giacomobuzi/manipmasta/cad/drawings/png/T00_Copertina_e_indice.png

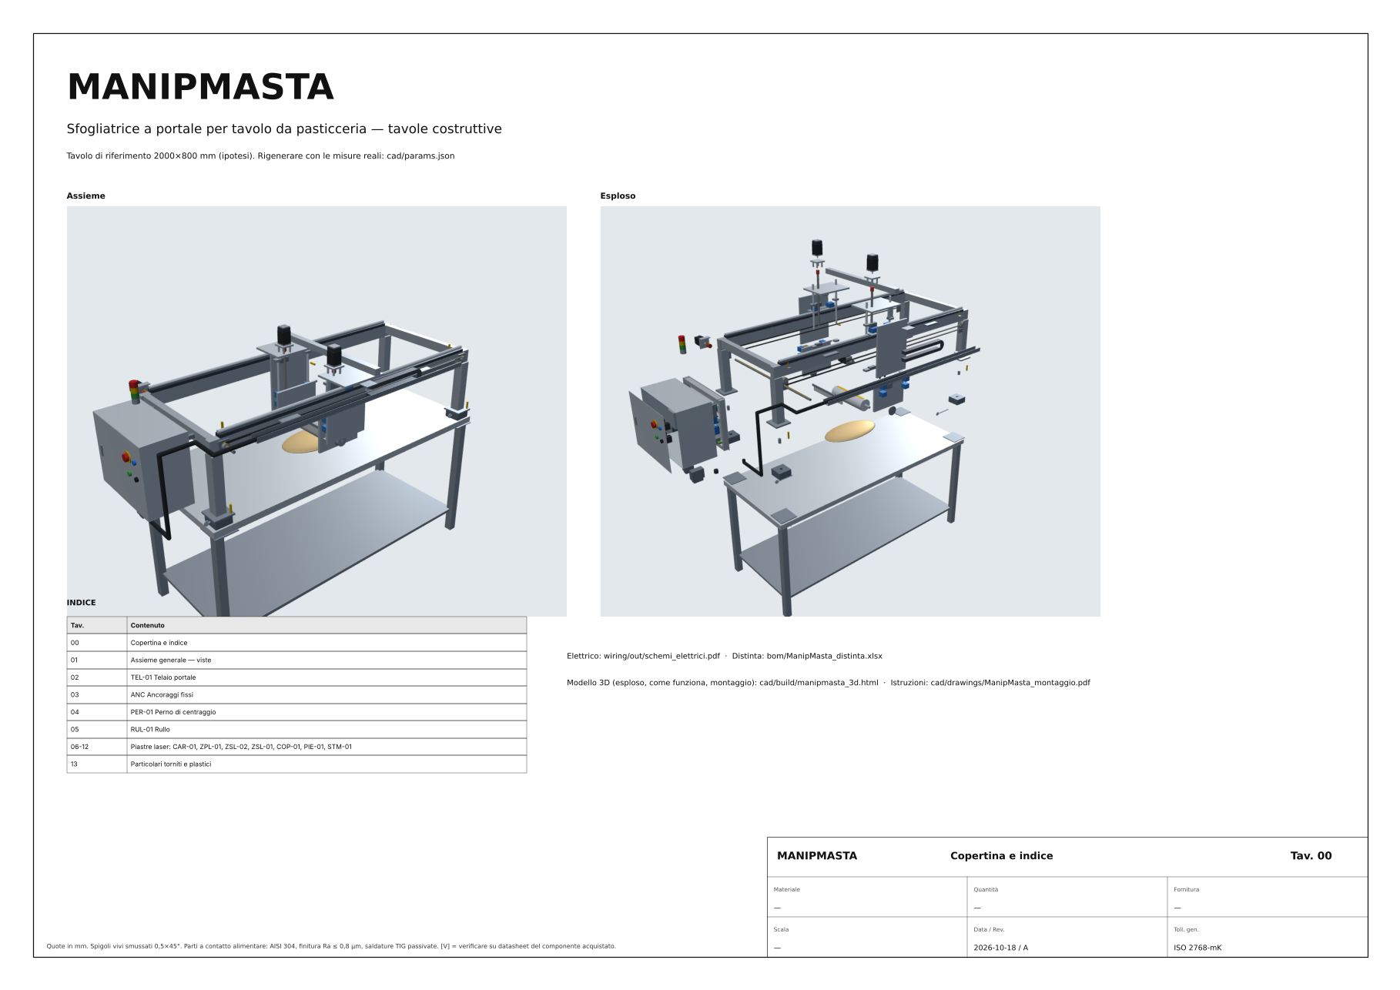
cad/drawings/png/T00_Copertina_e_indice.png
