giacomobuzi/manipmasta/cad/drawings/png/T01_Assieme_generale___viste.png

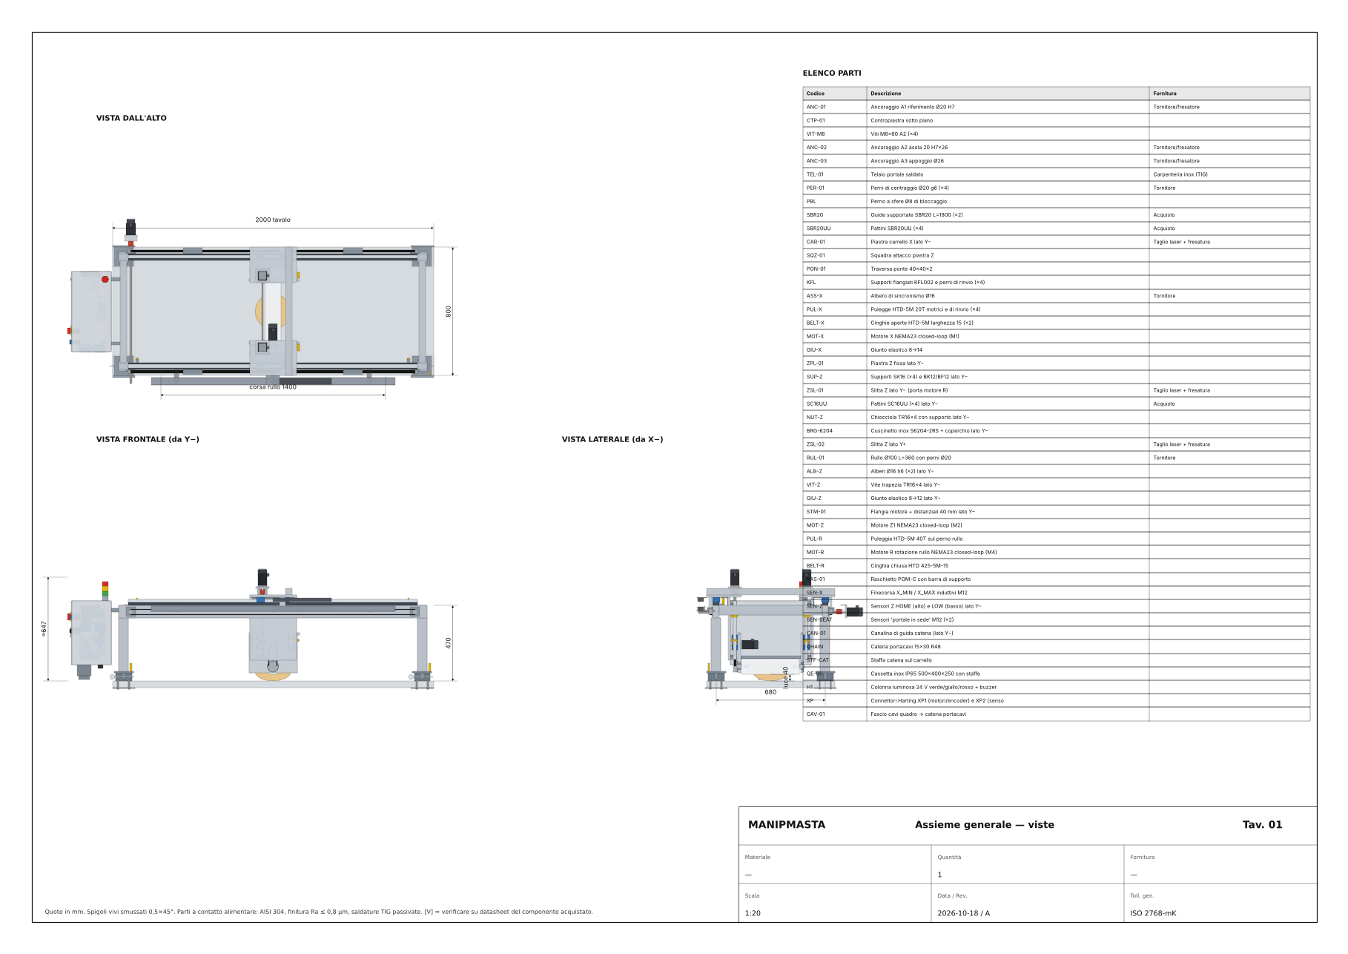
cad/drawings/png/T01_Assieme_generale___viste.png
