giacomobuzi/manipmasta/cad/drawings/png/T02_TEL_01_Telaio_portale_saldato.png

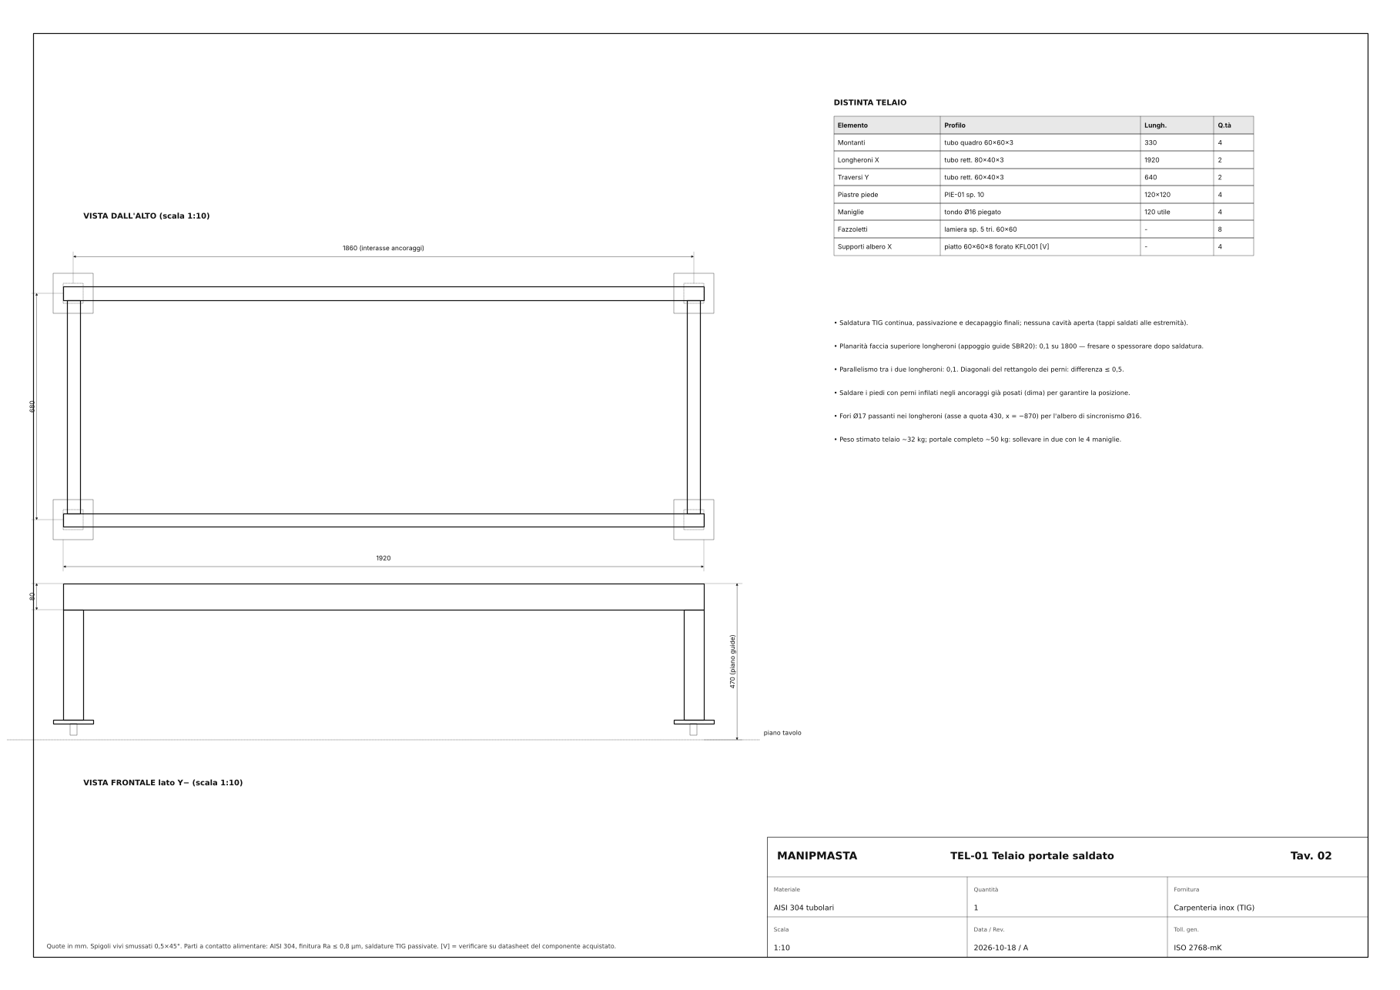
cad/drawings/png/T02_TEL_01_Telaio_portale_saldato.png
