giacomobuzi/manipmasta/cad/drawings/png/T03_ANC_01_02_03_Ancoraggi_fissi_al_tavolo.png

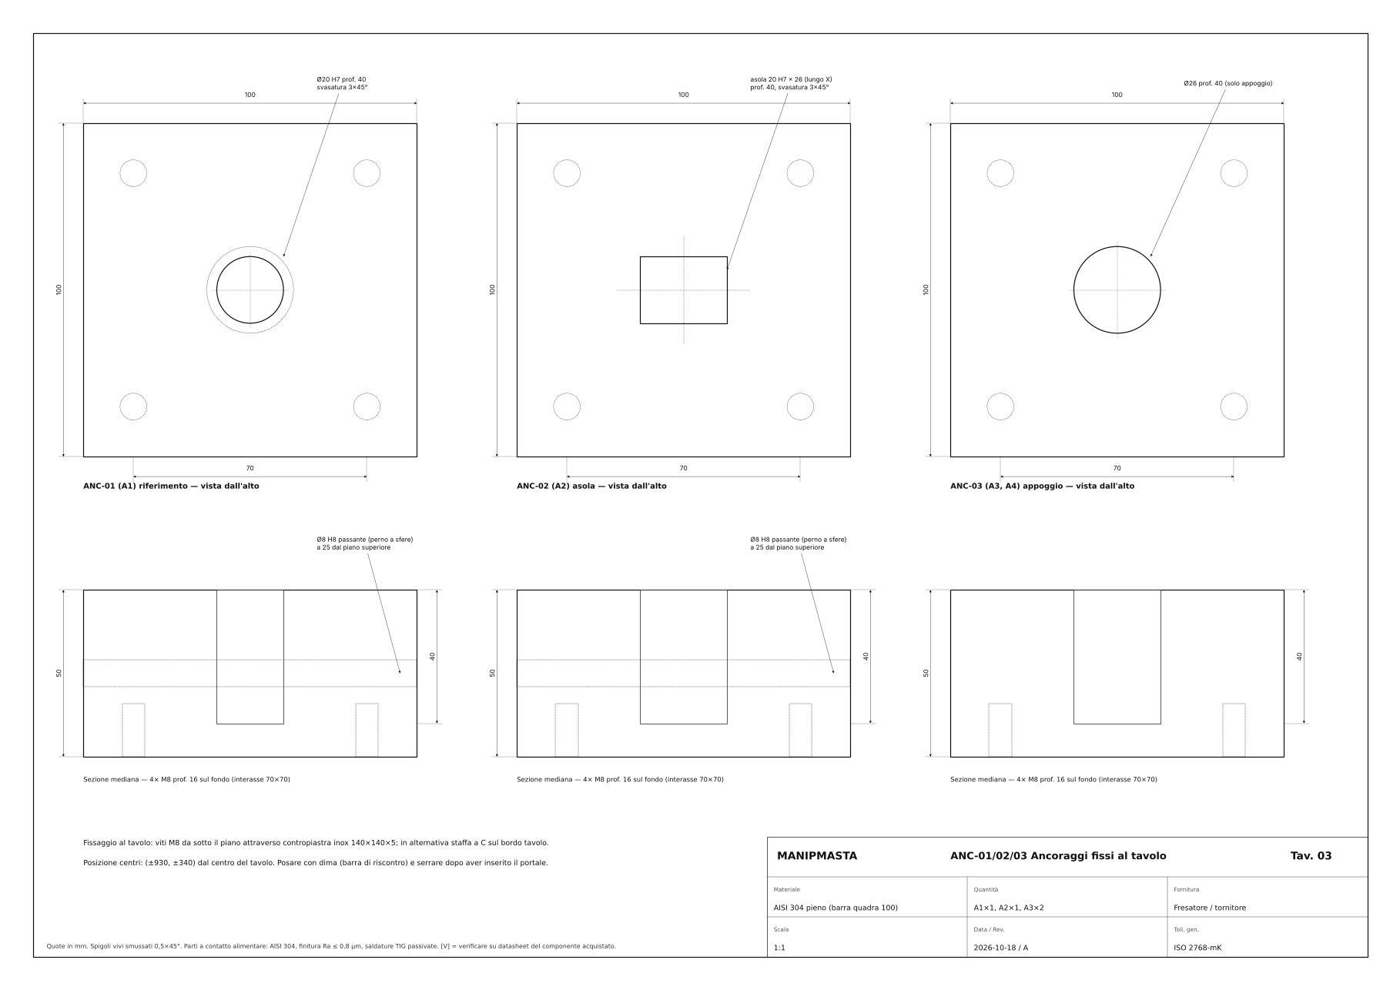
cad/drawings/png/T03_ANC_01_02_03_Ancoraggi_fissi_al_tavolo.png
