giacomobuzi/manipmasta/cad/drawings/png/T04_PER_01_Perno_di_centraggio.png

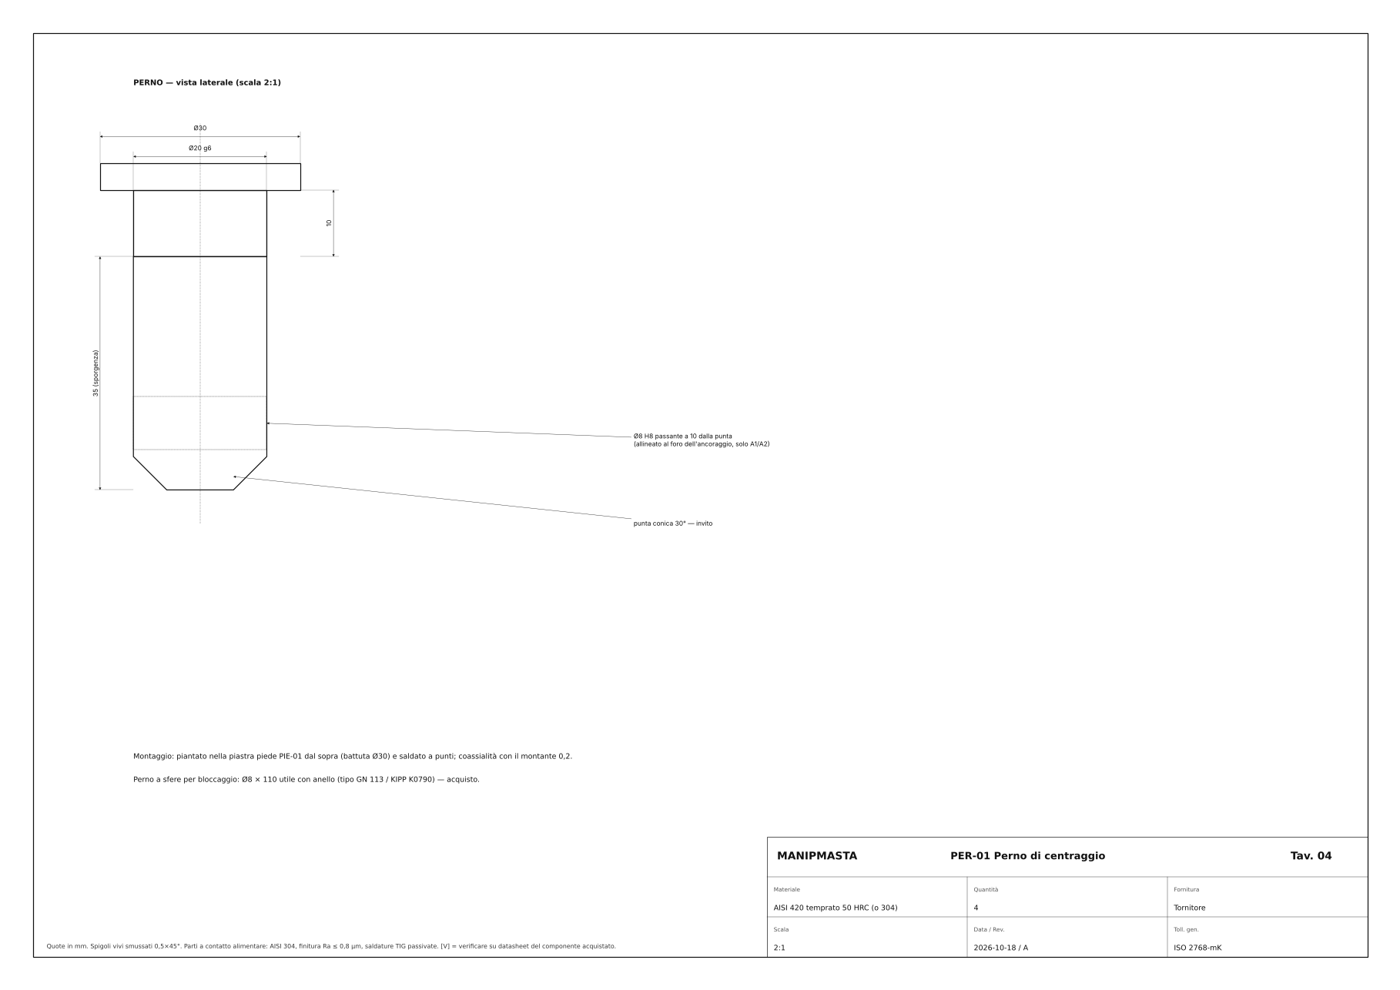
cad/drawings/png/T04_PER_01_Perno_di_centraggio.png
