giacomobuzi/manipmasta/cad/drawings/png/T05_RUL_01_Rullo_di_laminazione.png

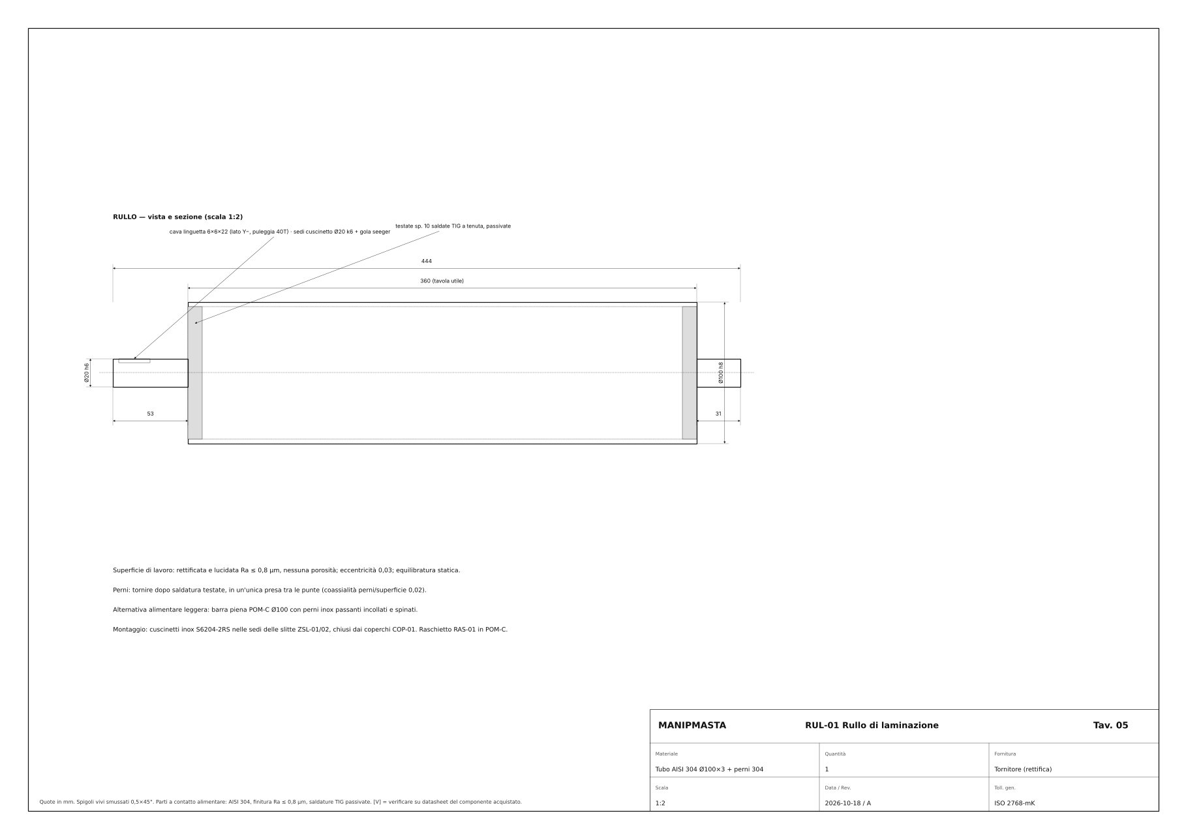
cad/drawings/png/T05_RUL_01_Rullo_di_laminazione.png
