giacomobuzi/manipmasta/cad/drawings/png/T06_CAR_01_Piastra_carrello_X.png

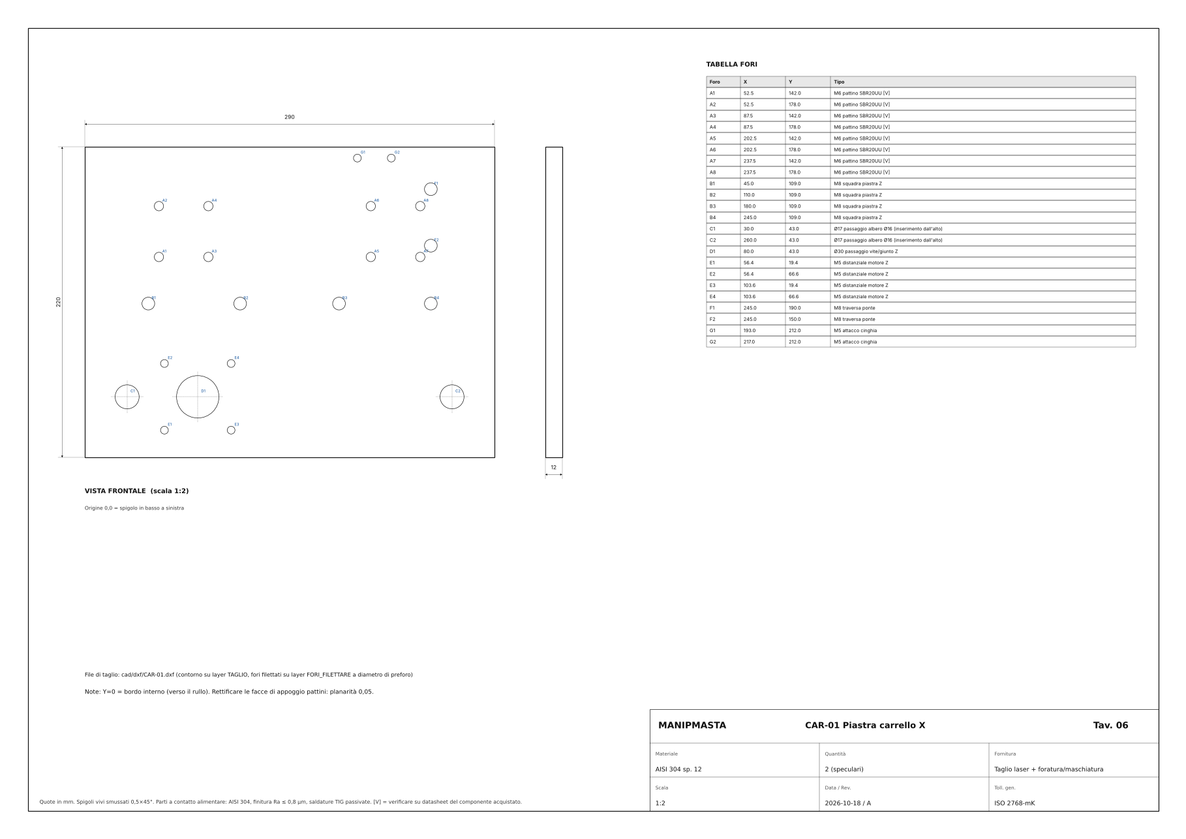
cad/drawings/png/T06_CAR_01_Piastra_carrello_X.png
