giacomobuzi/manipmasta/cad/drawings/png/T07_ZPL_01_Piastra_Z_fissa.png

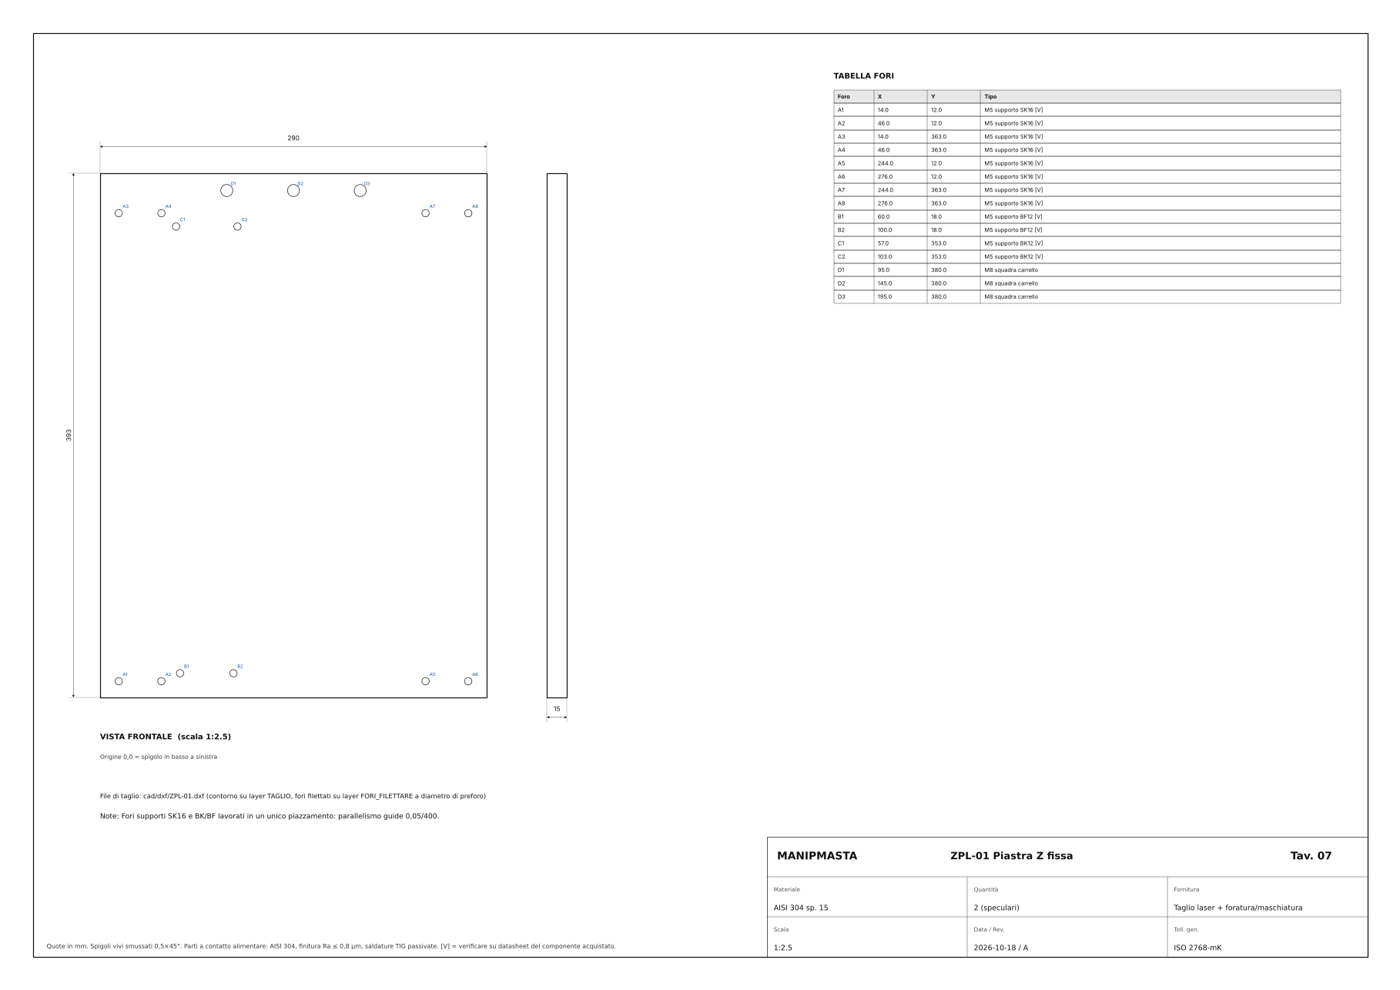
cad/drawings/png/T07_ZPL_01_Piastra_Z_fissa.png
