giacomobuzi/manipmasta/cad/drawings/png/T08_ZSL_02_Slitta_Z_lato_Y___Z2_.png

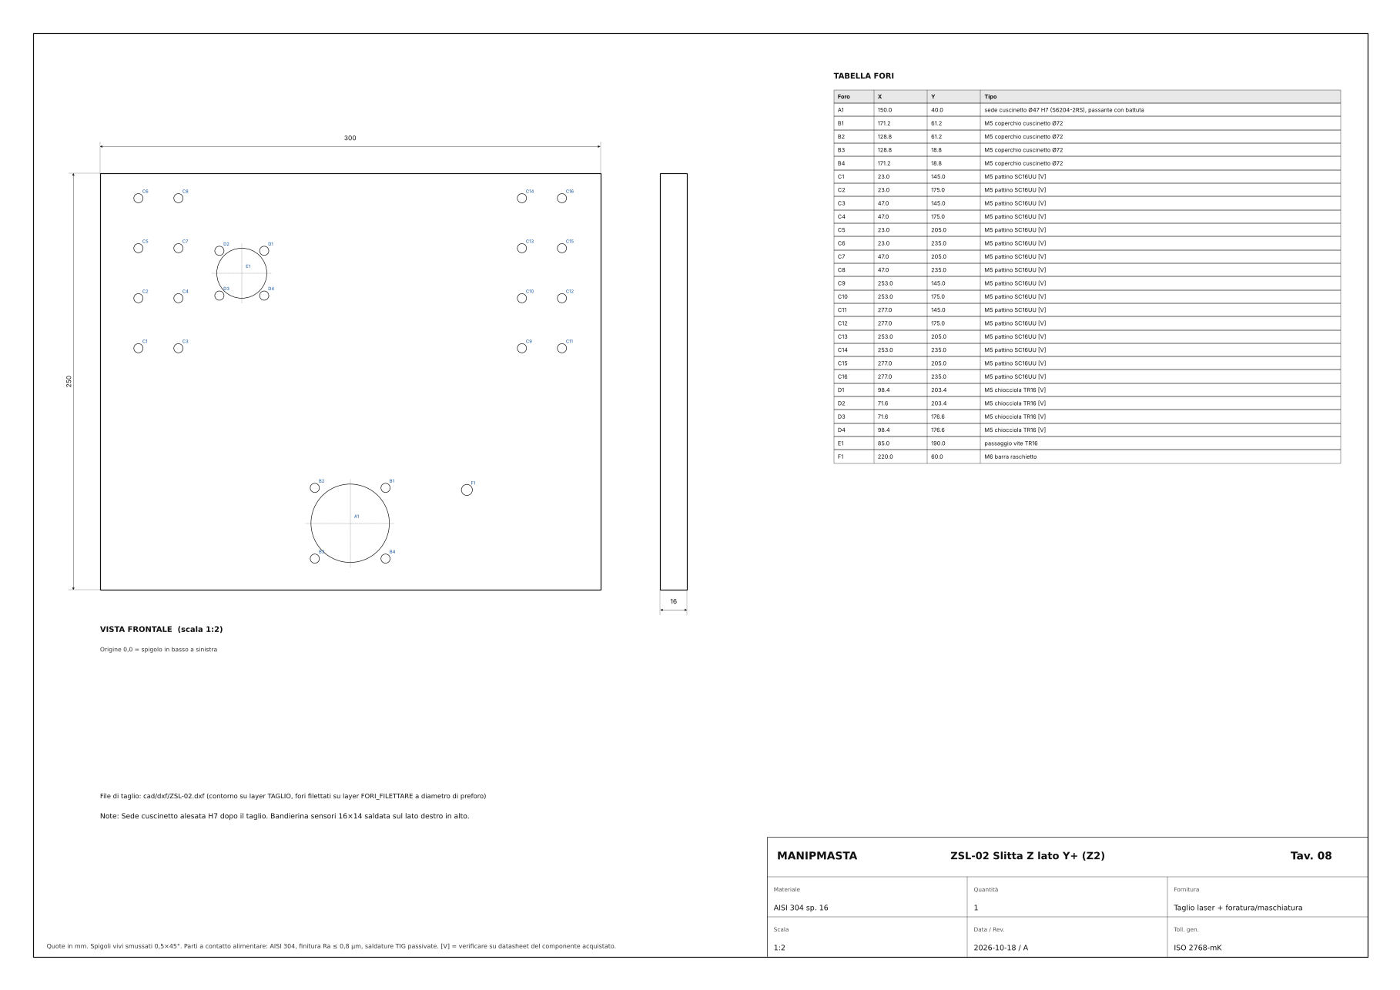
cad/drawings/png/T08_ZSL_02_Slitta_Z_lato_Y___Z2_.png
