giacomobuzi/manipmasta/cad/drawings/png/T09_ZSL_01_Slitta_Z_lato_Y___Z1__con_motore_.png

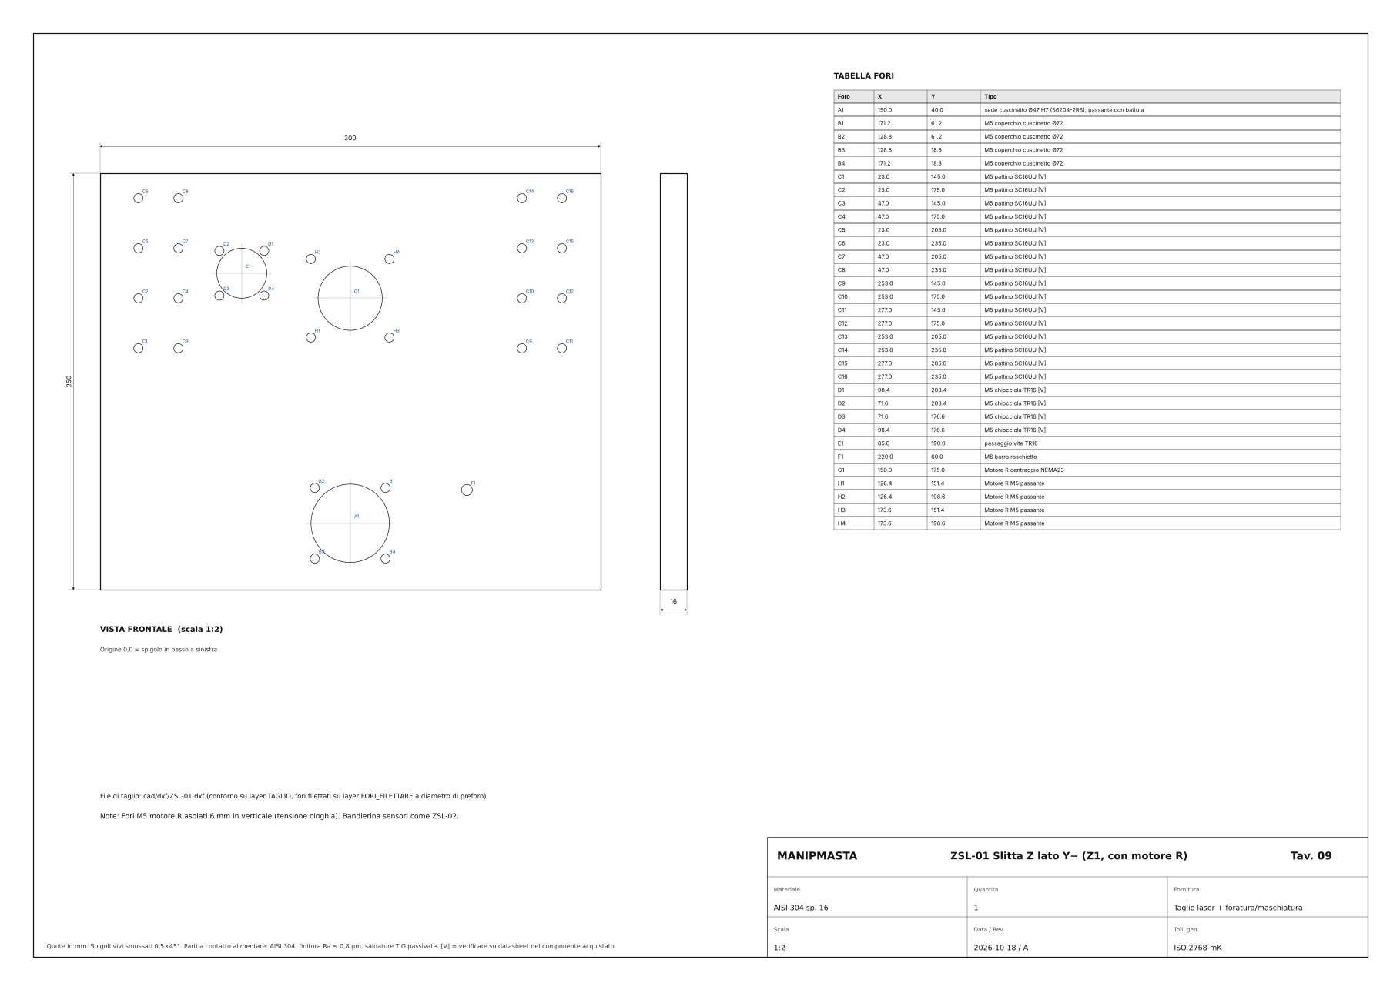
cad/drawings/png/T09_ZSL_01_Slitta_Z_lato_Y___Z1__con_motore_.png
