giacomobuzi/manipmasta/cad/drawings/png/T10_COP_01_Coperchio_cuscinetto_Ø72__disegna.png

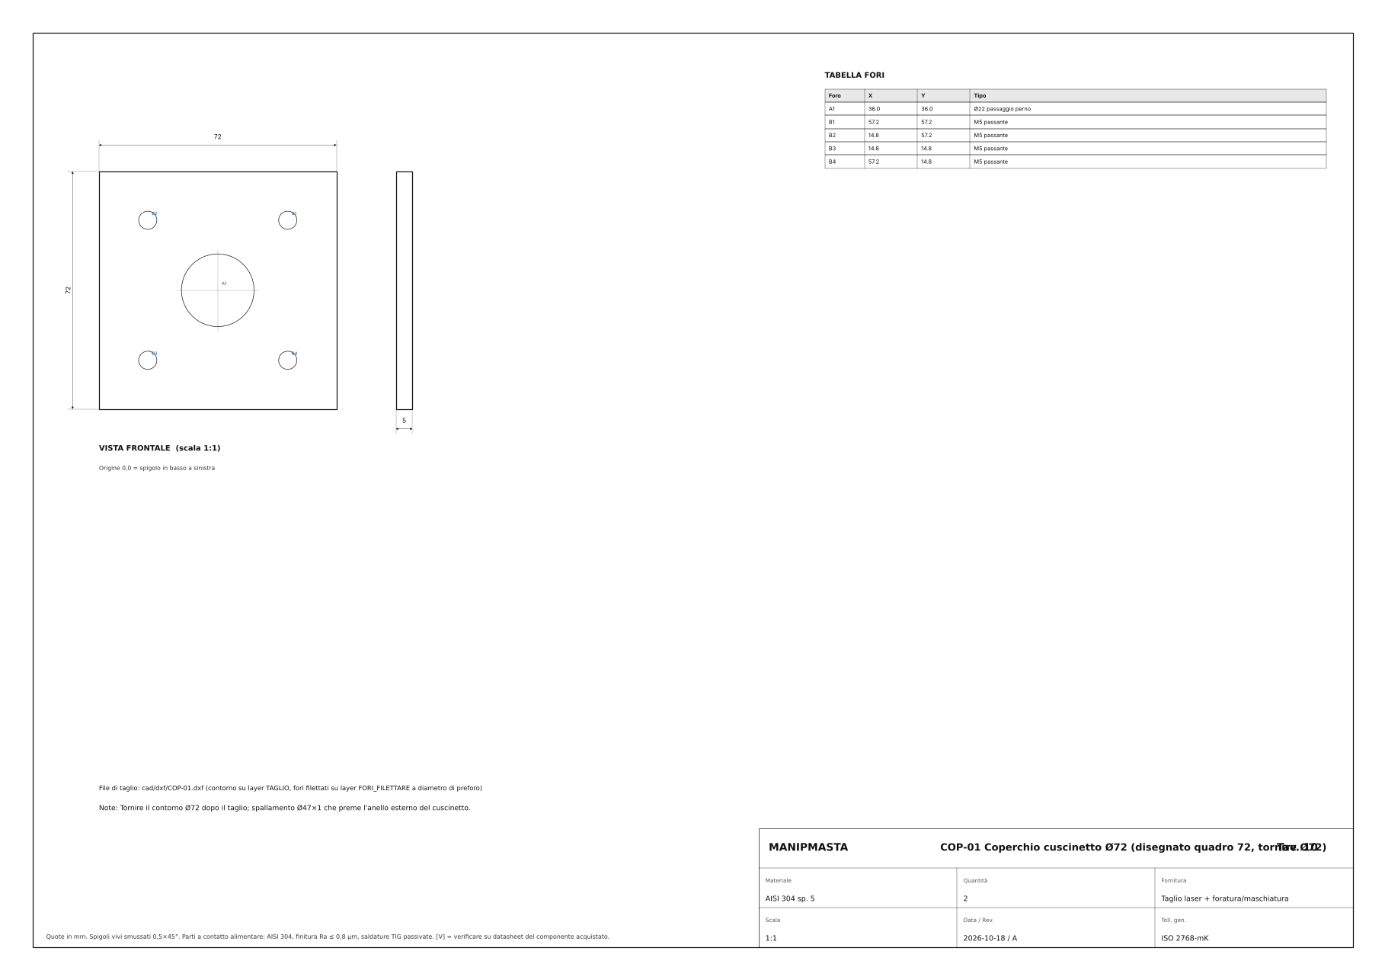
cad/drawings/png/T10_COP_01_Coperchio_cuscinetto_Ø72__disegna.png
