giacomobuzi/manipmasta/cad/drawings/png/T11_PIE_01_Piastra_piede_montante.png

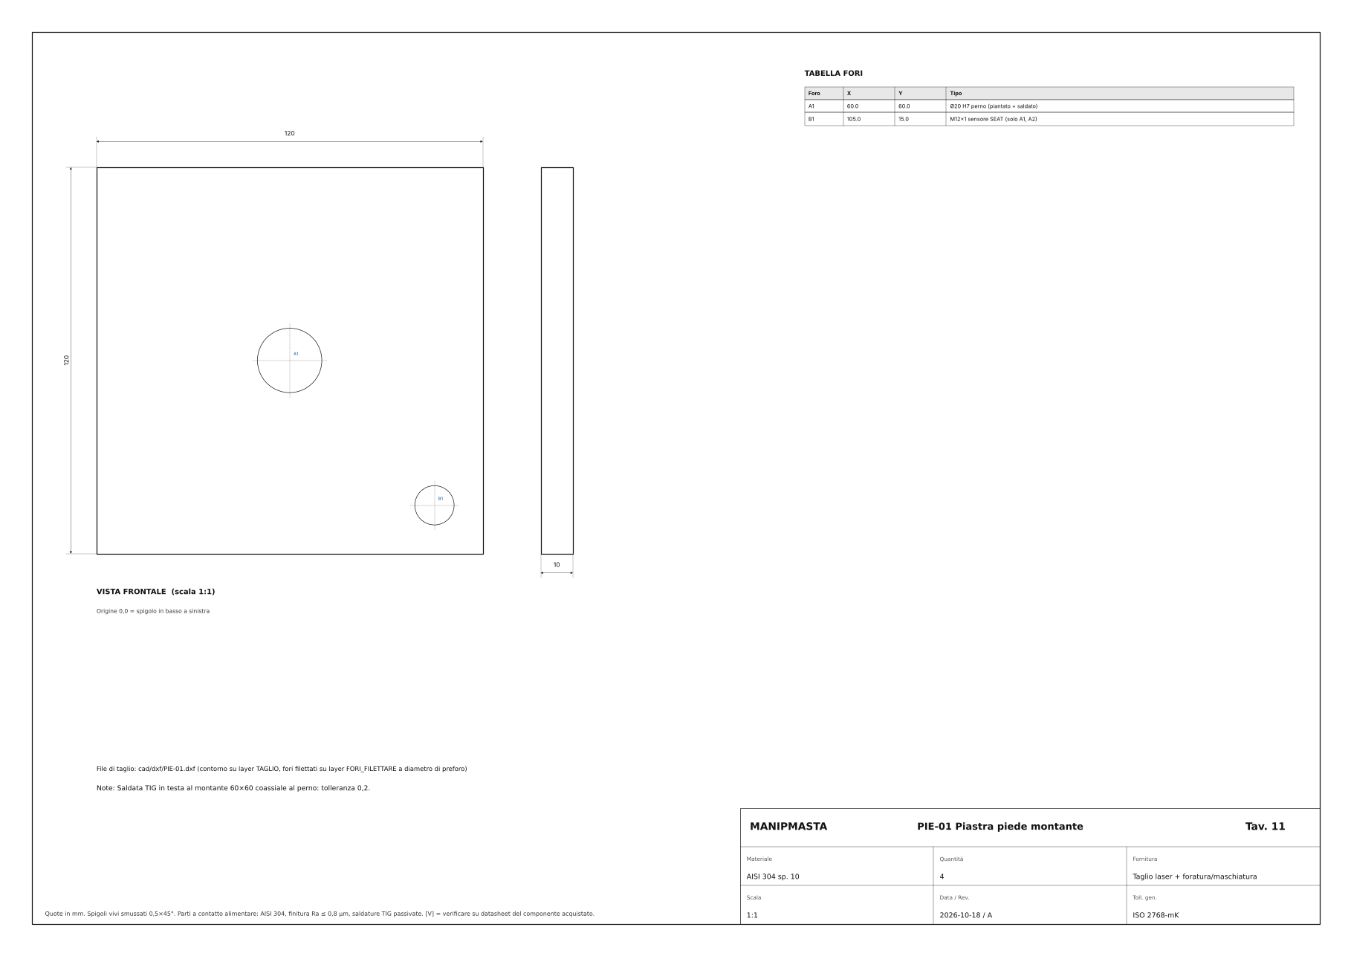
cad/drawings/png/T11_PIE_01_Piastra_piede_montante.png
