giacomobuzi/manipmasta/cad/drawings/png/T12_STM_01_Flangia_motore_NEMA23.png

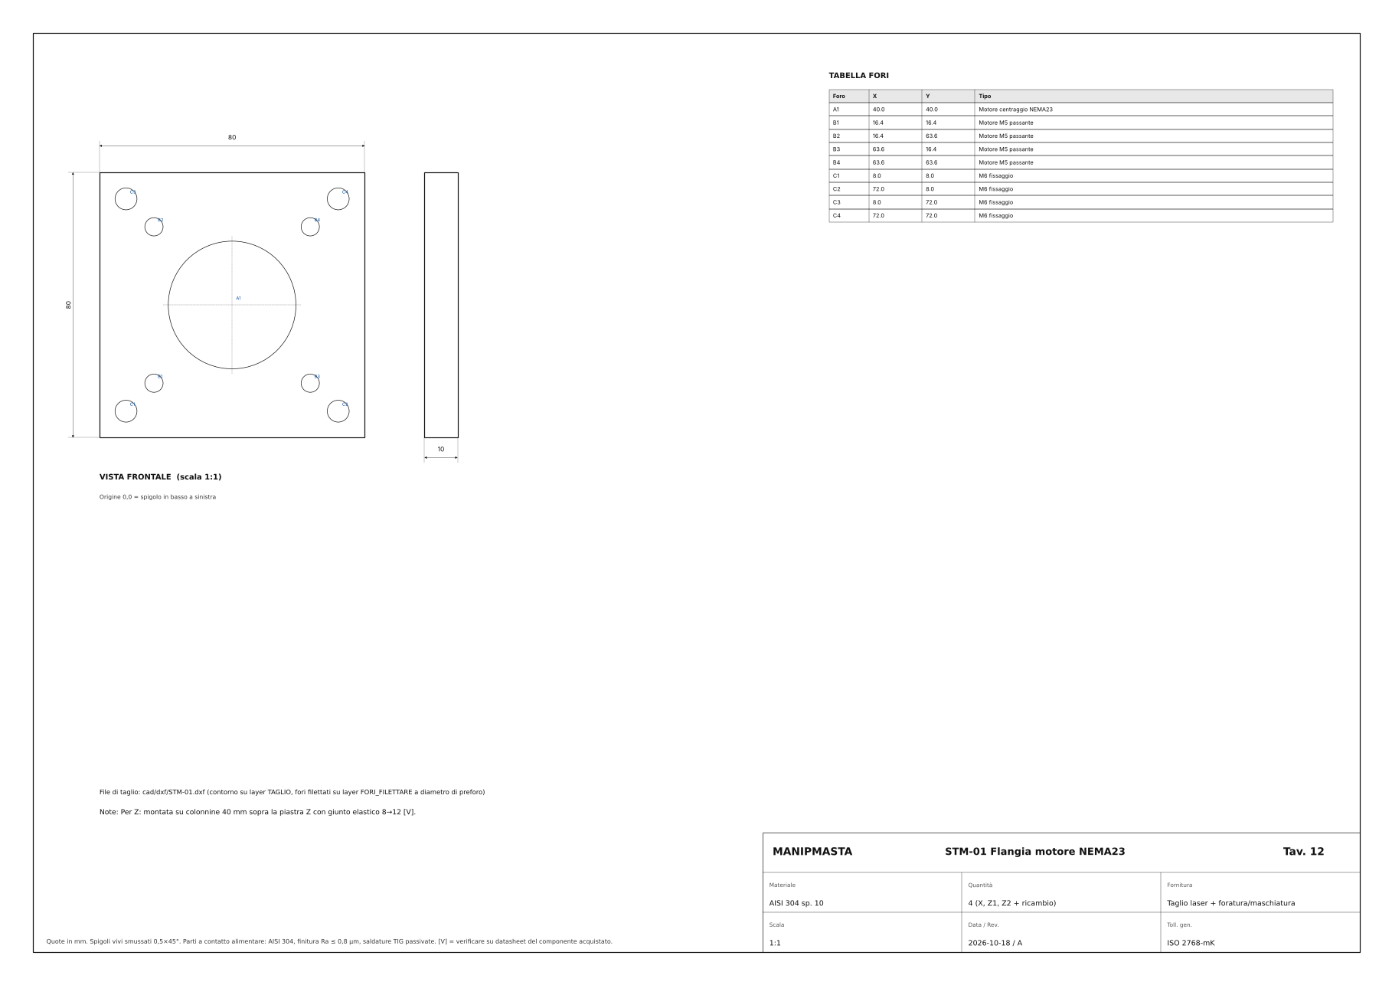
cad/drawings/png/T12_STM_01_Flangia_motore_NEMA23.png
