giacomobuzi/manipmasta/cad/drawings/png/T13_Particolari_torniti_e_plastici.png

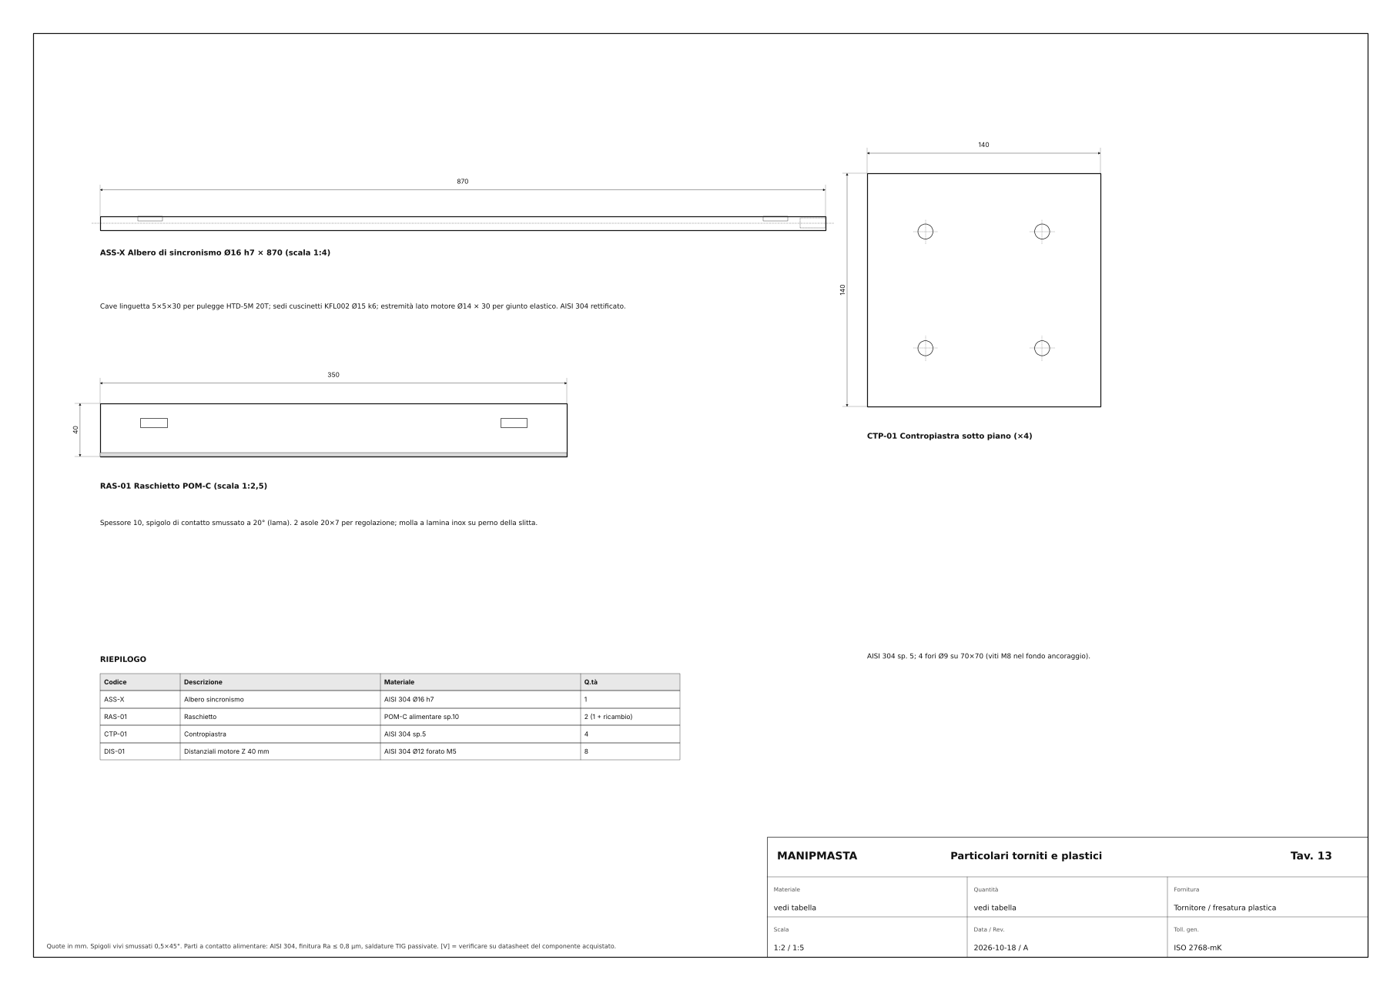
cad/drawings/png/T13_Particolari_torniti_e_plastici.png
