giacomobuzi/manipmasta/docs/img/funziona_ciclo.png

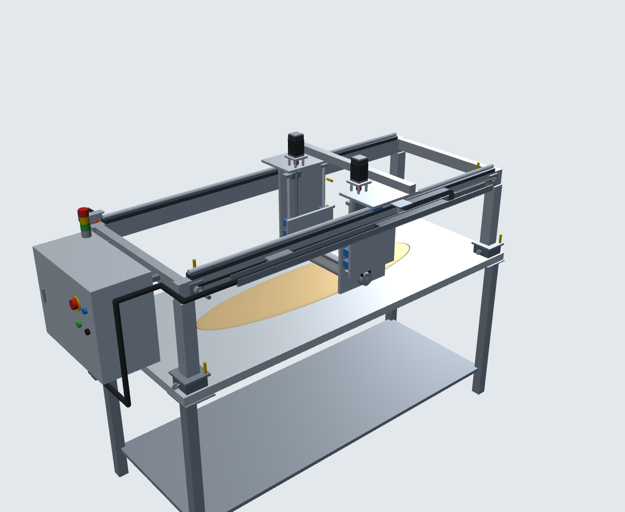
docs/img/funziona_ciclo.png
