giacomobuzi/manipmasta/docs/img/funziona_r.png

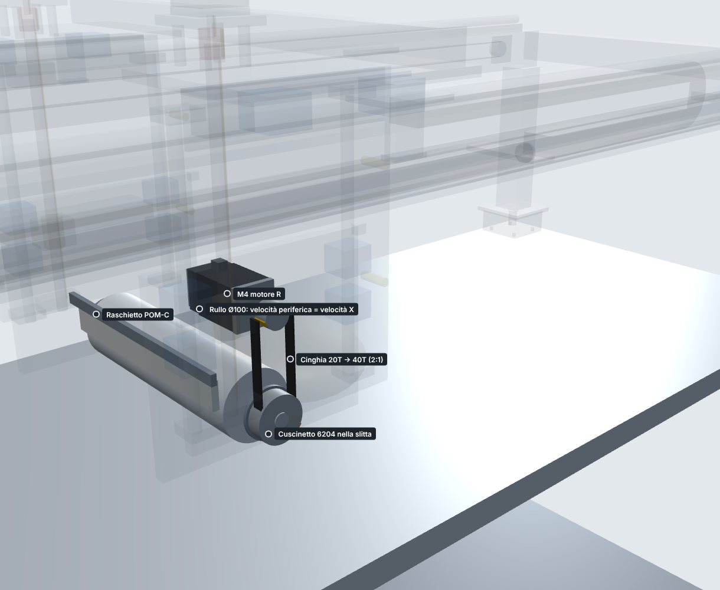
docs/img/funziona_r.png
