giacomobuzi/manipmasta/docs/img/funziona_servo.png

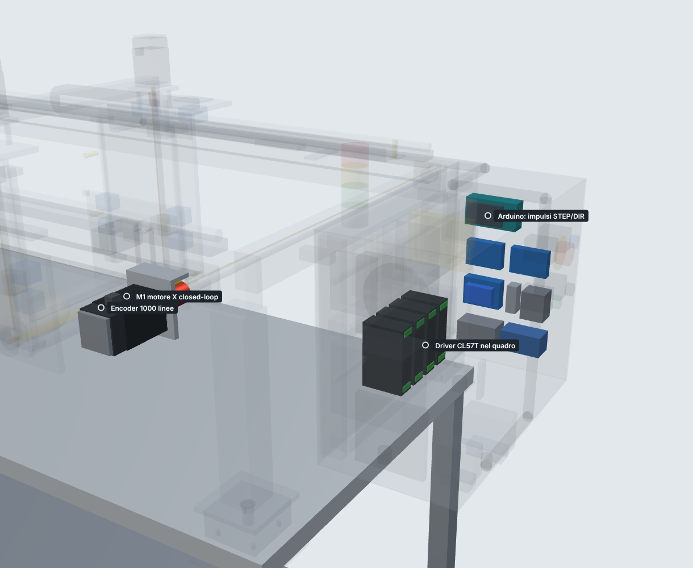
docs/img/funziona_servo.png
