giacomobuzi/manipmasta/docs/img/funziona_x.png

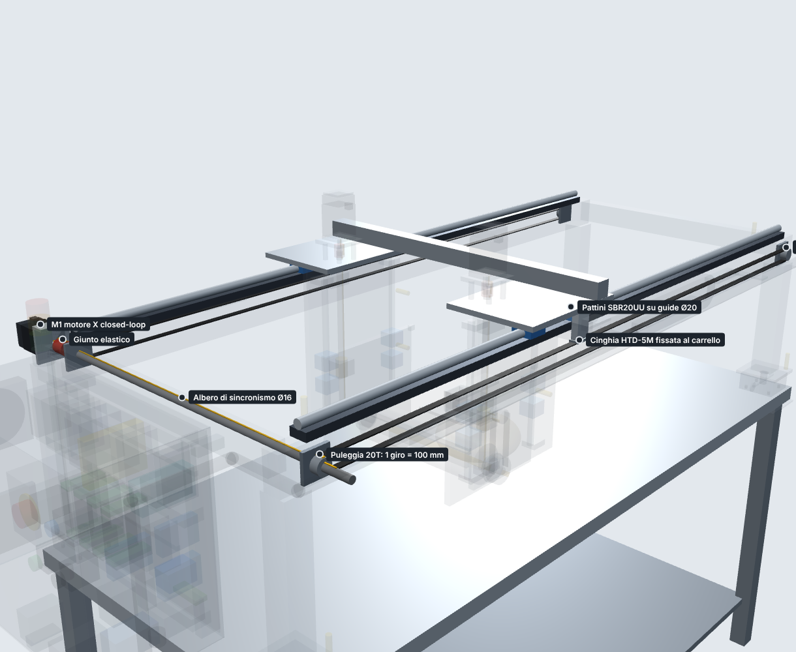
docs/img/funziona_x.png
