giacomobuzi/manipmasta/docs/img/funziona_z.png

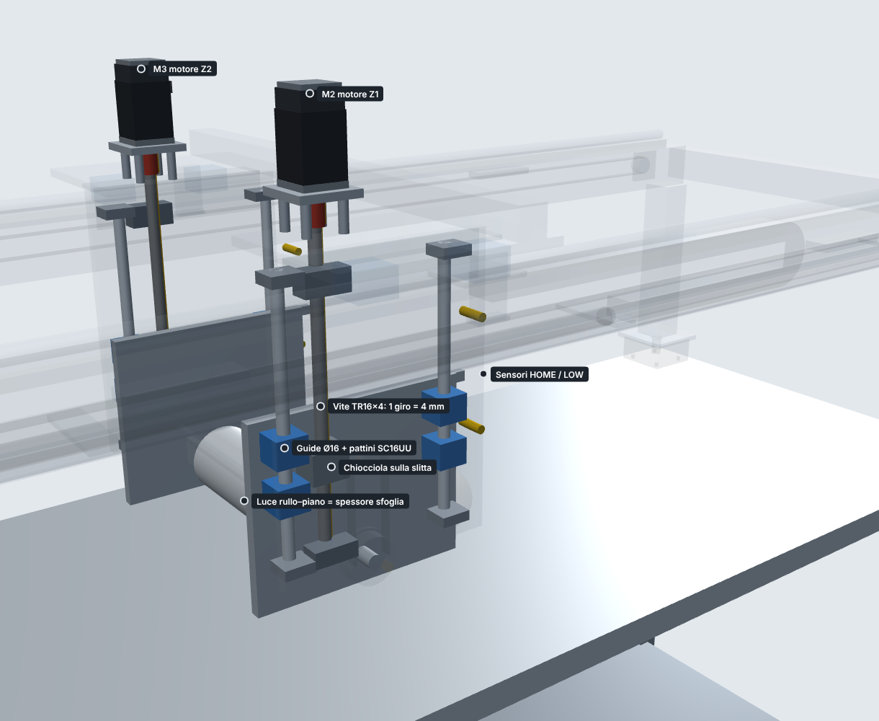
docs/img/funziona_z.png
