giacomobuzi/manipmasta/docs/img/ui_desktop.png

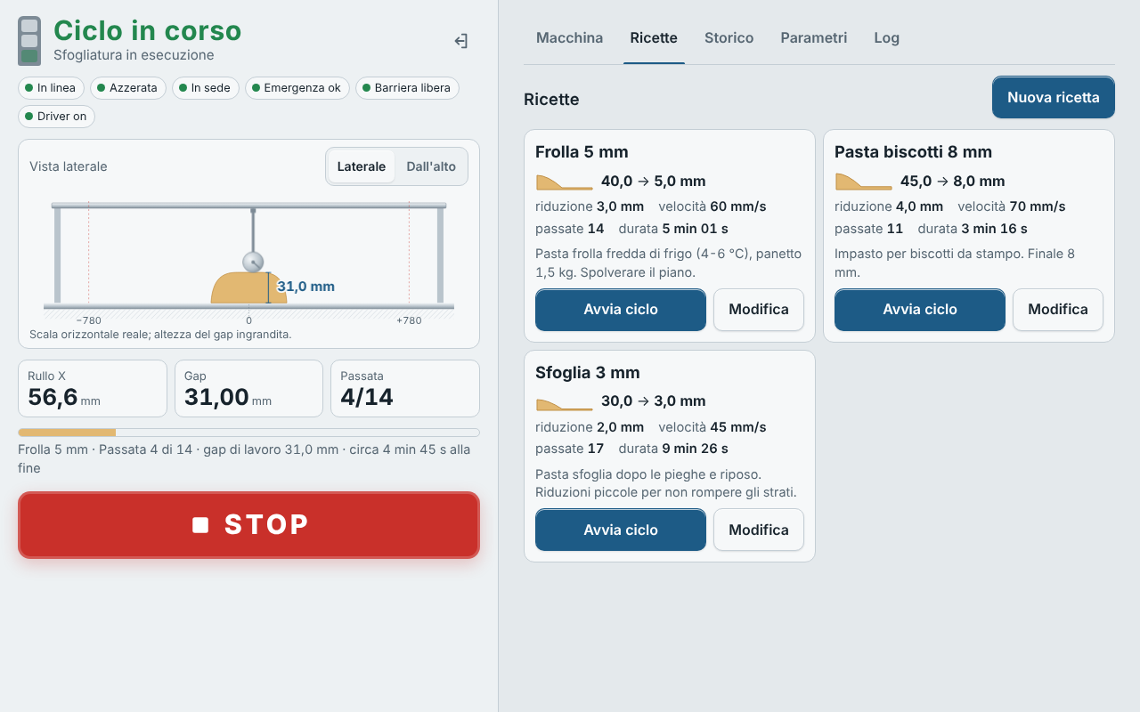
docs/img/ui_desktop.png
