giacomobuzi/manipmasta/docs/img/ui_mobile.png

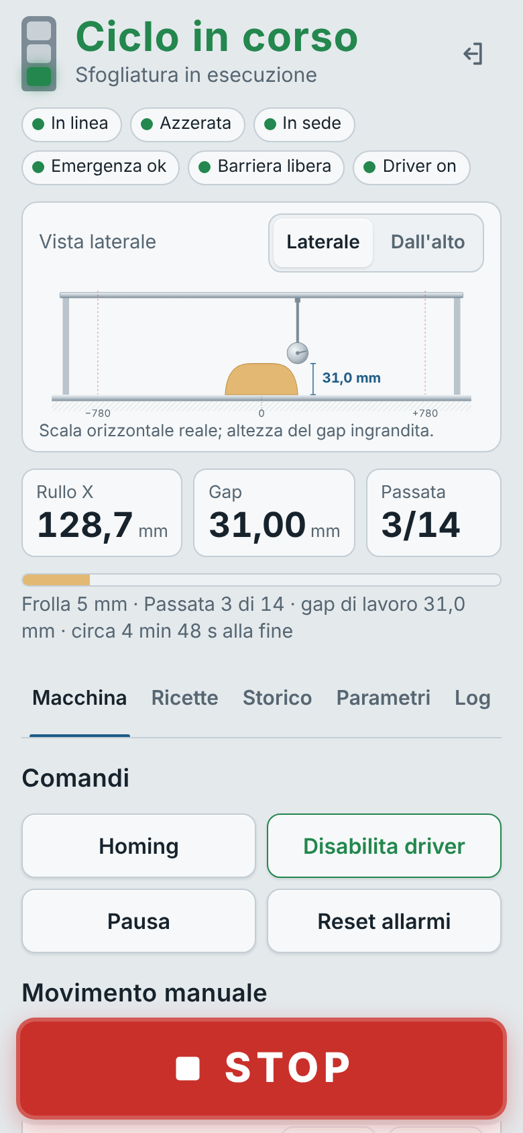
docs/img/ui_mobile.png
