giacomobuzi/manipmasta/docs/img/vista_alto.png

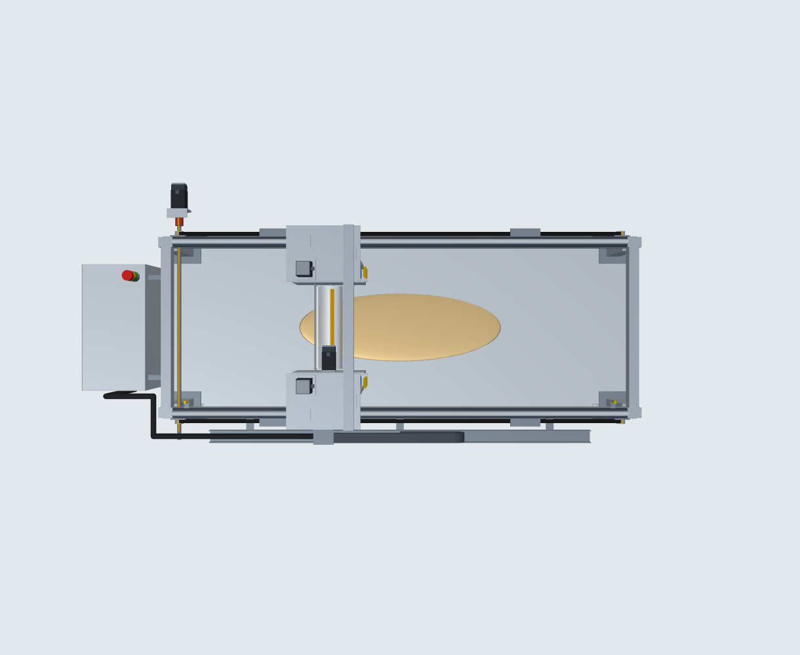
docs/img/vista_alto.png
