giacomobuzi/manipmasta/docs/img/vista_fronte.png

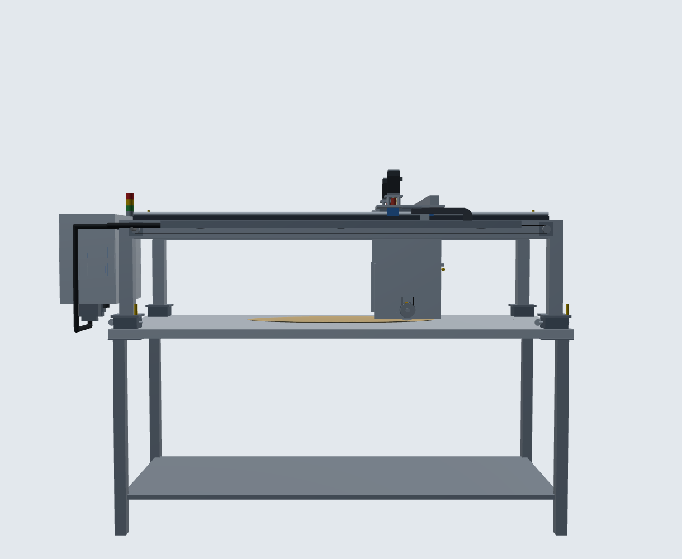
docs/img/vista_fronte.png
