giacomobuzi/manipmasta/cad/dxf/STM-01.dxf

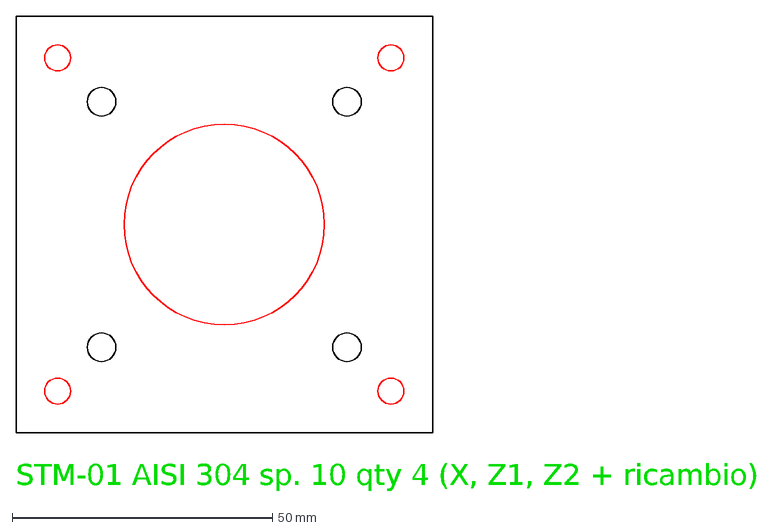
[picture p28: CAD file, 2026-10-18]
cad/dxf/STM-01.dxf
STM-01 AISI 304 sp. 10 qty 4 (X, Z1, Z2 + ricambio)
