giacomobuzi/manipmasta/cad/dxf/PIE-01.dxf

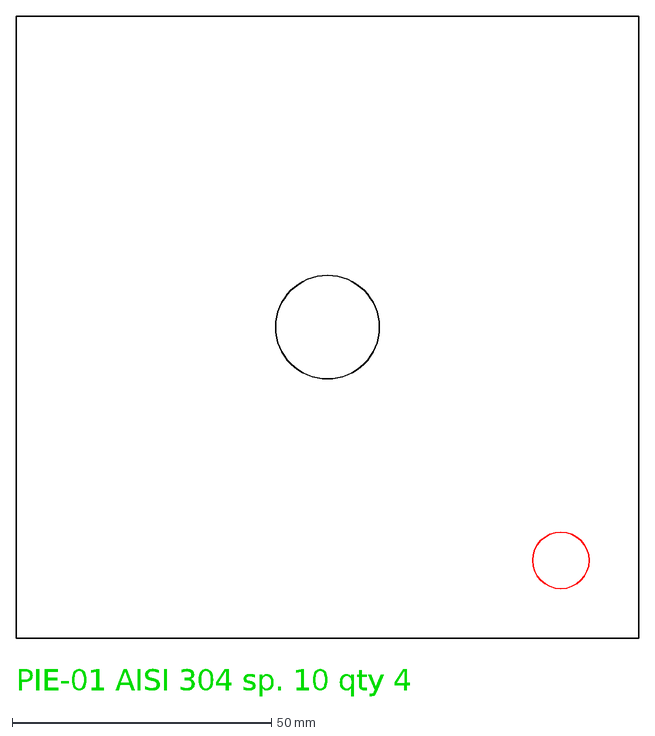
[picture p29: CAD file, 2026-10-18]
cad/dxf/PIE-01.dxf
PIE-01 AISI 304 sp. 10 qty 4
