giacomobuzi/manipmasta/cad/dxf/ZPL-01.dxf

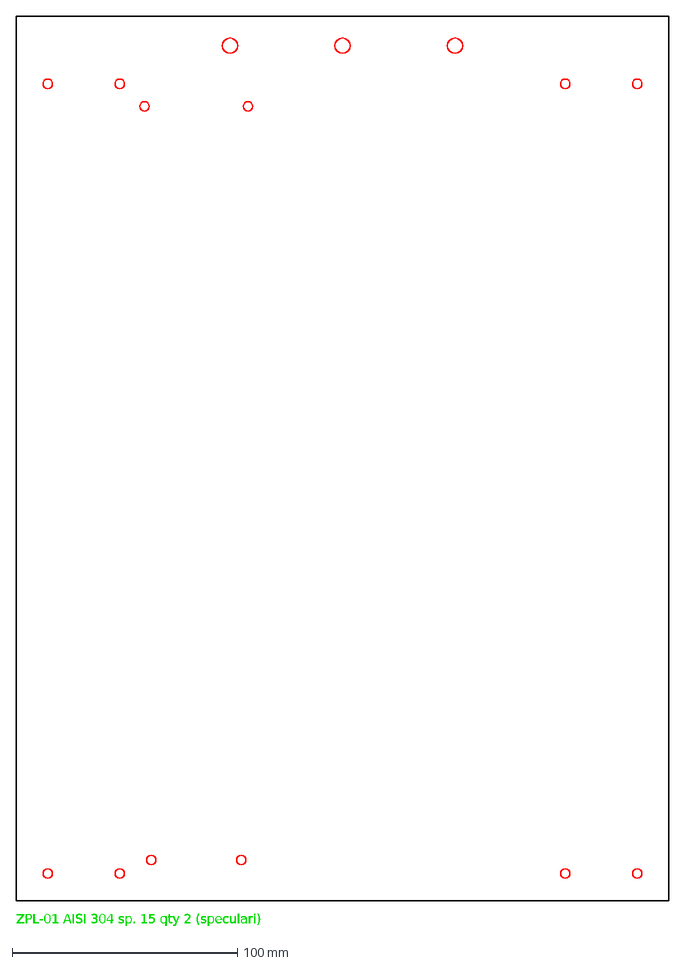
[picture p30: CAD file, 2026-10-18]
cad/dxf/ZPL-01.dxf
ZPL-01 AISI 304 sp. 15 qty 2 (speculari)
