giacomobuzi/manipmasta/cad/dxf/COP-01.dxf

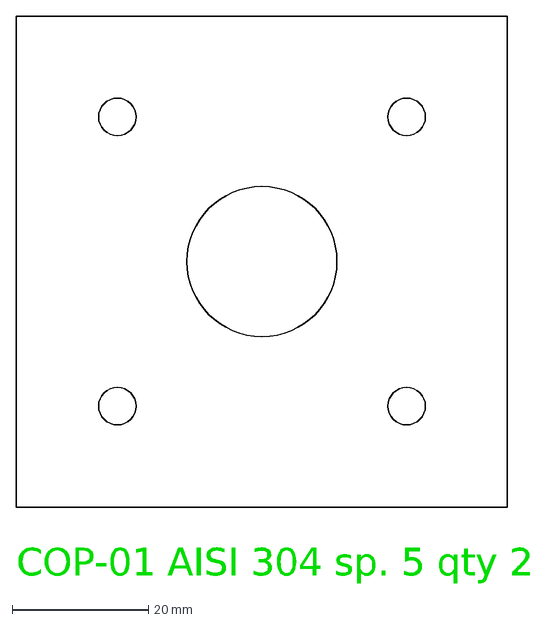
[picture p31: CAD file, 2026-10-18]
cad/dxf/COP-01.dxf
COP-01 AISI 304 sp. 5 qty 2
