giacomobuzi/manipmasta/cad/dxf/ZSL-01.dxf

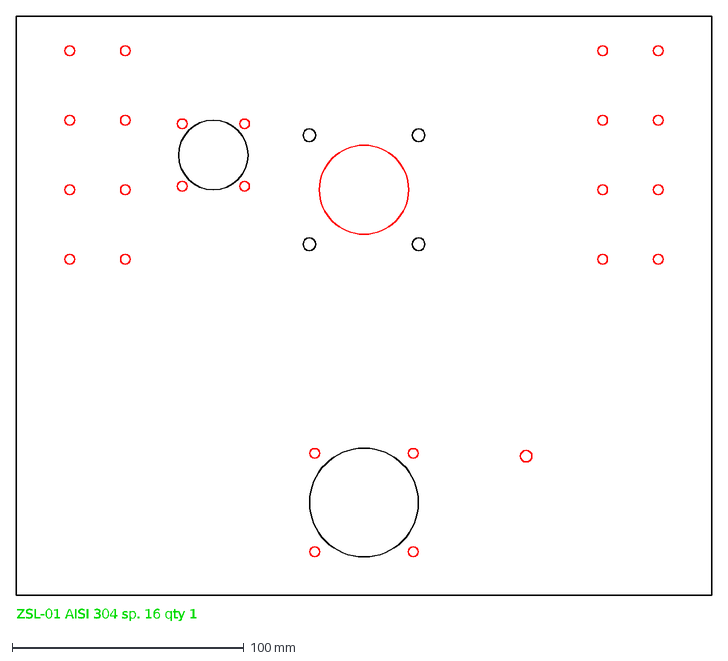
[picture p32: CAD file, 2026-10-18]
cad/dxf/ZSL-01.dxf
ZSL-01 AISI 304 sp. 16 qty 1
