giacomobuzi/manipmasta/cad/dxf/CAR-01.dxf

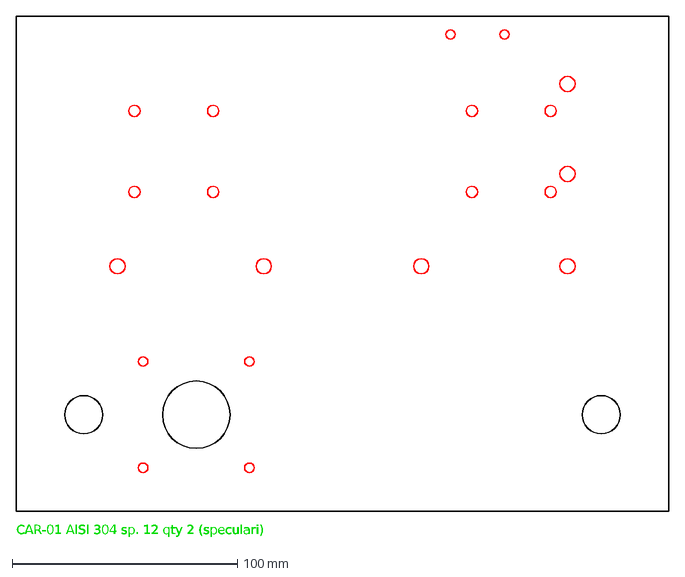
[picture p33: CAD file, 2026-10-18]
cad/dxf/CAR-01.dxf
CAR-01 AISI 304 sp. 12 qty 2 (speculari)
