giacomobuzi/manipmasta/cad/dxf/ZSL-02.dxf

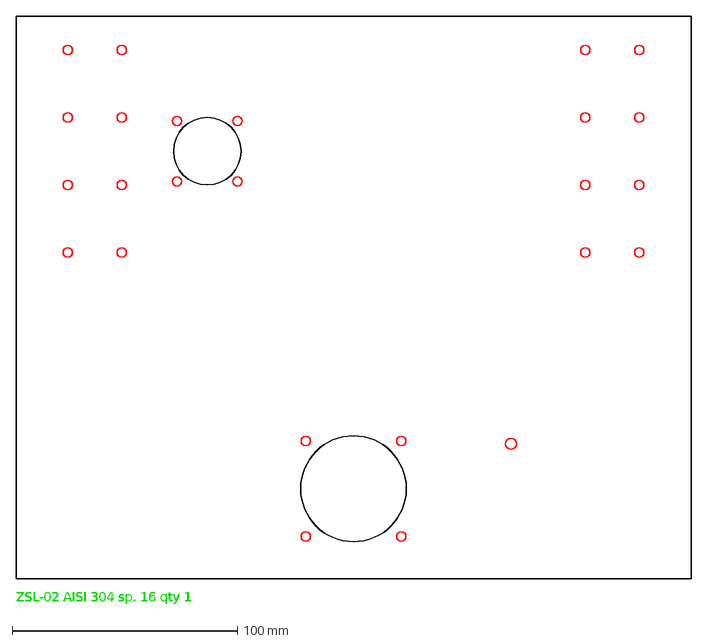
[picture p34: CAD file, 2026-10-18]
cad/dxf/ZSL-02.dxf
ZSL-02 AISI 304 sp. 16 qty 1
