giacomobuzi/manipmasta/cad/build/manipmasta_3d.html

# ManipMasta

Sfogliatrice a portale

IsoFronte LatoAlto

Esploso 0 % Posizione rullo X 0 mm Luce rullo–piano 40.0 mm Simula ciclo

Pausa Chiudi sportello

‹ Prec.

Pausa Succ. ›

Esplora Come funziona Montaggio

—Seleziona un pezzoTocca un componente nella vista o nell'elenco per vederne materiale, fissaggio e fornitura.

## Componenti

Modello concettuale generato da cad/model.py su tavolo ipotetico 2000×800: si rigenera con le misure reali.
