giacomobuzi/manipmasta/wiring/out/schemi_elettrici.pdf

# E01 - Potenza

Rete 230 V 1~ -> Q1 -> Q2 -> X1 -> F1/F2/F3 -> PSU1 (via KM1 + KM2 in serie) / PSU2 / PSU3

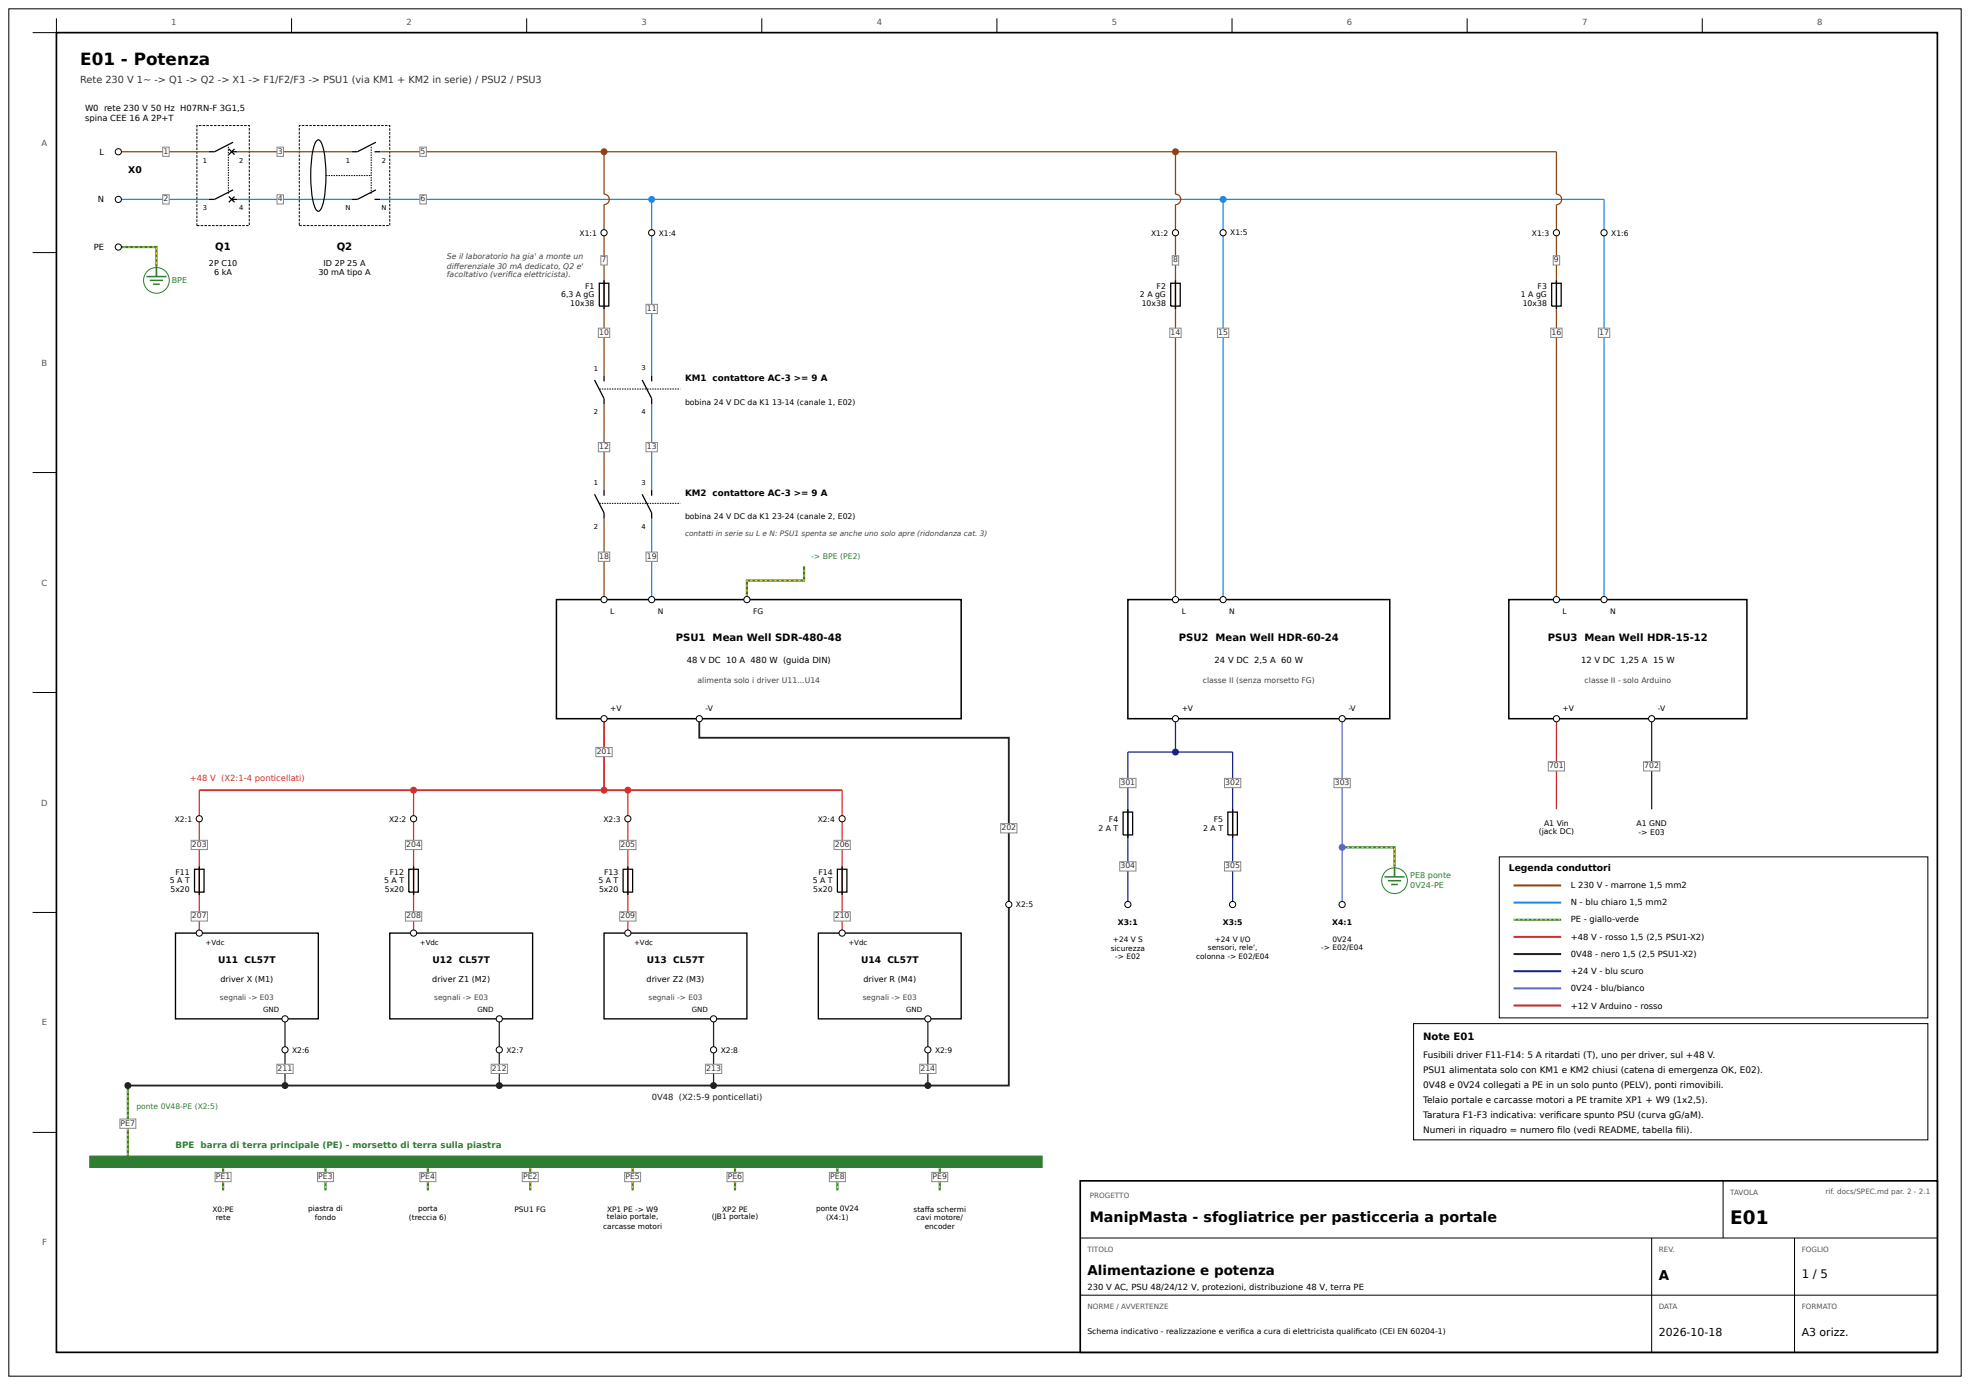
[picture p50: page 1]
W0 rete 230 V 50 Hz H07RN-F 3G1,5 spina CEE 16 A 2P+T; BPE; ID 2P 25 A 30 mA tipo A; KM1 contattore AC-3 >= 9 A; KM2 contattore AC-3 >= 9 A; -> BPE (PE2); +48 V (X2:1-4 ponticellati); 0V48 (X2:5-9 ponticellati); driver X (M1); segnali -> E03; +Vdc; GND; driver Z1 (M2); driver Z2 (M3); driver R (M4); ponte 0V48-PE (X2:5); +24 V S sicurezza -> E02; +24 V I/O sensori, rele', colonna -> E02/E04; PE8 ponte 0V24-PE; A1 Vin (jack DC); A1 GND -> E03; X0:PE rete; piastra di fondo; porta (treccia 6)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

Se il laboratorio ha gia' a monte un
differenziale 30 mA dedicato, Q2 e'
facoltativo (verifica elettricista).

bobina 24 V DC da K1 13-14 (canale 1, E02)

bobina 24 V DC da K1 23-24 (canale 2, E02)

contatti in serie su L e N: PSU1 spenta se anche uno solo apre (ridondanza cat. 3)

PSU1 Mean Well SDR-480-48

PSU2 Mean Well HDR-60-24

PSU3 Mean Well HDR-15-12

48 V DC 10 A 480 W (guida DIN)

alimenta solo i driver U11...U14

classe II (senza morsetto FG)

classe II - solo Arduino

L 230 V - marrone 1,5 mm2
N - blu chiaro 1,5 mm2
PE - giallo-verde
+48 V - rosso 1,5 (2,5 PSU1-X2)
0V48 - nero 1,5 (2,5 PSU1-X2)
+24 V - blu scuro
0V24 - blu/bianco
+12 V Arduino - rosso

Note E01
Fusibili driver F11-F14: 5 A ritardati (T), uno per driver, sul +48 V.
PSU1 alimentata solo con KM1 e KM2 chiusi (catena di emergenza OK, E02).
0V48 e 0V24 collegati a PE in un solo punto (PELV), ponti rimovibili.
Telaio portale e carcasse motori a PE tramite XP1 + W9 (1x2,5).
Taratura F1-F3 indicativa: verificare spunto PSU (curva gG/aM).
Numeri in riquadro = numero filo (vedi README, tabella fili).

BPE barra di terra principale (PE) - morsetto di terra sulla piastra

rif. docs/SPEC.md par. 2 - 2.1

PROGETTO
ManipMasta - sfogliatrice per pasticceria a portale

230 V AC, PSU 48/24/12 V, protezioni, distribuzione 48 V, terra PE

Schema indicativo - realizzazione e verifica a cura di elettricista qualificato (CEI EN 60204-1)

# E02 - Sicurezza

Emergenza e barriera: arresto cat. 0 per apertura di KM1 + KM2 in serie (48 V ai driver) + segnalazione all'Arduino (D2, D3)

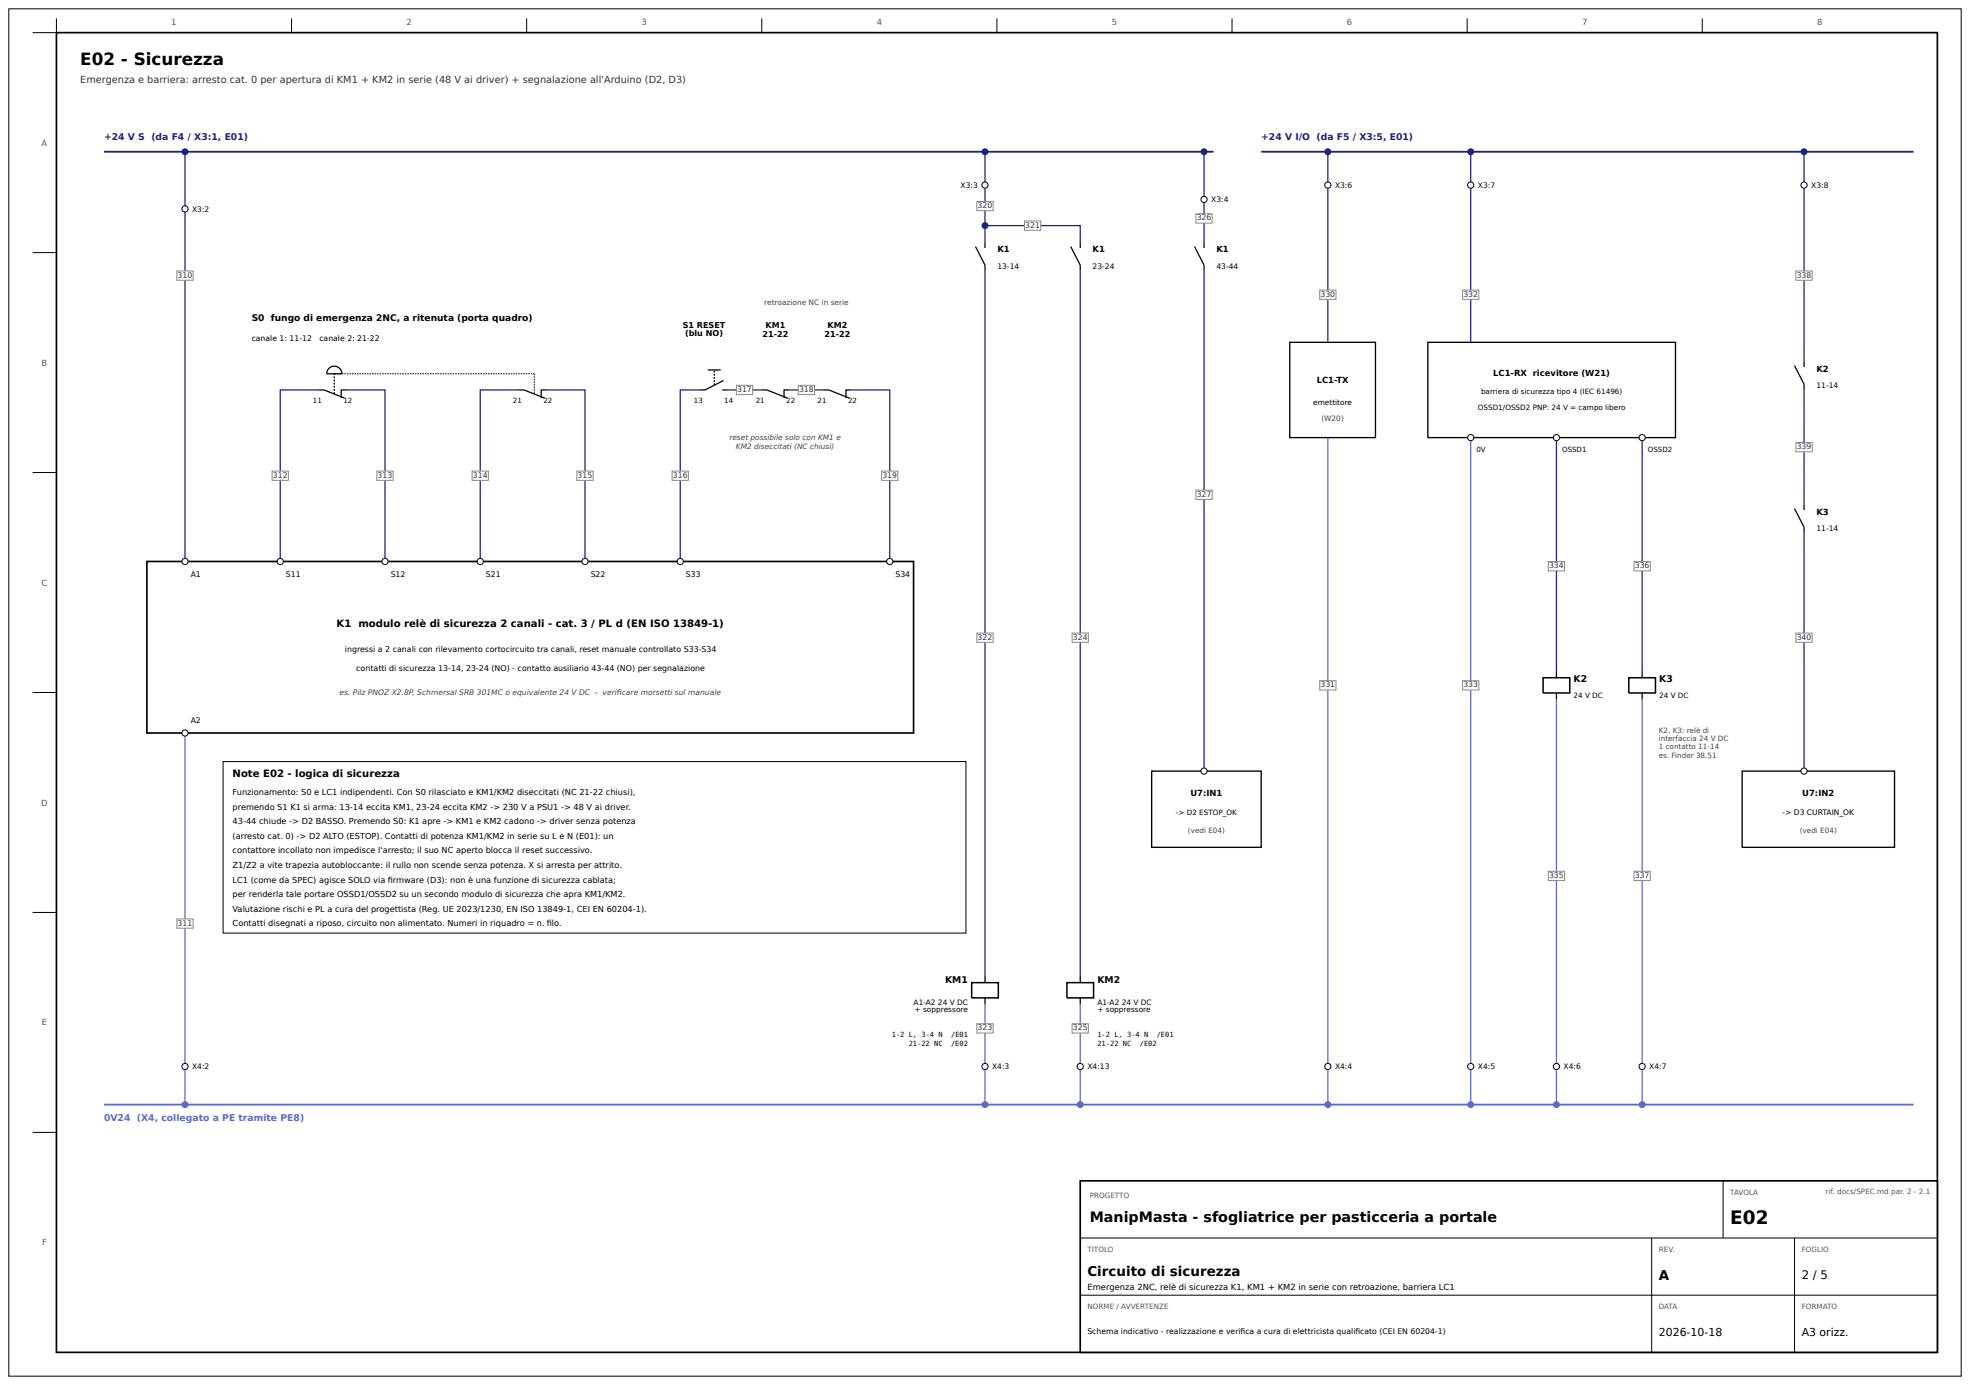
[picture p51: page 2]
canale 1: 11-12 canale 2: 21-22; S1 RESET (blu NO); A1-A2 24 V DC + soppressore; -> D2 ESTOP_OK; (vedi E04); emettitore; LC1-RX ricevitore (W21); OSSD1; OSSD2; K2, K3: relè di interfaccia 24 V DC 1 contatto 11-14 es. Finder 38.51; -> D3 CURTAIN_OK; TAVOLA E02; REV. A; FOGLIO

retroazione NC in serie

S0 fungo di emergenza 2NC, a ritenuta (porta quadro)

barriera di sicurezza tipo 4 (IEC 61496)

OSSD1/OSSD2 PNP: 24 V = campo libero

reset possibile solo con KM1 e
KM2 diseccitati (NC chiusi)

K1 modulo relè di sicurezza 2 canali - cat. 3 / PL d (EN ISO 13849-1)

ingressi a 2 canali con rilevamento cortocircuito tra canali, reset manuale controllato S33-S34

contatti di sicurezza 13-14, 23-24 (NO) - contatto ausiliario 43-44 (NO) per segnalazione

es. Pilz PNOZ X2.8P, Schmersal SRB 301MC o equivalente 24 V DC - verificare morsetti sul manuale

Note E02 - logica di sicurezza

Funzionamento: S0 e LC1 indipendenti. Con S0 rilasciato e KM1/KM2 diseccitati (NC 21-22 chiusi),
premendo S1 K1 si arma: 13-14 eccita KM1, 23-24 eccita KM2 -> 230 V a PSU1 -> 48 V ai driver.
43-44 chiude -> D2 BASSO. Premendo S0: K1 apre -> KM1 e KM2 cadono -> driver senza potenza
(arresto cat. 0) -> D2 ALTO (ESTOP). Contatti di potenza KM1/KM2 in serie su L e N (E01): un
contattore incollato non impedisce l'arresto; il suo NC aperto blocca il reset successivo.
Z1/Z2 a vite trapezia autobloccante: il rullo non scende senza potenza. X si arresta per attrito.
LC1 (come da SPEC) agisce SOLO via firmware (D3): non è una funzione di sicurezza cablata;
per renderla tale portare OSSD1/OSSD2 su un secondo modulo di sicurezza che apra KM1/KM2.
Valutazione rischi e PL a cura del progettista (Reg. UE 2023/1230, EN ISO 13849-1, CEI EN 60204-1).
Contatti disegnati a riposo, circuito non alimentato. Numeri in riquadro = n. filo.

0V24 (X4, collegato a PE tramite PE8)

rif. docs/SPEC.md par. 2 - 2.1

PROGETTO
ManipMasta - sfogliatrice per pasticceria a portale

TITOLO
Circuito di sicurezza
Emergenza 2NC, relè di sicurezza K1, KM1 + KM2 in serie con retroazione, barriera LC1

# E03 - Arduino e driver

Ingressi CL57T optoisolati 5 V a catodo comune: X+ <- pin Arduino, X- -> GND logica (X6). ENA: pin ALTO = driver DISABILITATO (pull-up R1-R4 680 Ohm). ALM: opto -> pin INPUT_PULLUP, BASSO = allarme.

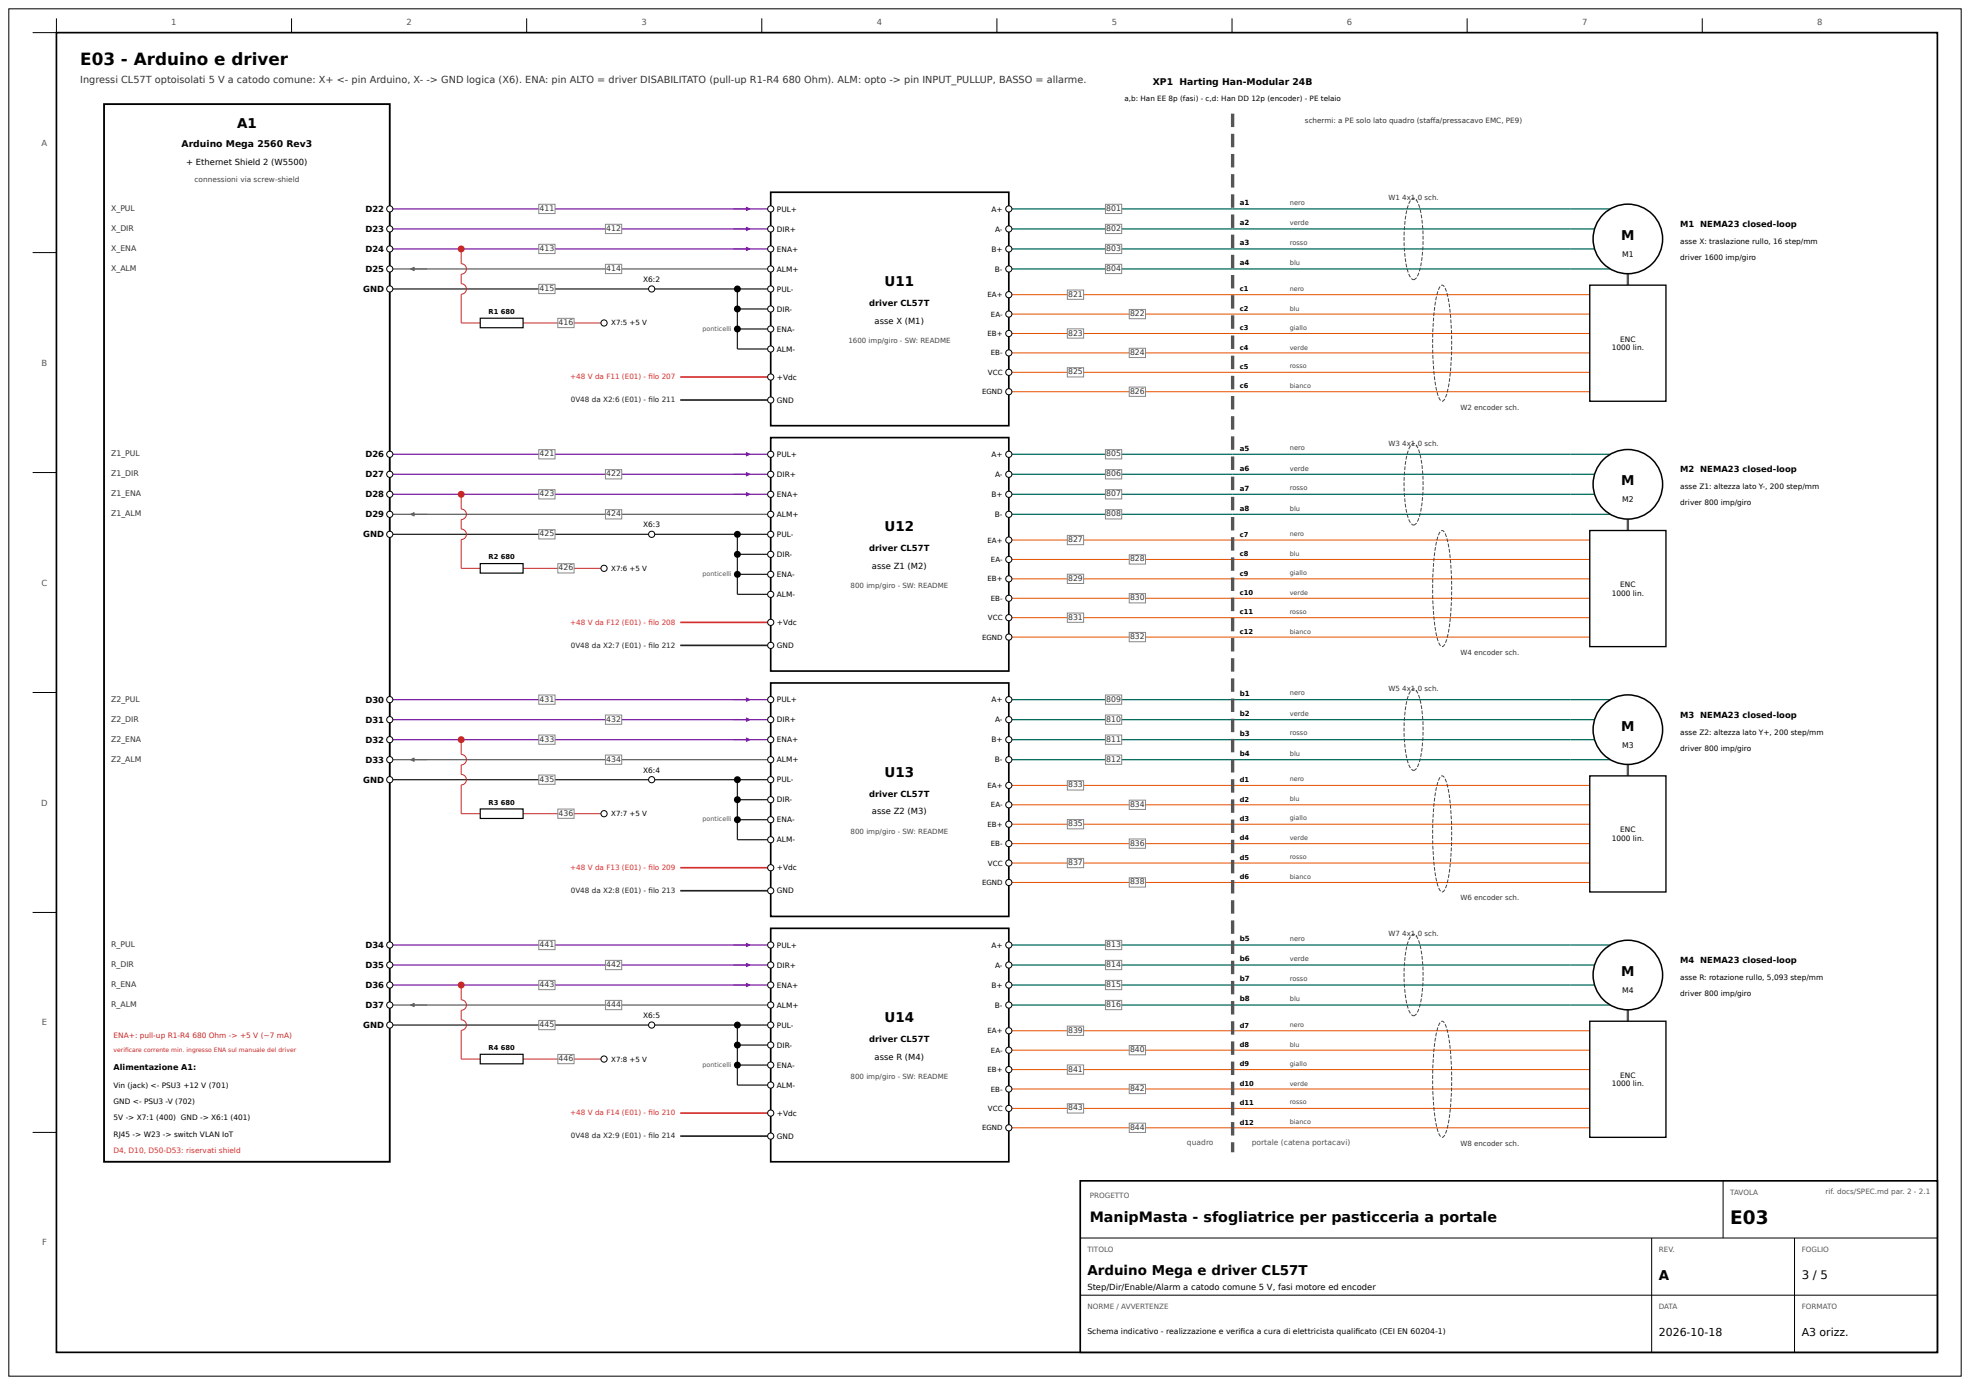
[picture p52: page 3]

a,b: Han EE 8p (fasi) - c,d: Han DD 12p (encoder) - PE telaio

schermi: a PE solo lato quadro (staffa/pressacavo EMC, PE9)

connessioni via screw-shield

asse X: traslazione rullo, 16 step/mm

1600 imp/giro - SW: README

asse Z1: altezza lato Y-, 200 step/mm

800 imp/giro - SW: README

asse Z2: altezza lato Y+, 200 step/mm

asse R: rotazione rullo, 5,093 step/mm

ENA+: pull-up R1-R4 680 Ohm -> +5 V (~7 mA)

verificare corrente min. ingresso ENA sul manuale del driver
Alimentazione A1:

rif. docs/SPEC.md par. 2 - 2.1

PROGETTO
ManipMasta - sfogliatrice per pasticceria a portale

Step/Dir/Enable/Alarm a catodo comune 5 V, fasi motore ed encoder

# E04 - Ingressi / uscite

Ingressi 24 V -> PC817 -> pin INPUT_PULLUP: ingresso a 24 V = pin BASSO (attivo). Uscite D5-D8 -> modulo relè U8 (attivo ALTO) -> colonna luminosa 24 V.

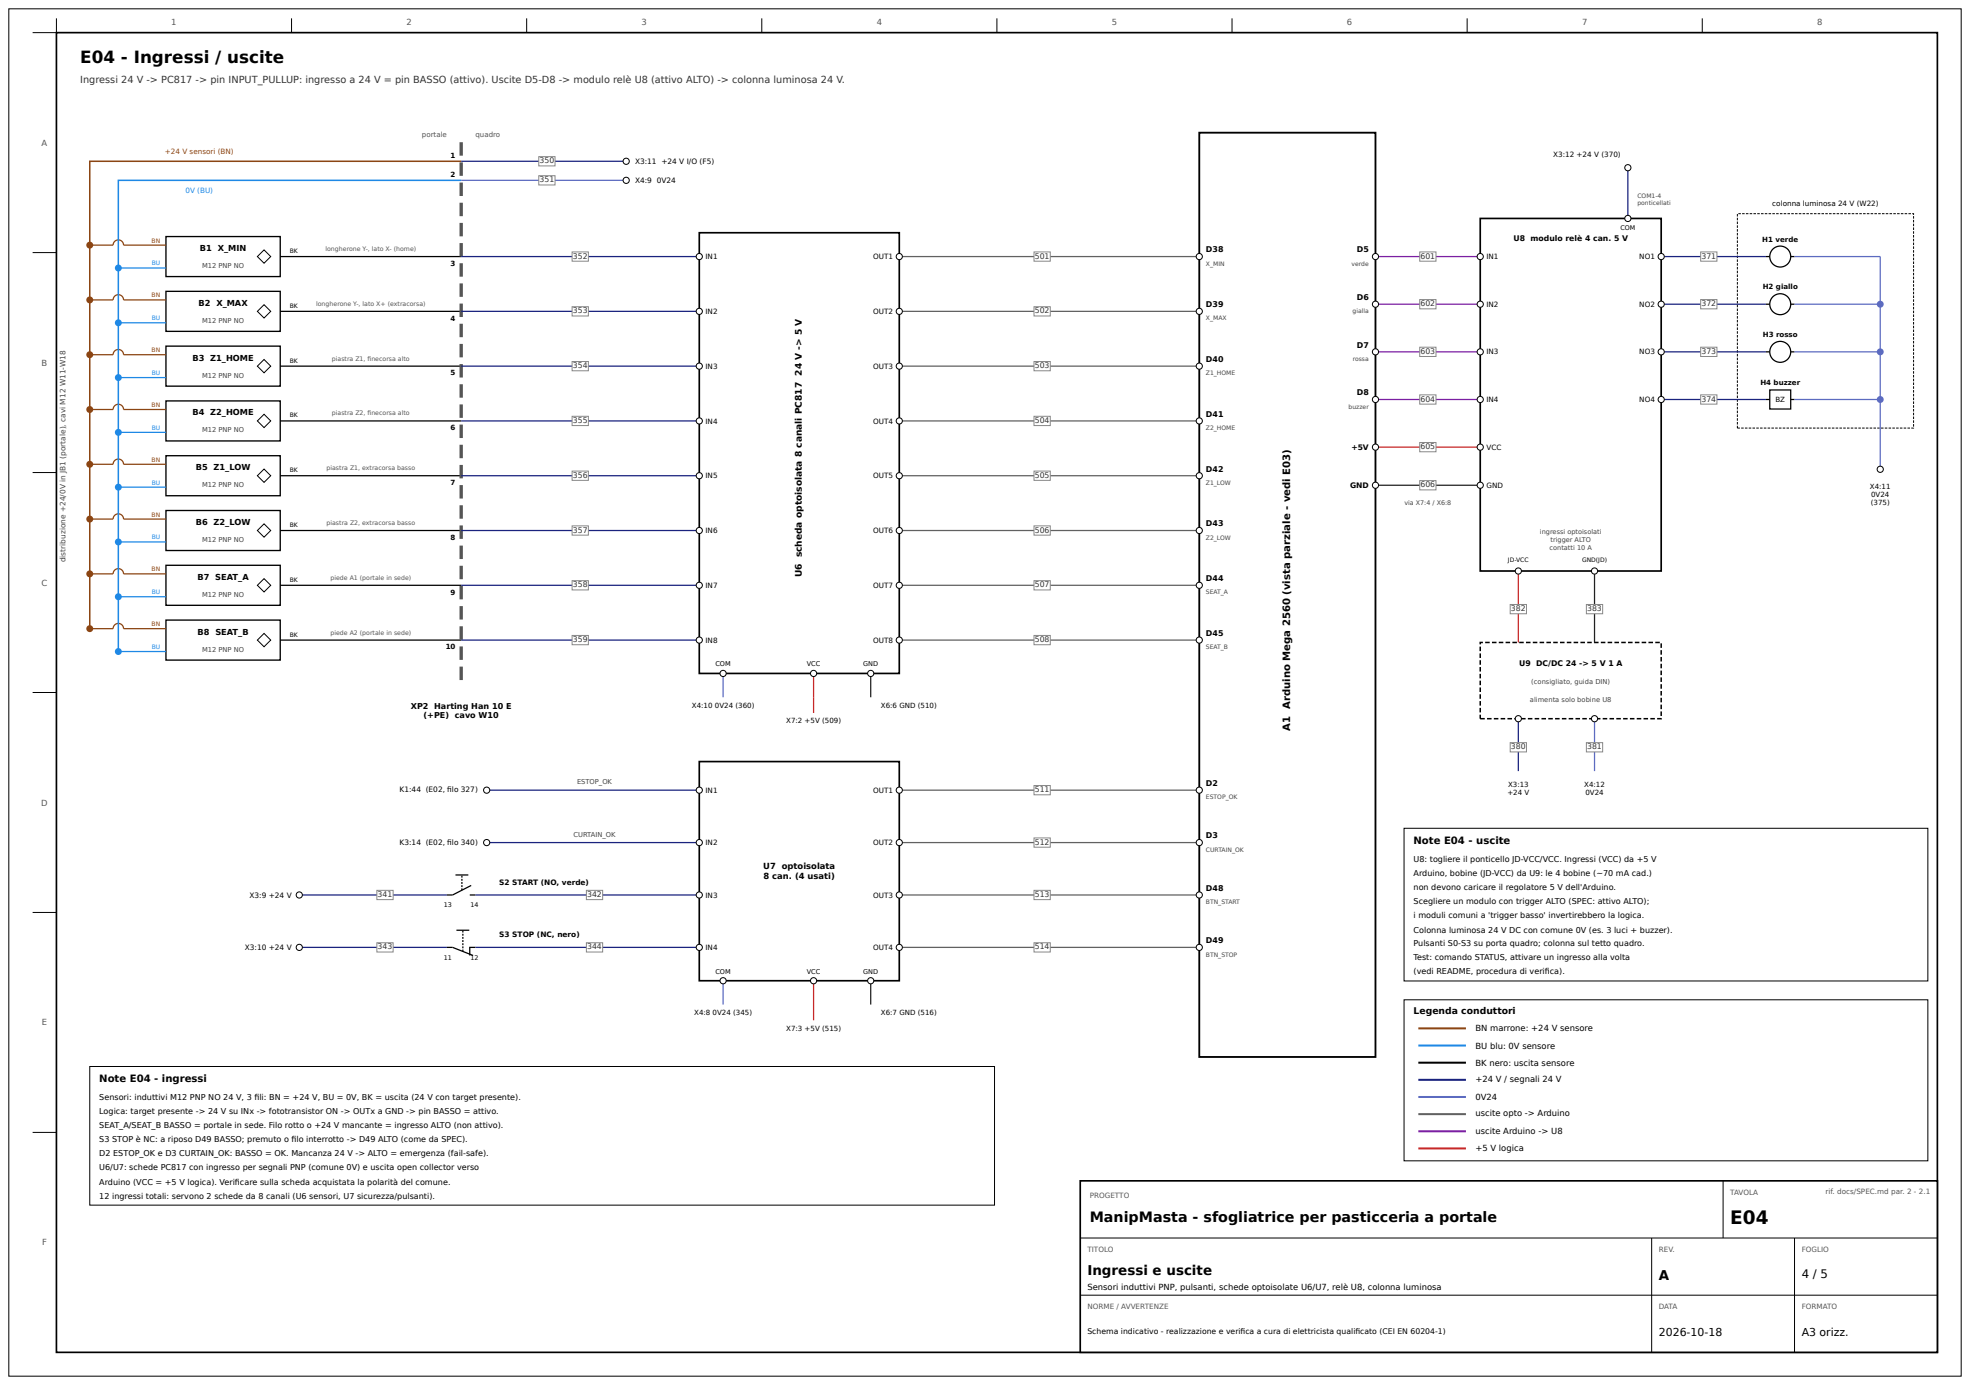
[picture p53: page 4]

distribuzione +24/0V in JB1 (portale), cavi M12 W11-W18

A1 Arduino Mega 2560 (vista parziale - vedi E03)

U8: togliere il ponticello JD-VCC/VCC. Ingressi (VCC) da +5 V
Arduino, bobine (JD-VCC) da U9: le 4 bobine (~70 mA cad.)
non devono caricare il regolatore 5 V dell'Arduino.
Scegliere un modulo con trigger ALTO (SPEC: attivo ALTO);
i moduli comuni a 'trigger basso' invertirebbero la logica.
Colonna luminosa 24 V DC con comune 0V (es. 3 luci + buzzer).
Pulsanti S0-S3 su porta quadro; colonna sul tetto quadro.
Test: comando STATUS, attivare un ingresso alla volta
(vedi README, procedura di verifica).

BN marrone: +24 V sensore
BU blu: 0V sensore
BK nero: uscita sensore
+24 V / segnali 24 V
uscite opto -> Arduino
uscite Arduino -> U8
+5 V logica

Sensori: induttivi M12 PNP NO 24 V, 3 fili: BN = +24 V, BU = 0V, BK = uscita (24 V con target presente).
Logica: target presente -> 24 V su INx -> fototransistor ON -> OUTx a GND -> pin BASSO = attivo.
SEAT_A/SEAT_B BASSO = portale in sede. Filo rotto o +24 V mancante = ingresso ALTO (non attivo).
S3 STOP è NC: a riposo D49 BASSO; premuto o filo interrotto -> D49 ALTO (come da SPEC).
D2 ESTOP_OK e D3 CURTAIN_OK: BASSO = OK. Mancanza 24 V -> ALTO = emergenza (fail-safe).
U6/U7: schede PC817 con ingresso per segnali PNP (comune 0V) e uscita open collector verso
Arduino (VCC = +5 V logica). Verificare sulla scheda acquistata la polarità del comune.
12 ingressi totali: servono 2 schede da 8 canali (U6 sensori, U7 sicurezza/pulsanti).

rif. docs/SPEC.md par. 2 - 2.1

PROGETTO
ManipMasta - sfogliatrice per pasticceria a portale

Sensori induttivi PNP, pulsanti, schede optoisolate U6/U7, relè U8, colonna luminosa

canalina 25x40 (v 362-387)

canalina 25x40 (v 222-247) - separa potenza (sopra) / driver e PSU (sotto)

canalina 25x40 (v 20-45) -> XP1/XP2 sul fondo canalina 18 (u -248...-230) canalina 18 (u +230...+248) fila alta: guida DIN v=307, moduli h 90 (v 262-352), passo 2 mm, da u=-215

A

B

C

D

E

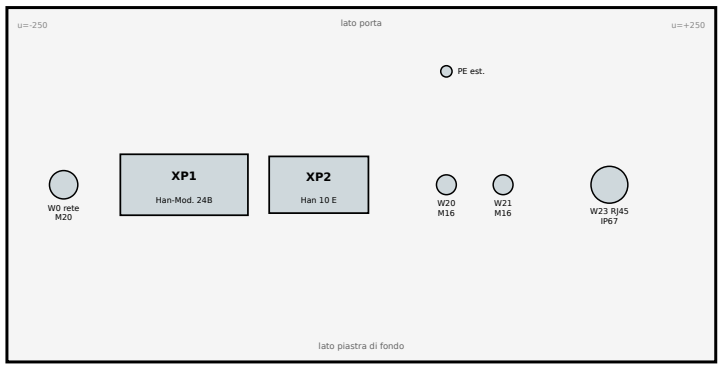
[picture p54: figure]
Han-Mod. 24B; Han 10 E; W0 rete M20; PE est.; lato porta; lato piastra di fondo

F

E05 - Disposizione quadro (indicativa) | Cassetta 500 (L) x 400 (H) x 250 (P). Quote in mm reali, coerenti con il layout 3D; ingombri da verificare sui componenti acquistati.

### VISTA A - piastra di fondo (porta aperta) - scala 1:2 X0

Q1 | Q2
F1

F2

F3
KM1 | KM2

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
PSU1
SDR-480-48
85,5x125

U11
CL57T
X

U12
CL57T
Z1

U13
CL57T
Z2

U14
CL57T
R

PSU2
HDR-60-24

PSU3 HDR-15-12

K2

K3

K2/K3
relè di
interfaccia
barriera
(proposta,
non nel
layout 3D)

BPE
fila bassa (v 80-205): driver con dissipatore verticale, aria dal basso verso l'alto

500

400

u=-250 | u=+250

### VISTA B - parete laterale dx (dall'interno) - 1:3

A1 Arduino Mega
+ Ethernet Shield 2

U6
opto 8 can.

U7
opto 8 can.

U8 relè
4 can.

U9 DC/DC
X6 X7
0V/5V

X3 +24 V
(13 mors.)

X4 0V24
(13 mors.)
lato piastra | lato porta

d = profondità 0-250

VISTA F - parete sx
(dall'esterno) - 1:8

ventola 120
+ filtro IN

griglia
OUT
piastra | porta

VISTA E - portale
(pianta, 1:60)

Q quadro

tavolo 2000x800, catena
portacavi su longherone Y-, JB1 sensori; XP1 arancio,
XP2 via JB1

XP1 Harting Han-Modular 24B (motori/encoder) - PE sul telaio -> W9 portale

a - Han EE 8p fasi

a1 M1 A+ | nero
a2 M1 A- | verde
a3 M1 B+ | rosso
a4 M1 B- | blu
a5 M2 A+ | nero
a6 M2 A- | verde
a7 M2 B+ | rosso
a8 M2 B- | blu

b - Han EE 8p fasi

b1 M3 A+ | nero
b2 M3 A- | verde
b3 M3 B+ | rosso
b4 M3 B- | blu
b5 M4 A+ | nero
b6 M4 A- | verde
b7 M4 B+ | rosso
b8 M4 B- | blu

c - Han DD 12p encoder

c1 M1 EA+ nero

c2 M1 EA- blu

c3 M1 EB+ giallo

c4 M1 EB- verde

c5 M1 VCC rosso

c6 M1 EGND bianco

c7 M2 EA+ nero

c8 M2 EA- blu

c9 M2 EB+ giallo

c10 M2 EB- verde

c11 M2 VCC rosso

c12 M2 EGND bianco

d - Han DD 12p encoder

d1 M3 EA+ nero

d2 M3 EA- blu

d3 M3 EB+ giallo

d4 M3 EB- verde

d5 M3 VCC rosso

d6 M3 EGND bianco

d7 M4 EA+ nero

d8 M4 EA- blu

d9 M4 EB+ giallo

d10 M4 EB- verde

d11 M4 VCC rosso

d12 M4 EGND bianco

### Note E05

Ventilazione: ventola 120 mm con filtro IP54 in ingresso in alto a sx, griglia filtrata di uscita in basso; dissipazione 40-70 W. Potenza 230 V / 48 V nella fila alta e nei driver, logica 5 V
e I/O 24 V sulla parete dx: incroci a 90 gradi.
Canaline 25 (vista) x 40 (profondità), verticali larghe 18.
VISTA C - fondo (dal basso) - 1:5 | K2/K3 assenti nel layout 3D: proposti su DIN fila bassa.

### VISTA D - porta (esterno) - 1:8

S0 | S1
S2 | S3

H1-H4 sul tetto,
angolo posteriore sx

S0 fungo emergenza Ø40 (2NC) S1 RESET blu - S2 START verde S3 STOP (NC)

XP2 Han 10 E

1 +24 V (BN)

2 0V (BU)

3 X_MIN

4 X_MAX

5 Z1_HOME

6 Z2_HOME

7 Z1_LOW

8 Z2_LOW

9 SEAT_A

10 SEAT_B

PE telaio JB1

PROGETTO

# ManipMasta - sfogliatrice per pasticceria a portale

TAVOLA
E05

TITOLO

# Disposizione quadro e connettori

Cassetta inox IP65 500x400x250, ventilazione filtrata IP54, Harting XP1/XP2, collegamento portale

REV.
A

FOGLIO
5 / 5

rif. docs/SPEC.md par. 2 - 2.1
