giacomobuzi/manipmasta/cad/build/steps/step_01_a.png

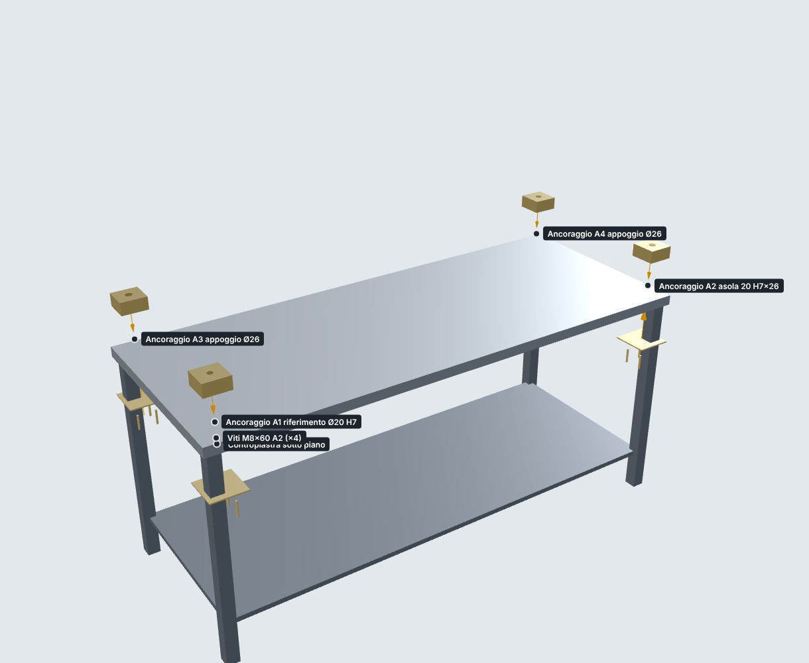
cad/build/steps/step_01_a.png
