giacomobuzi/manipmasta/cad/build/steps/step_01_b.png

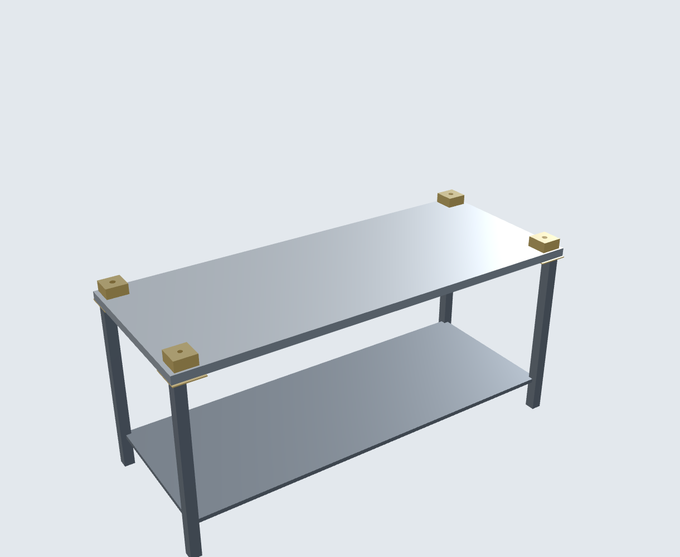
cad/build/steps/step_01_b.png
