giacomobuzi/manipmasta/cad/build/steps/step_02_a.png

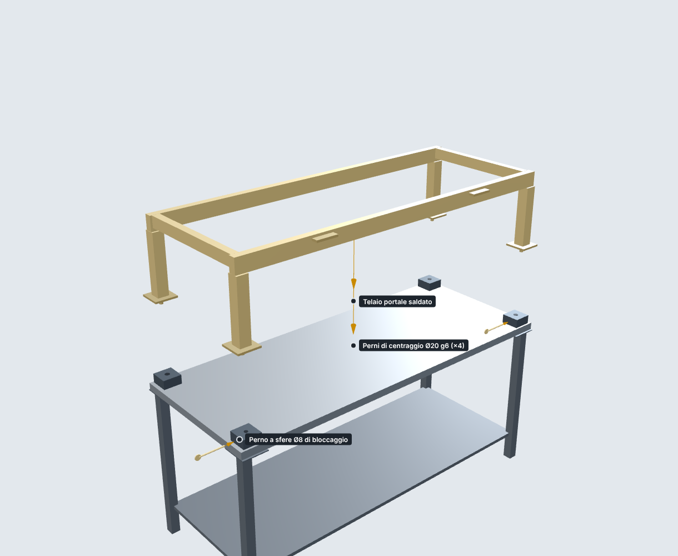
cad/build/steps/step_02_a.png
