giacomobuzi/manipmasta/cad/build/steps/step_04_a.png

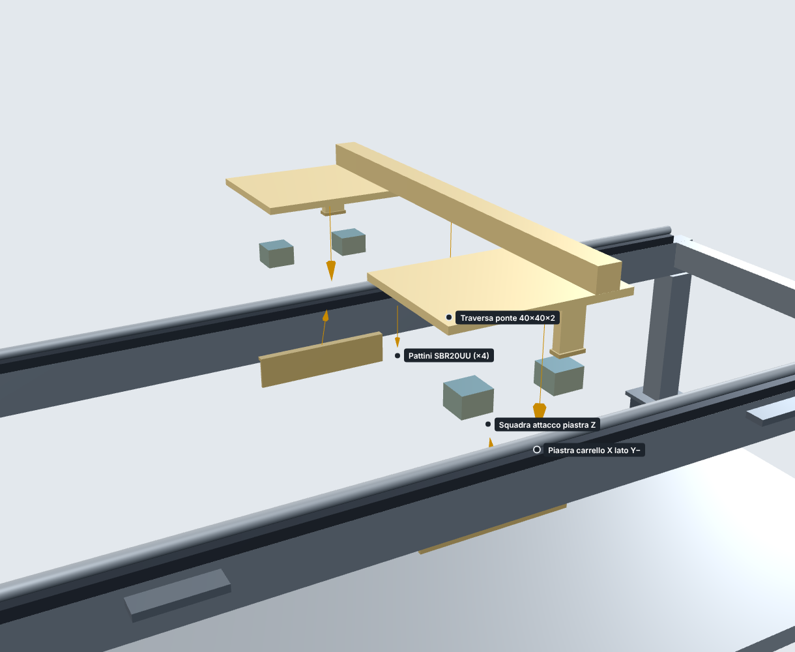
cad/build/steps/step_04_a.png
