giacomobuzi/manipmasta/cad/build/steps/step_04_b.png

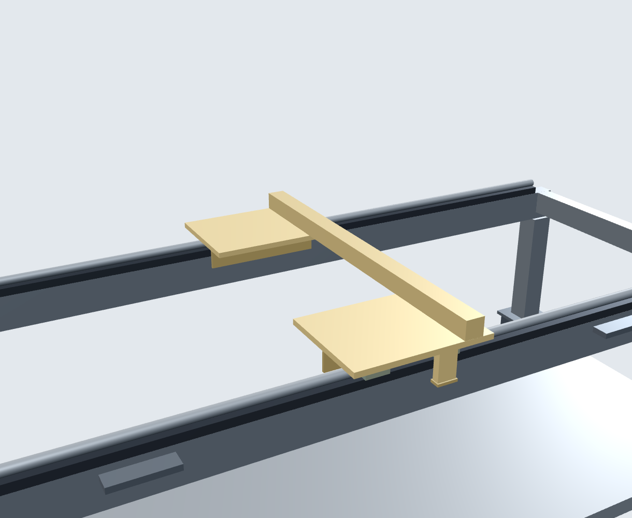
cad/build/steps/step_04_b.png
