giacomobuzi/manipmasta/cad/build/steps/step_06_a.png

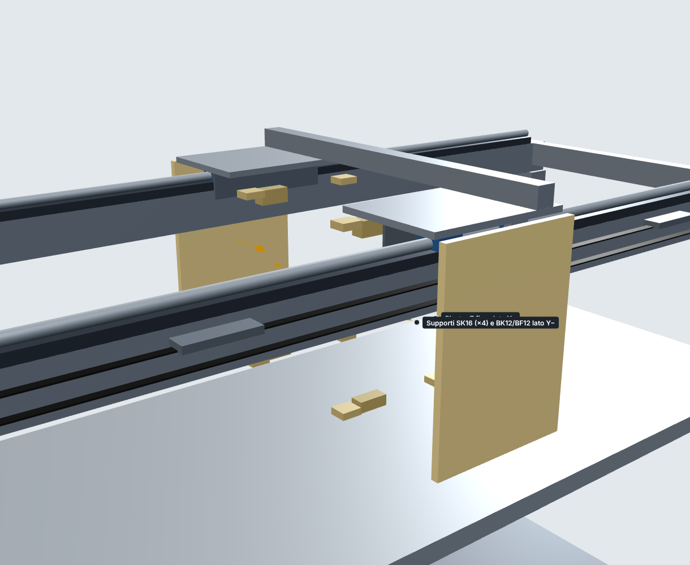
cad/build/steps/step_06_a.png
