giacomobuzi/manipmasta/cad/build/steps/step_07_a.png

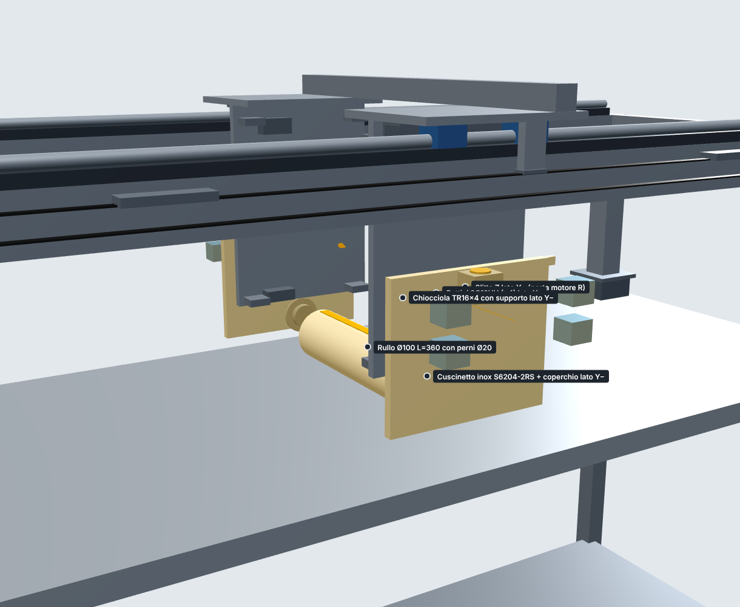
cad/build/steps/step_07_a.png
