giacomobuzi/manipmasta/cad/build/steps/step_08_a.png

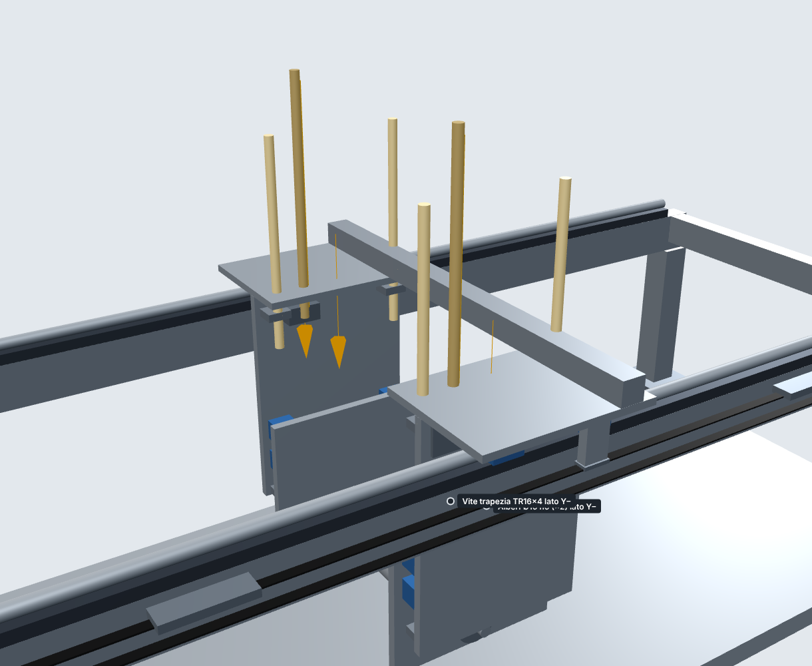
cad/build/steps/step_08_a.png
