giacomobuzi/manipmasta/cad/build/steps/step_08_b.png

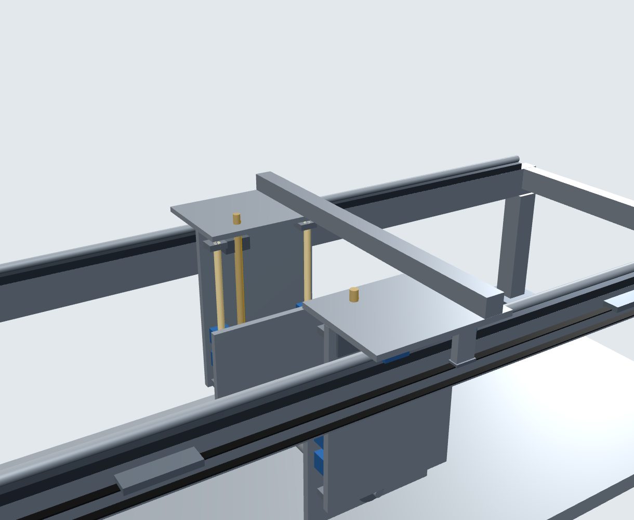
cad/build/steps/step_08_b.png
