giacomobuzi/manipmasta/cad/build/steps/step_09_a.png

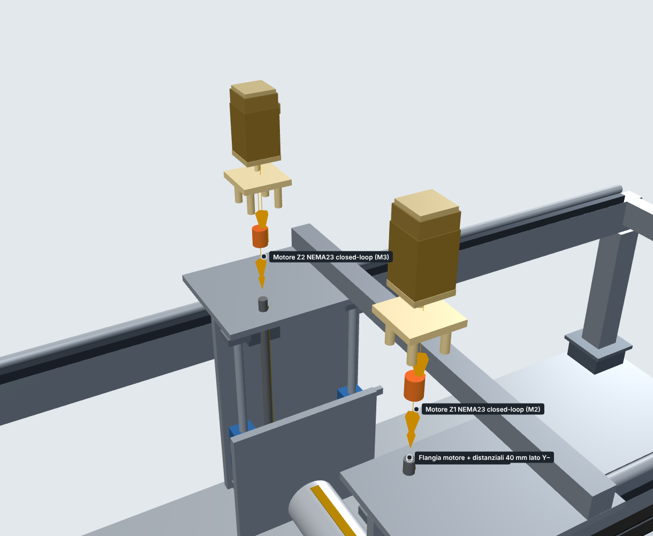
cad/build/steps/step_09_a.png
