giacomobuzi/manipmasta/cad/build/steps/step_10_a.png

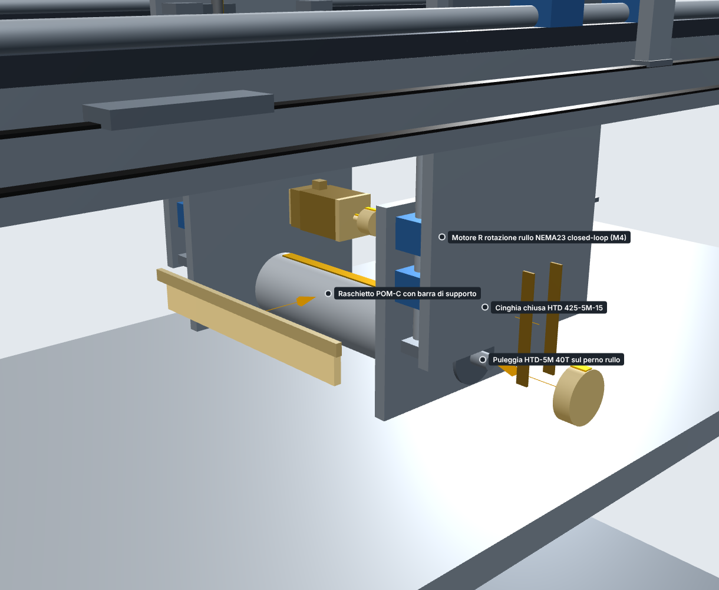
cad/build/steps/step_10_a.png
