giacomobuzi/manipmasta/cad/build/steps/step_13_a.png

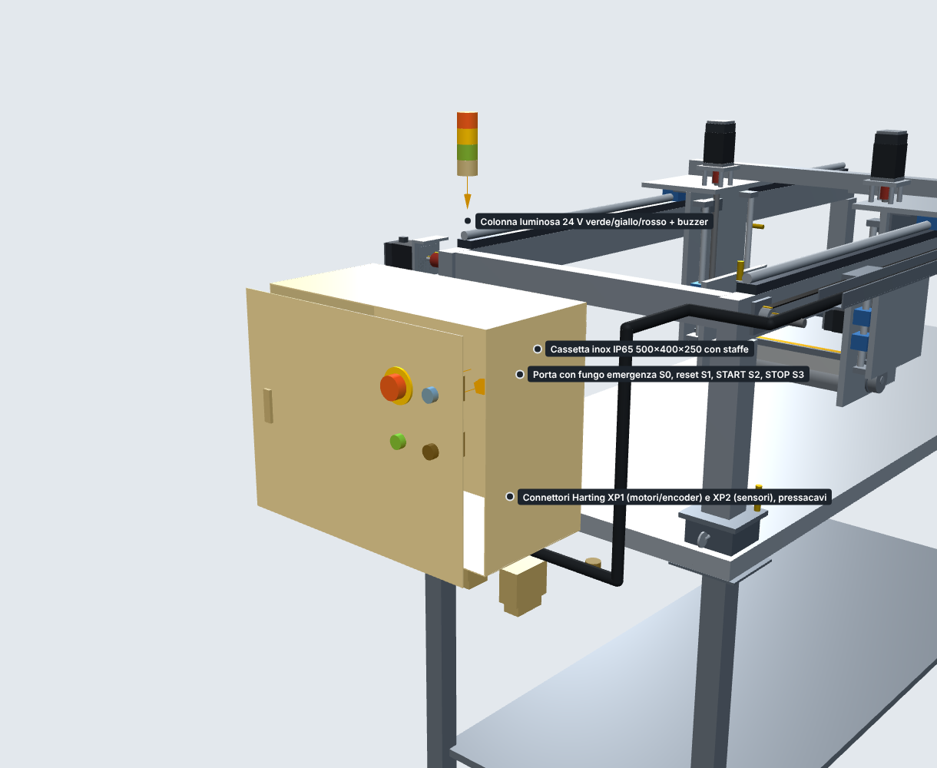
cad/build/steps/step_13_a.png
