giacomobuzi/manipmasta/cad/build/steps/step_14_a.png

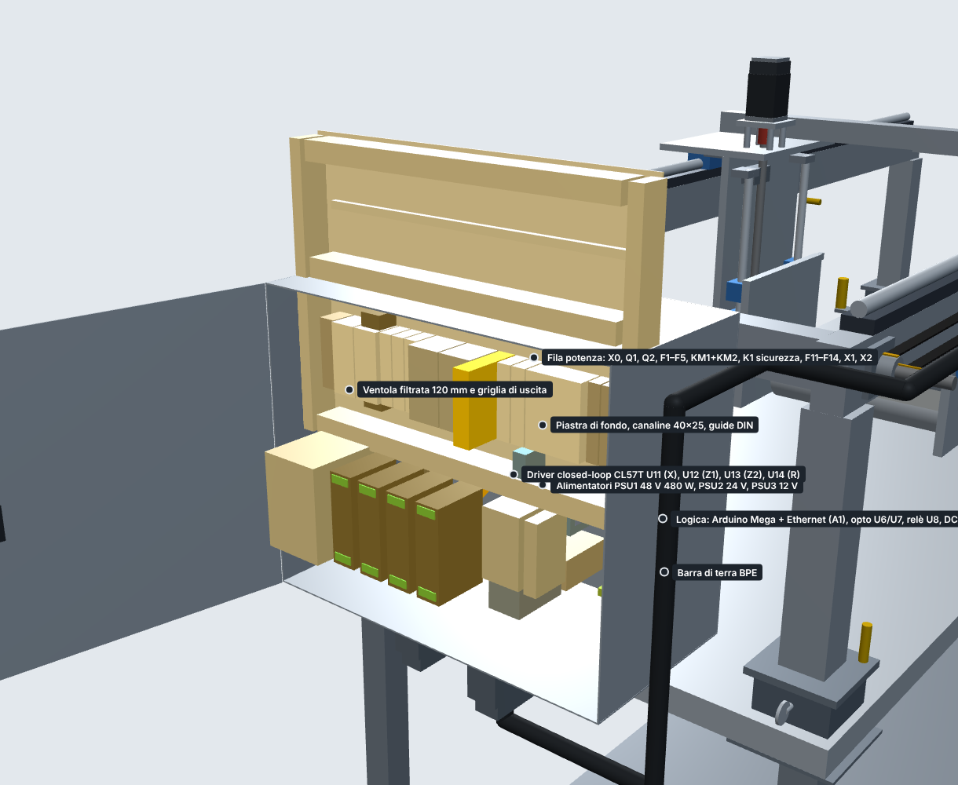
cad/build/steps/step_14_a.png
