giacomobuzi/manipmasta/wiring/out/E01.png

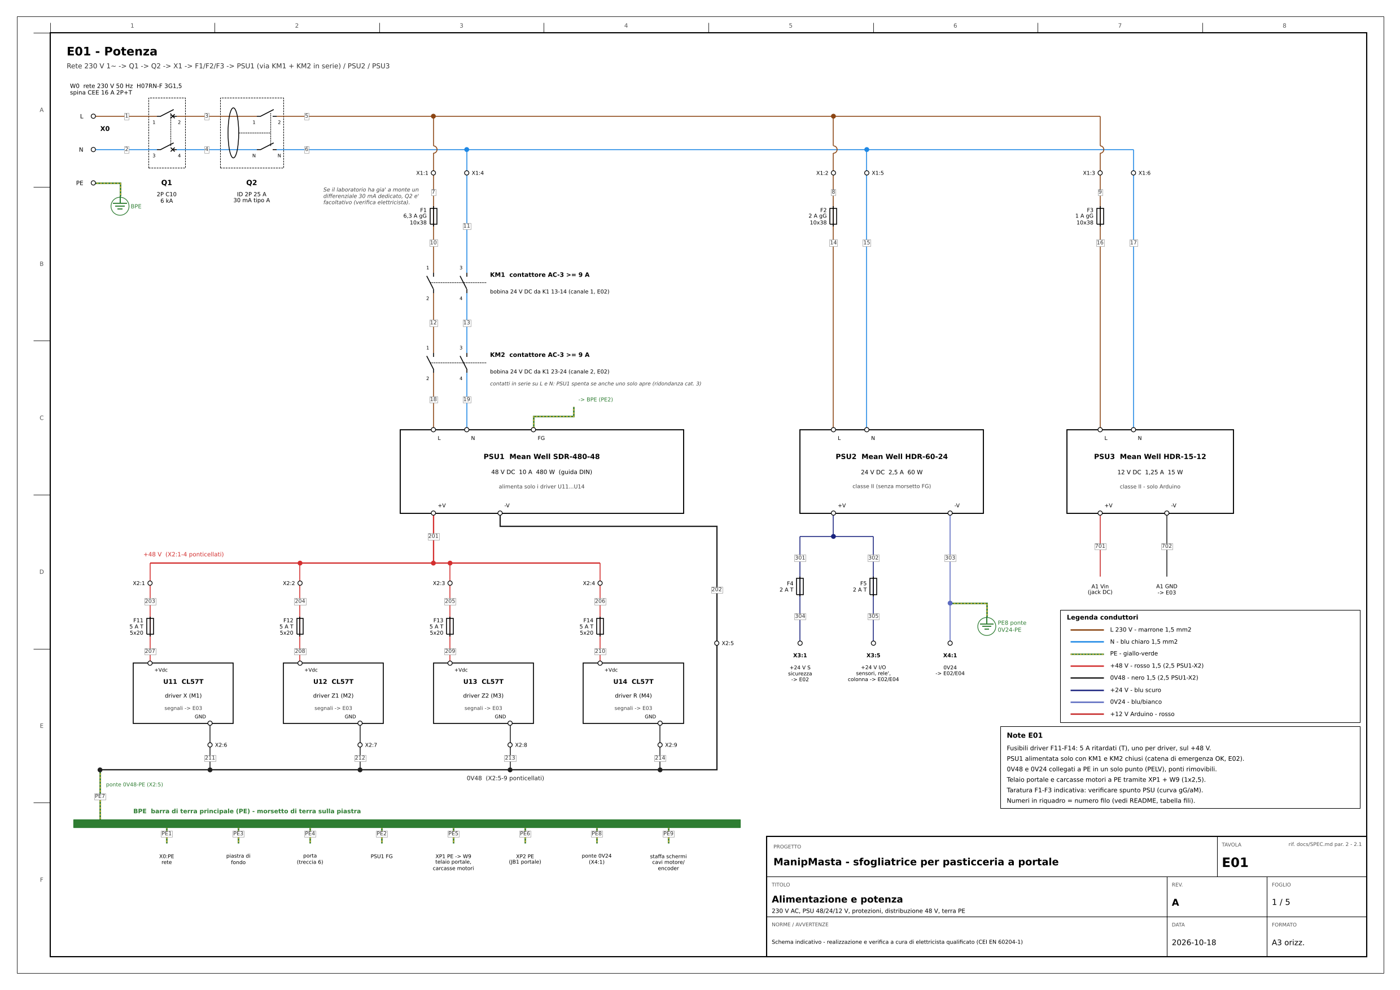
wiring/out/E01.png
