giacomobuzi/manipmasta/wiring/out/E02.png

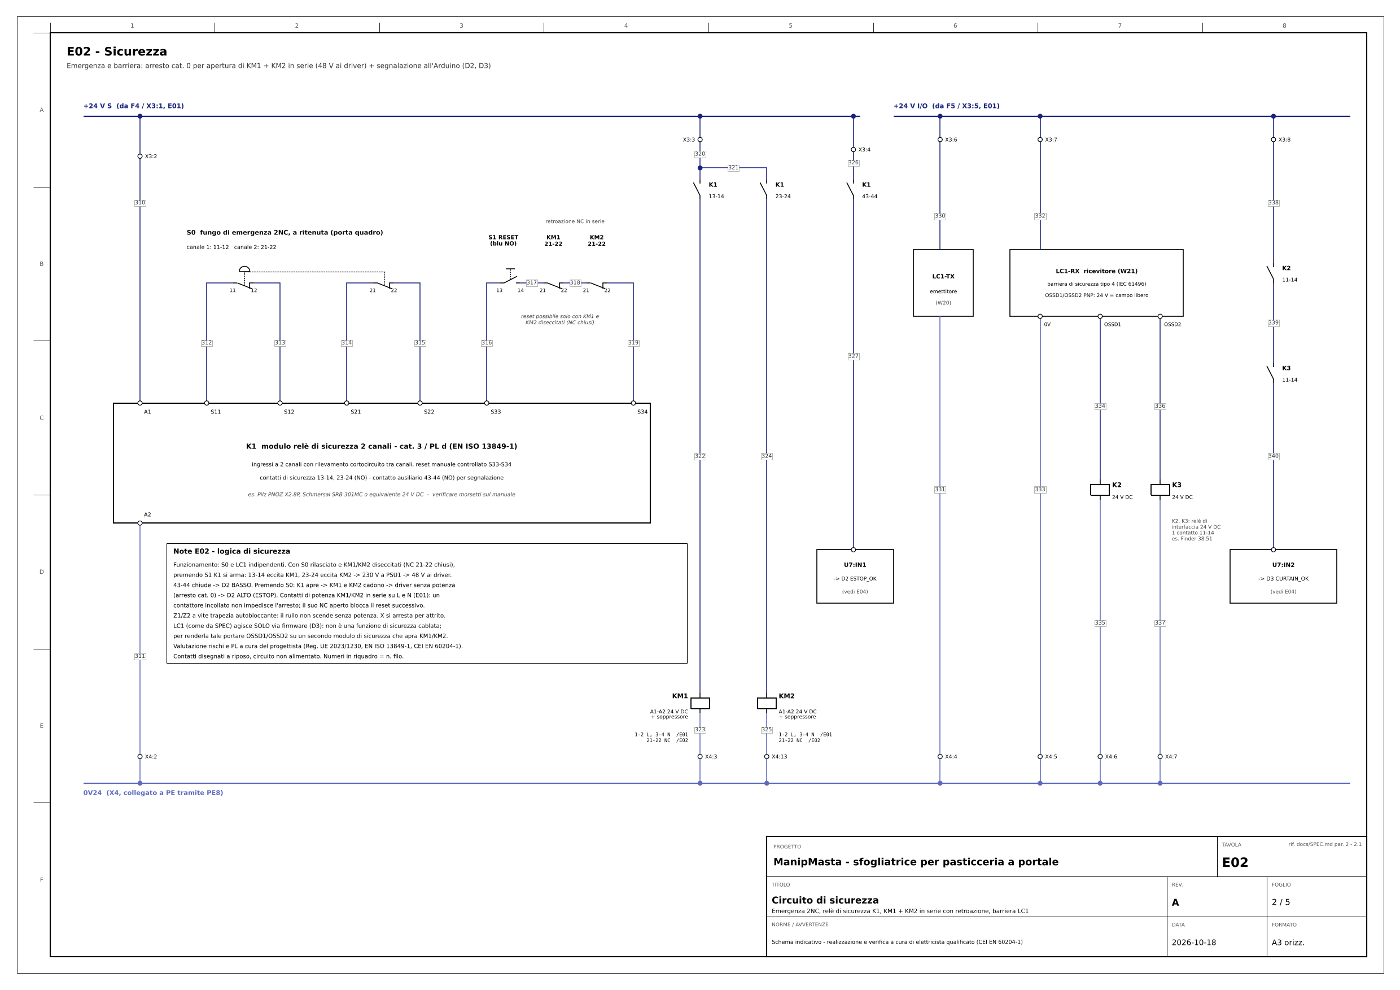
wiring/out/E02.png
