giacomobuzi/manipmasta/wiring/out/E03.png

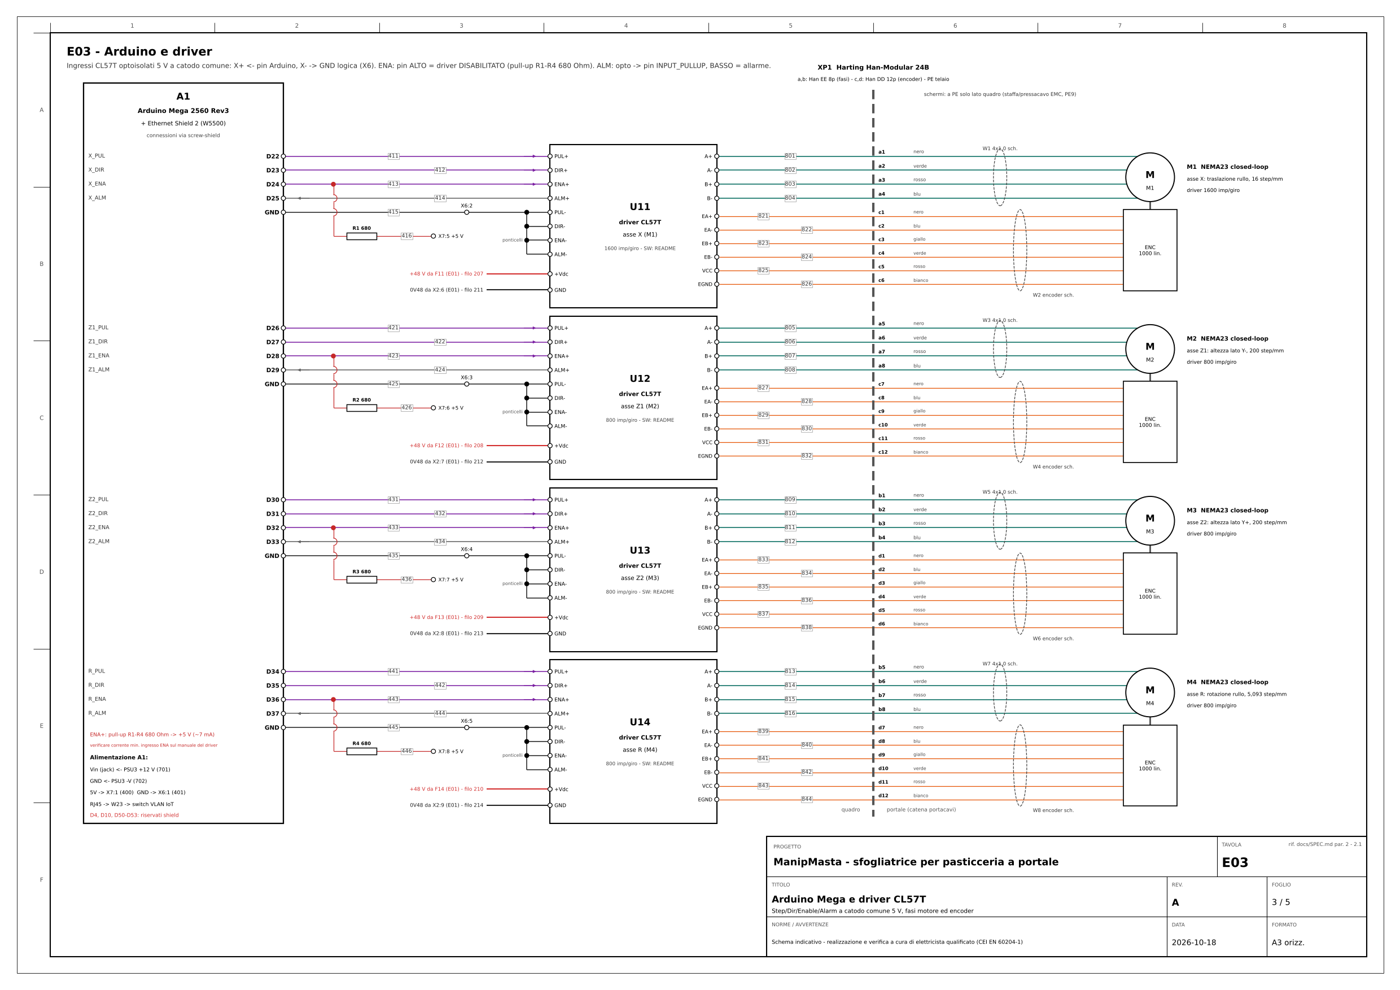
wiring/out/E03.png
