giacomobuzi/manipmasta/wiring/out/E04.png

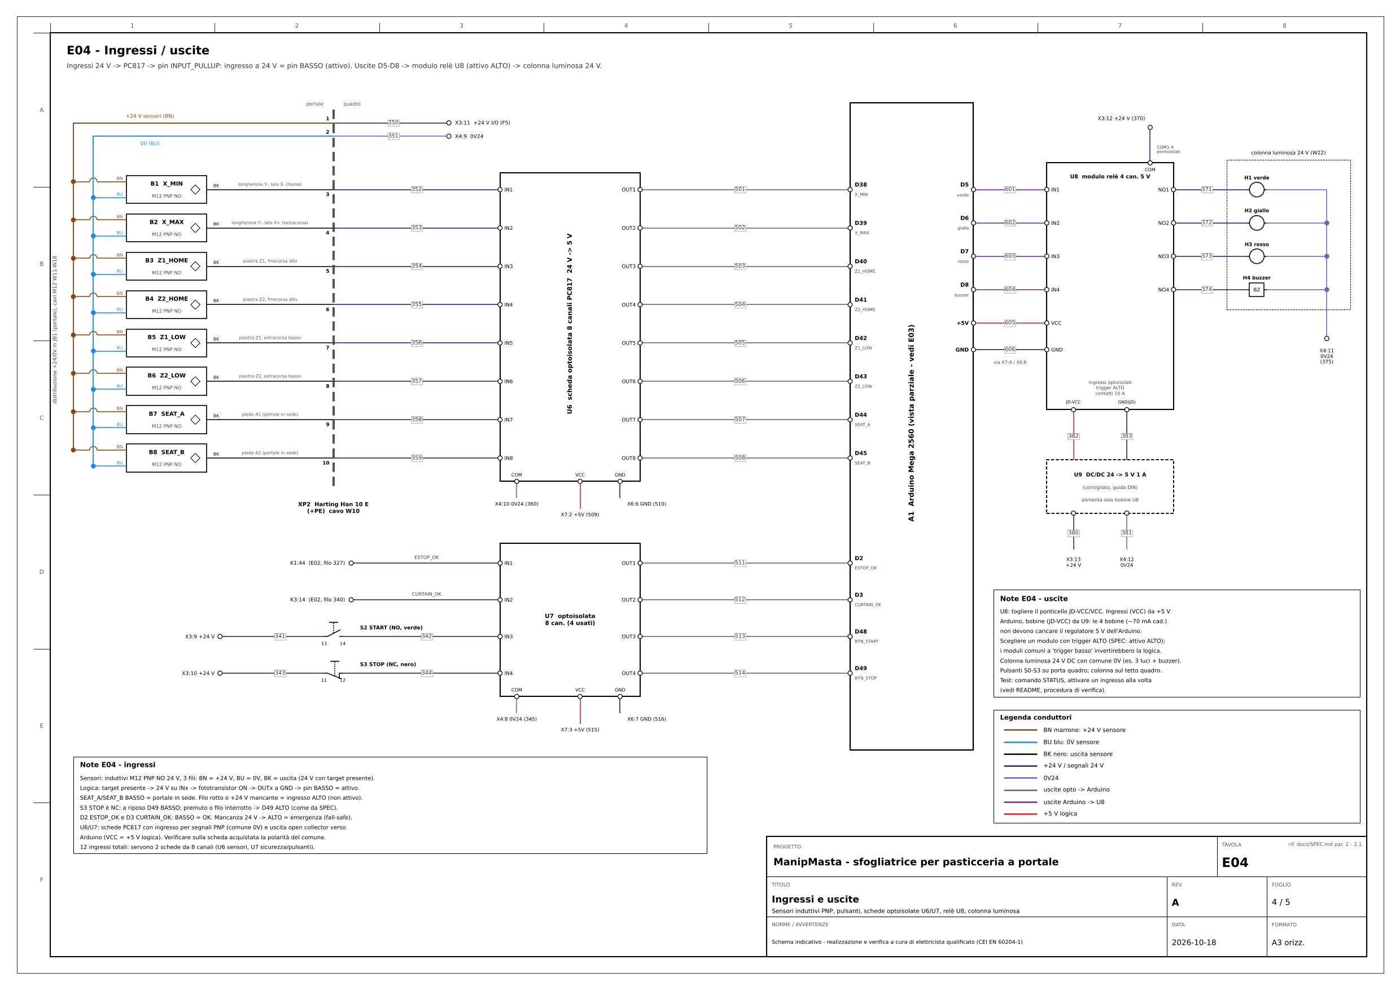
wiring/out/E04.png
