giacomobuzi/manipmasta/wiring/out/E05.png

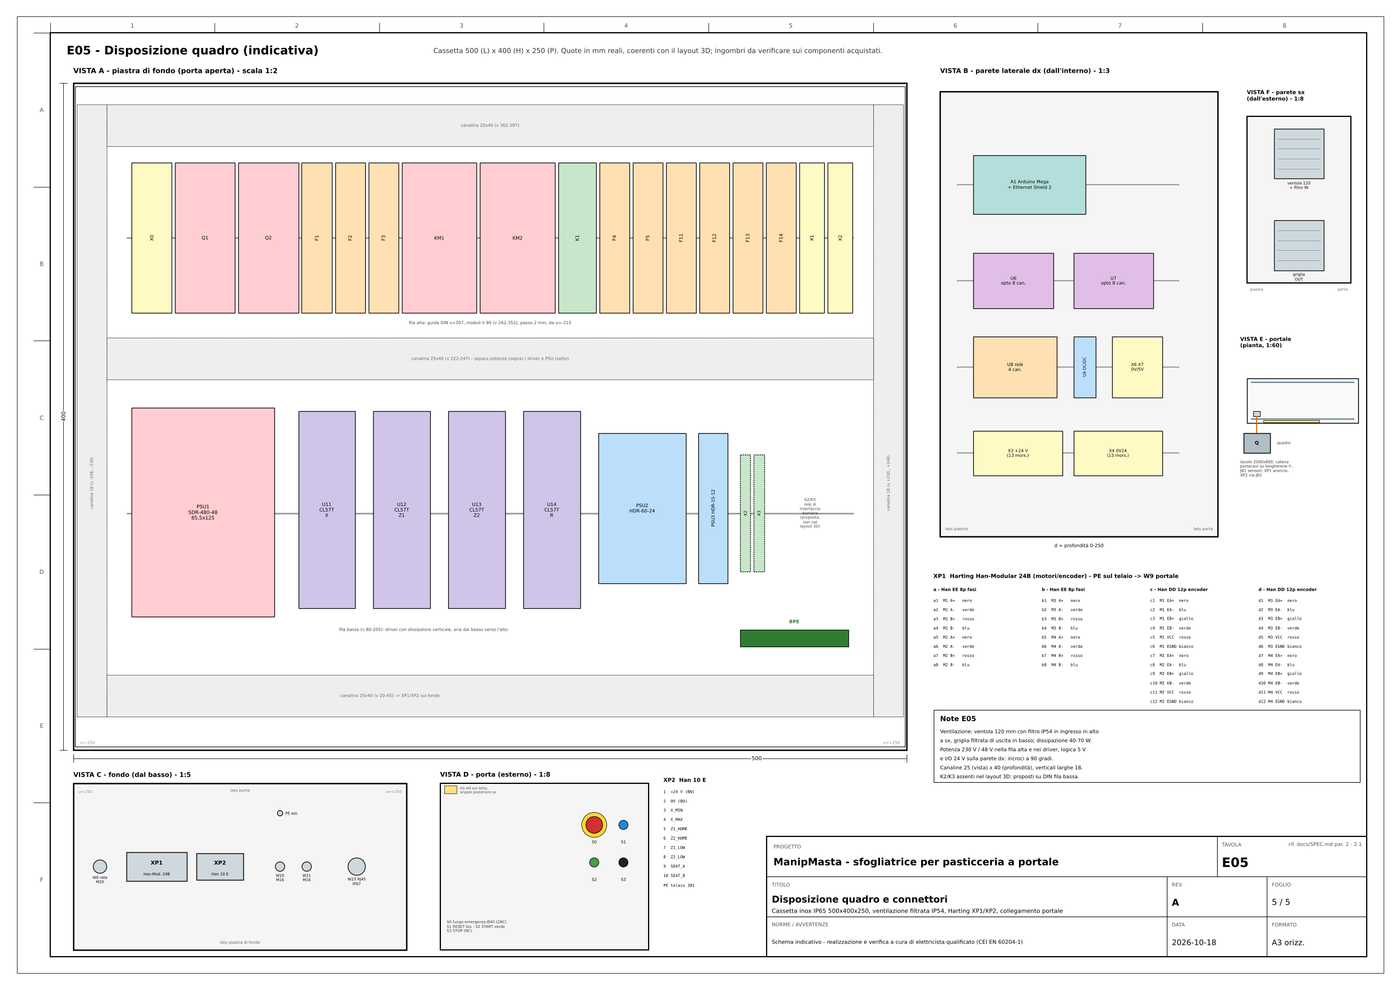
wiring/out/E05.png
