giacomobuzi/manipmasta/cad/drawings/ManipMasta_tavole.pdf

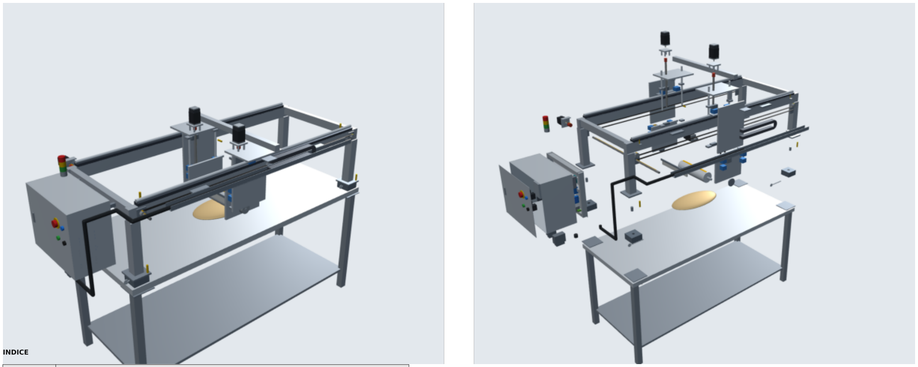
[picture p73: figure]
INDICE

MANIPMASTA | Copertina e indice | Tav. 00
Materiale — | Quantità — | Fornitura —
Scala — | Data / Rev. 2026-10-18 / A | Toll. gen.
Quote in mm. Spigoli vivi smussati 0,5×45°. Parti a contatto alimentare: AISI 304, finitura Ra ≤ 0,8 µm, saldature TIG passivate. [V] = verificare su datasheet del componente acquistato. | ISO 2768-mK

# MANIPMASTA

# Sfogliatrice a portale per tavolo da pasticceria — tavole costruttive

Tavolo di riferimento 2000×800 mm (ipotesi). Rigenerare con le misure reali: cad/params.json

Assieme | Esploso
Tav. | Contenuto
00 | Copertina e indice
01 | Assieme generale — viste
02 | TEL-01 Telaio portale
03 | ANC Ancoraggi fissi
04 | PER-01 Perno di centraggio
05 | RUL-01 Rullo
06-12 | Piastre laser: CAR-01, ZPL-01, ZSL-02, ZSL-01, COP-01, PIE-01, STM-01
13 | Particolari torniti e plastici

## Elettrico: wiring/out/schemi_elettrici.pdf · Distinta: bom/ManipMasta_distinta.xlsx

Modello 3D (esploso, come funziona, montaggio): cad/build/manipmasta_3d.html · Istruzioni: cad/drawings/ManipMasta_montaggio.pdf

## VISTA DALL'ALTO

## ELENCO PARTI

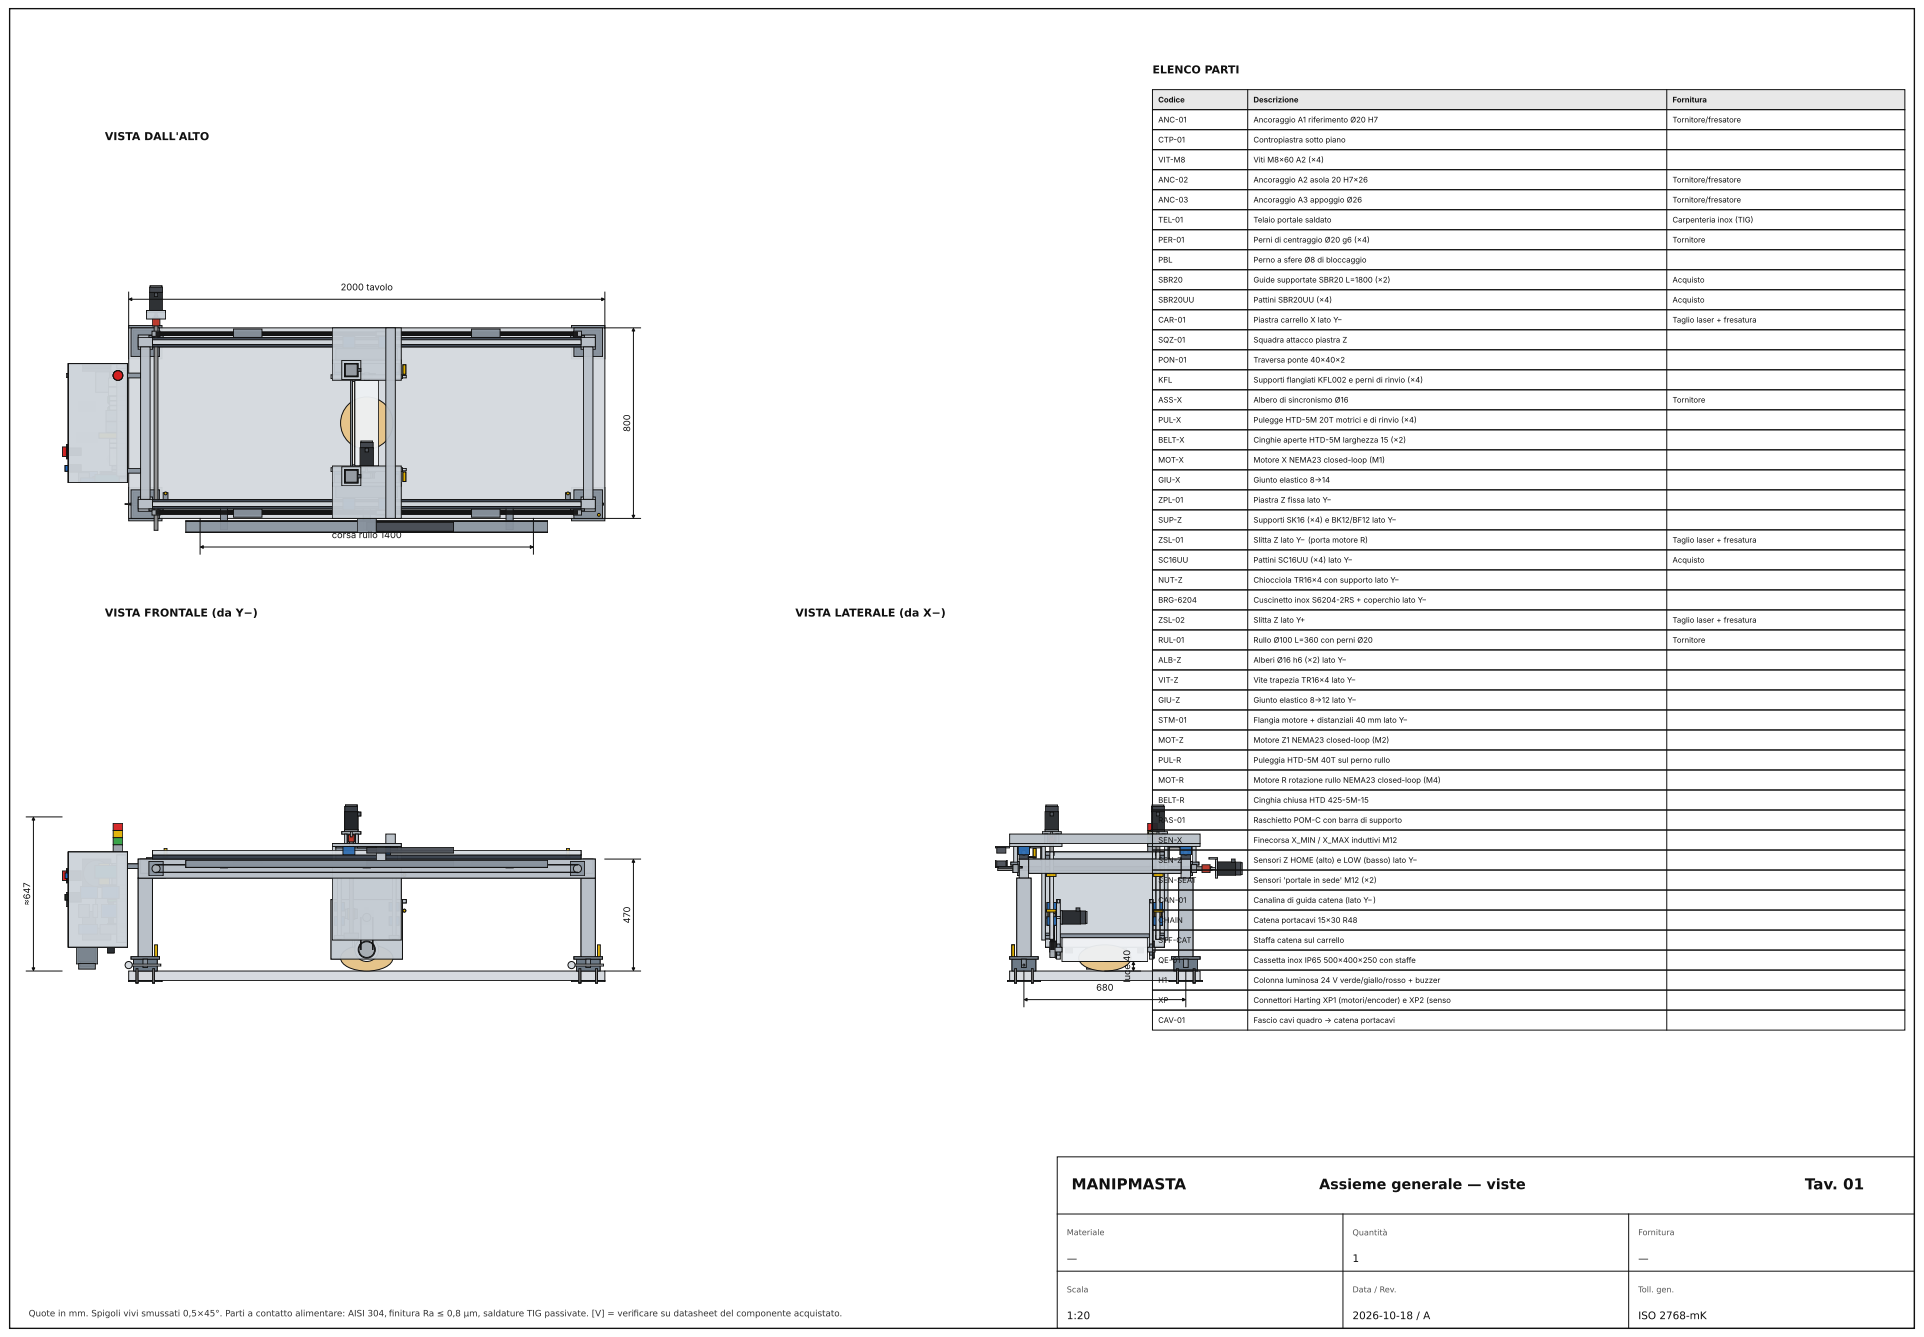
[picture p74: page 2]
MANIPMASTA; Assieme generale — viste; Tav. 01; Materiale —; Quantità; Fornitura —; 2000 tavolo; corsa rullo 1400; luce 40; Codice; Descrizione; Fornitura; ANC-01; Ancoraggio A1 riferimento Ø20 H7; Tornitore/fresatore; CTP-01; Contropiastra sotto piano; VIT-M8; Viti M8×60 A2 (×4); ANC-02; Ancoraggio A2 asola 20 H7×26; ANC-03; Ancoraggio A3 appoggio Ø26; TEL-01; Telaio portale saldato; Carpenteria inox (TIG); PER-01; Perni di centraggio Ø20 g6 (×4); Tornitore; PBL; Perno a sfere Ø8 di bloccaggio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

VISTA FRONTALE (da Y−)

VISTA LATERALE (da X−)

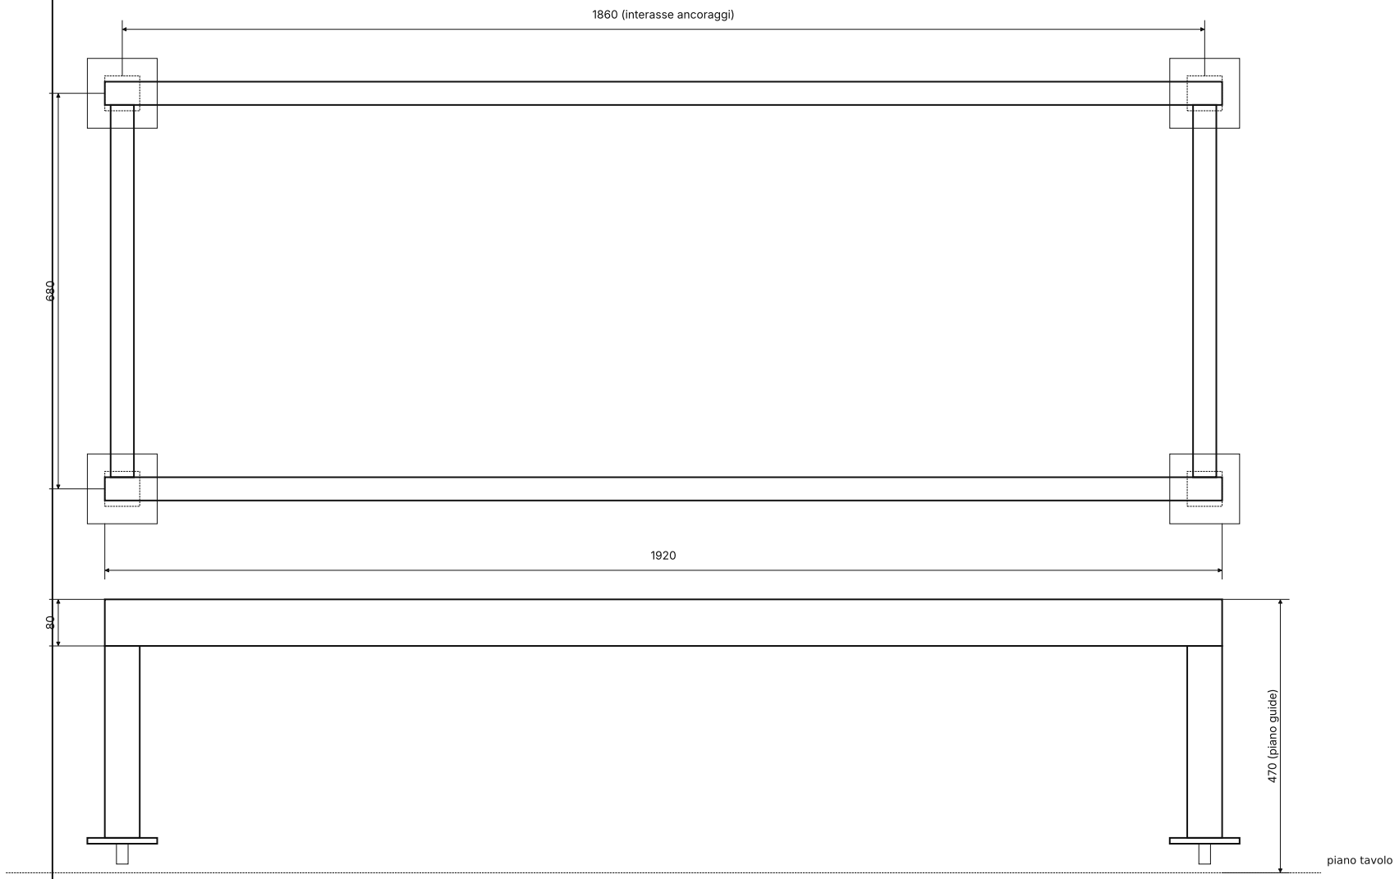
[picture p75: figure]
1860 (interasse ancoraggi); 470 (piano guide); piano tavolo

MANIPMASTA | TEL-01 Telaio portale saldato | Tav. 02

Materiale

## AISI 304 tubolari

Quantità
Fornitura

## Carpenteria inox (TIG)

## VISTA DALL'ALTO (scala 1:10)

## VISTA FRONTALE lato Y− (scala 1:10)

## DISTINTA TELAIO

Elemento | Profilo | Lungh. | Q.tà
Montanti | tubo quadro 60×60×3 | 330 | 4
Longheroni X | tubo rett. 80×40×3 | 1920 | 2
Traversi Y | tubo rett. 60×40×3 | 640 | 2
Piastre piede | PIE-01 sp. 10 | 120×120 | 4
Maniglie | tondo Ø16 piegato | 120 utile | 4
Fazzoletti | lamiera sp. 5 tri. 60×60 | - | 8
Supporti albero X | piatto 60×60×8 forato KFL001 [V] | - | 4
- Saldatura TIG continua, passivazione e decapaggio finali; nessuna cavità aperta (tappi saldati alle estremità).
- Planarità faccia superiore longheroni (appoggio guide SBR20): 0,1 su 1800 — fresare o spessorare dopo saldatura.
- Parallelismo tra i due longheroni: 0,1. Diagonali del rettangolo dei perni: differenza ≤ 0,5.
- Saldare i piedi con perni infilati negli ancoraggi già posati (dima) per garantire la posizione.
- Fori Ø17 passanti nei longheroni (asse a quota 430, x = −870) per l'albero di sincronismo Ø16.
- Peso stimato telaio ~32 kg; portale completo ~50 kg: sollevare in due con le 4 maniglie.

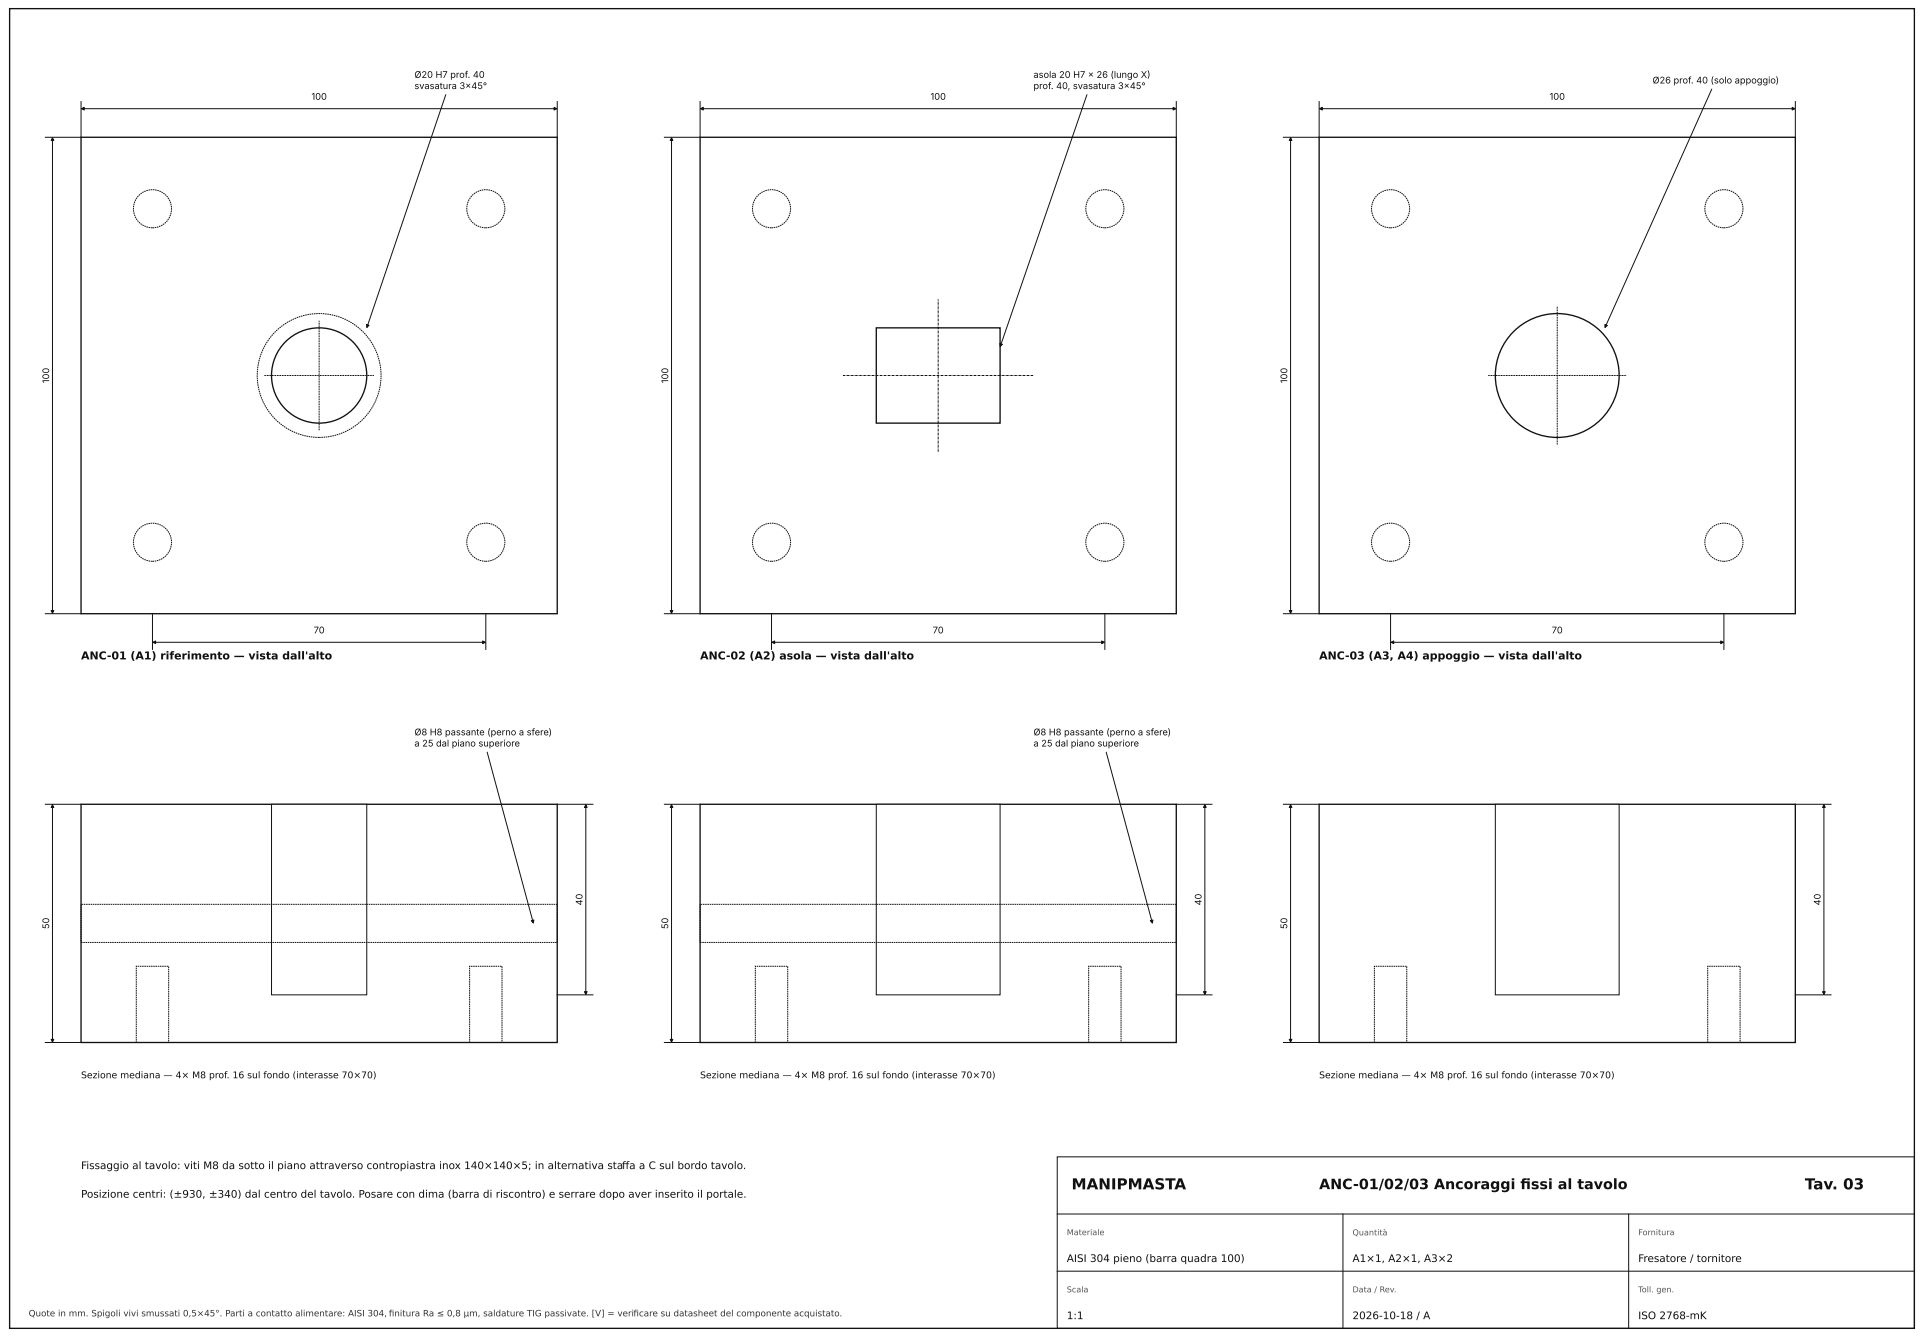
[picture p76: page 4]
MANIPMASTA; ANC-01/02/03 Ancoraggi fissi al tavolo; Tav. 03; Materiale; Quantità; Fornitura; Fresatore / tornitore; Ø20 H7 prof. 40 svasatura 3×45°; asola 20 H7 × 26 (lungo X); prof. 40, svasatura 3×45°

Ø26 prof. 40 (solo appoggio)

ANC-01 (A1) riferimento — vista dall'alto

ANC-02 (A2) asola — vista dall'alto

ANC-03 (A3, A4) appoggio — vista dall'alto

Ø8 H8 passante (perno a sfere)
a 25 dal piano superiore

Sezione mediana — 4× M8 prof. 16 sul fondo (interasse 70×70)

Fissaggio al tavolo: viti M8 da sotto il piano attraverso contropiastra inox 140×140×5; in alternativa staffa a C sul bordo tavolo.

Posizione centri: (±930, ±340) dal centro del tavolo. Posare con dima (barra di riscontro) e serrare dopo aver inserito il portale.

AISI 304 pieno (barra quadra 100)

MANIPMASTA | PER-01 Perno di centraggio | Tav. 04

Materiale

## AISI 420 temprato 50 HRC (o 304)

Quantità
Fornitura

## Tornitore

## PERNO — vista laterale (scala 2:1)

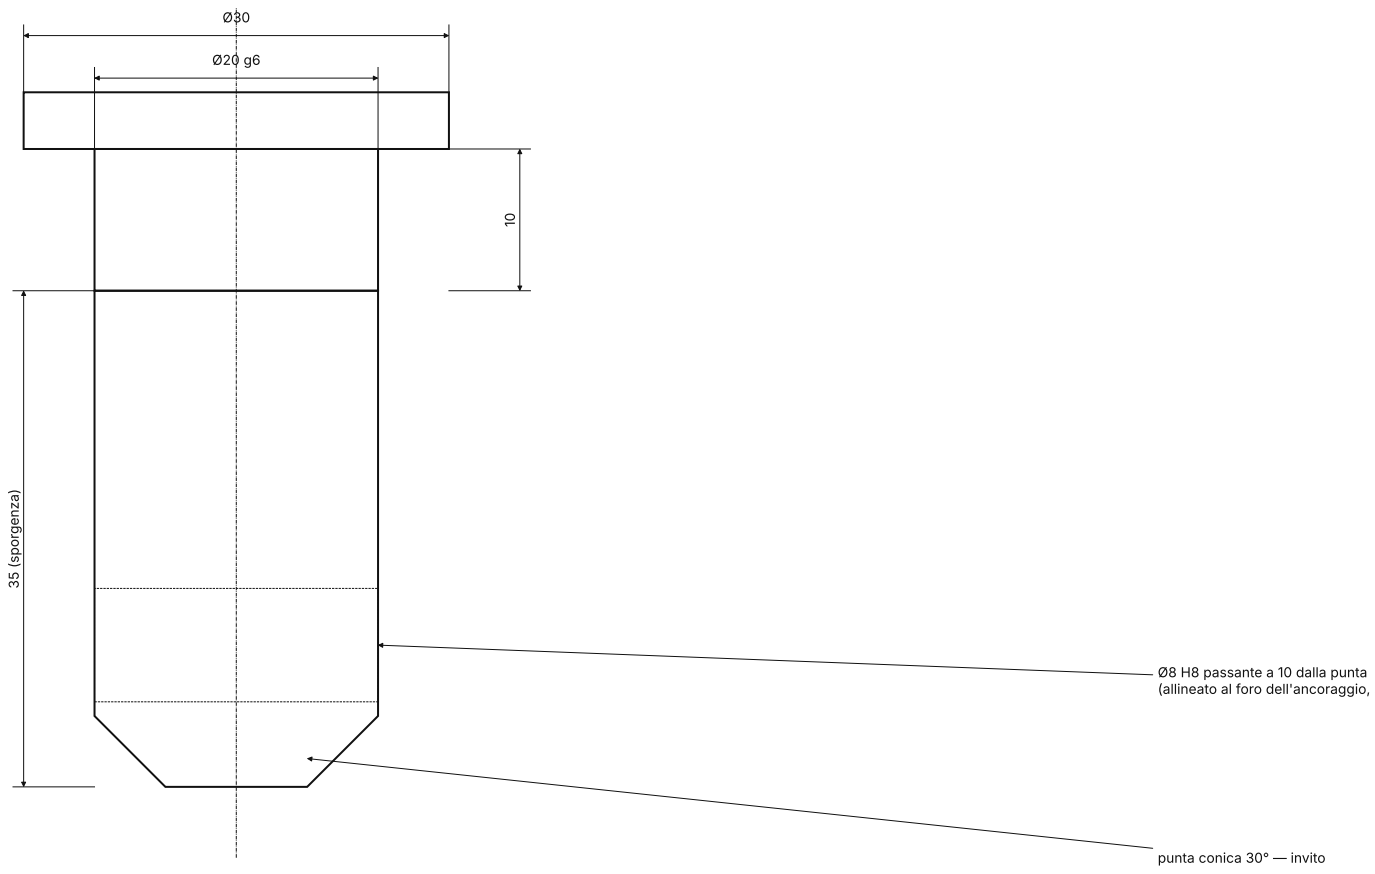
[picture p77: figure]
35 (sporgenza); punta conica 30° — invito; Ø8 H8 passante a 10 dalla punta

(allineato al foro dell'ancoraggio, solo A1/A2)

Montaggio: piantato nella piastra piede PIE-01 dal sopra (battuta Ø30) e saldato a punti; coassialità con il montante 0,2.

Perno a sfere per bloccaggio: Ø8 × 110 utile con anello (tipo GN 113 / KIPP K0790) — acquisto.

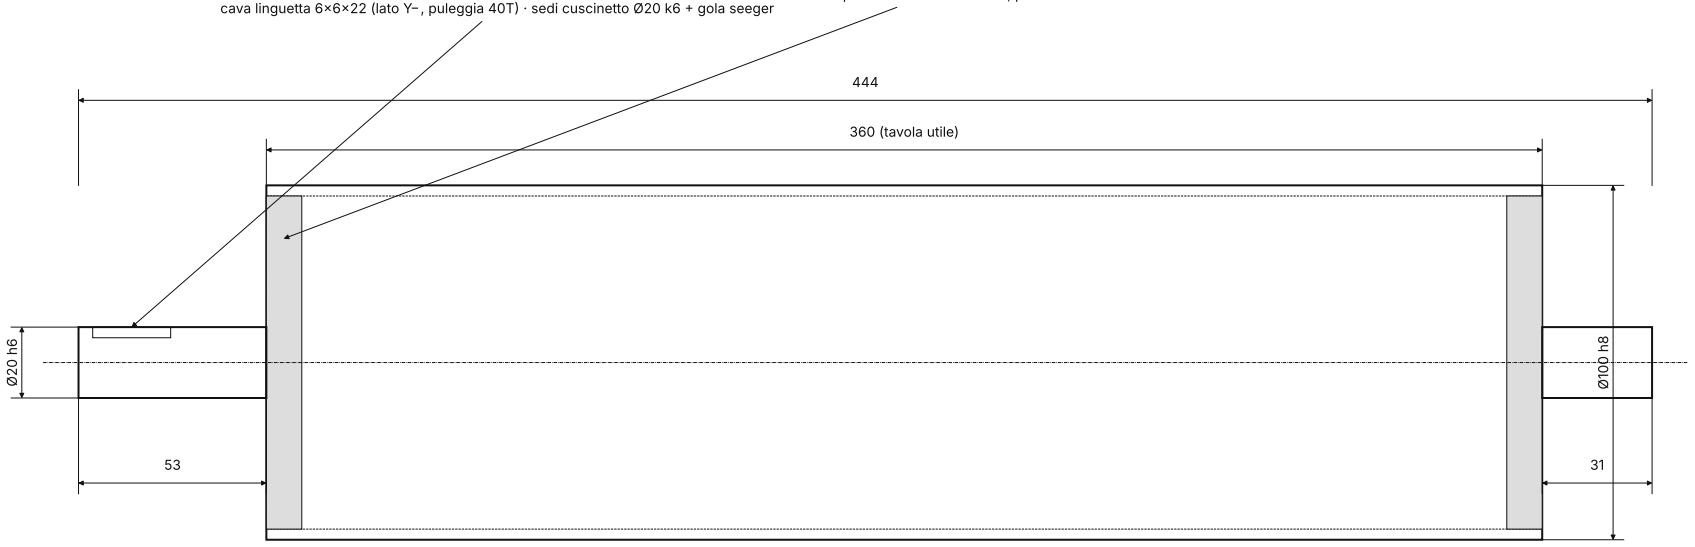
[picture p78: figure]
360 (tavola utile)

MANIPMASTA | RUL-01 Rullo di laminazione | Tav. 05

Materiale

## Tubo AISI 304 Ø100×3 + perni 304

Quantità
Fornitura

## Tornitore (rettifica)

## RULLO — vista e sezione (scala 1:2)

cava linguetta 6×6×22 (lato Y−, puleggia 40T) · sedi cuscinetto Ø20 k6 + gola seeger testate sp. 10 saldate TIG a tenuta, passivate

Superficie di lavoro: rettificata e lucidata Ra ≤ 0,8 µm, nessuna porosità; eccentricità 0,03; equilibratura statica.

Perni: tornire dopo saldatura testate, in un'unica presa tra le punte (coassialità perni/superficie 0,02).

Alternativa alimentare leggera: barra piena POM-C Ø100 con perni inox passanti incollati e spinati.

Montaggio: cuscinetti inox S6204-2RS nelle sedi delle slitte ZSL-01/02, chiusi dai coperchi COP-01. Raschietto RAS-01 in POM-C.

## TABELLA FORI

Foro | X | Y | Tipo

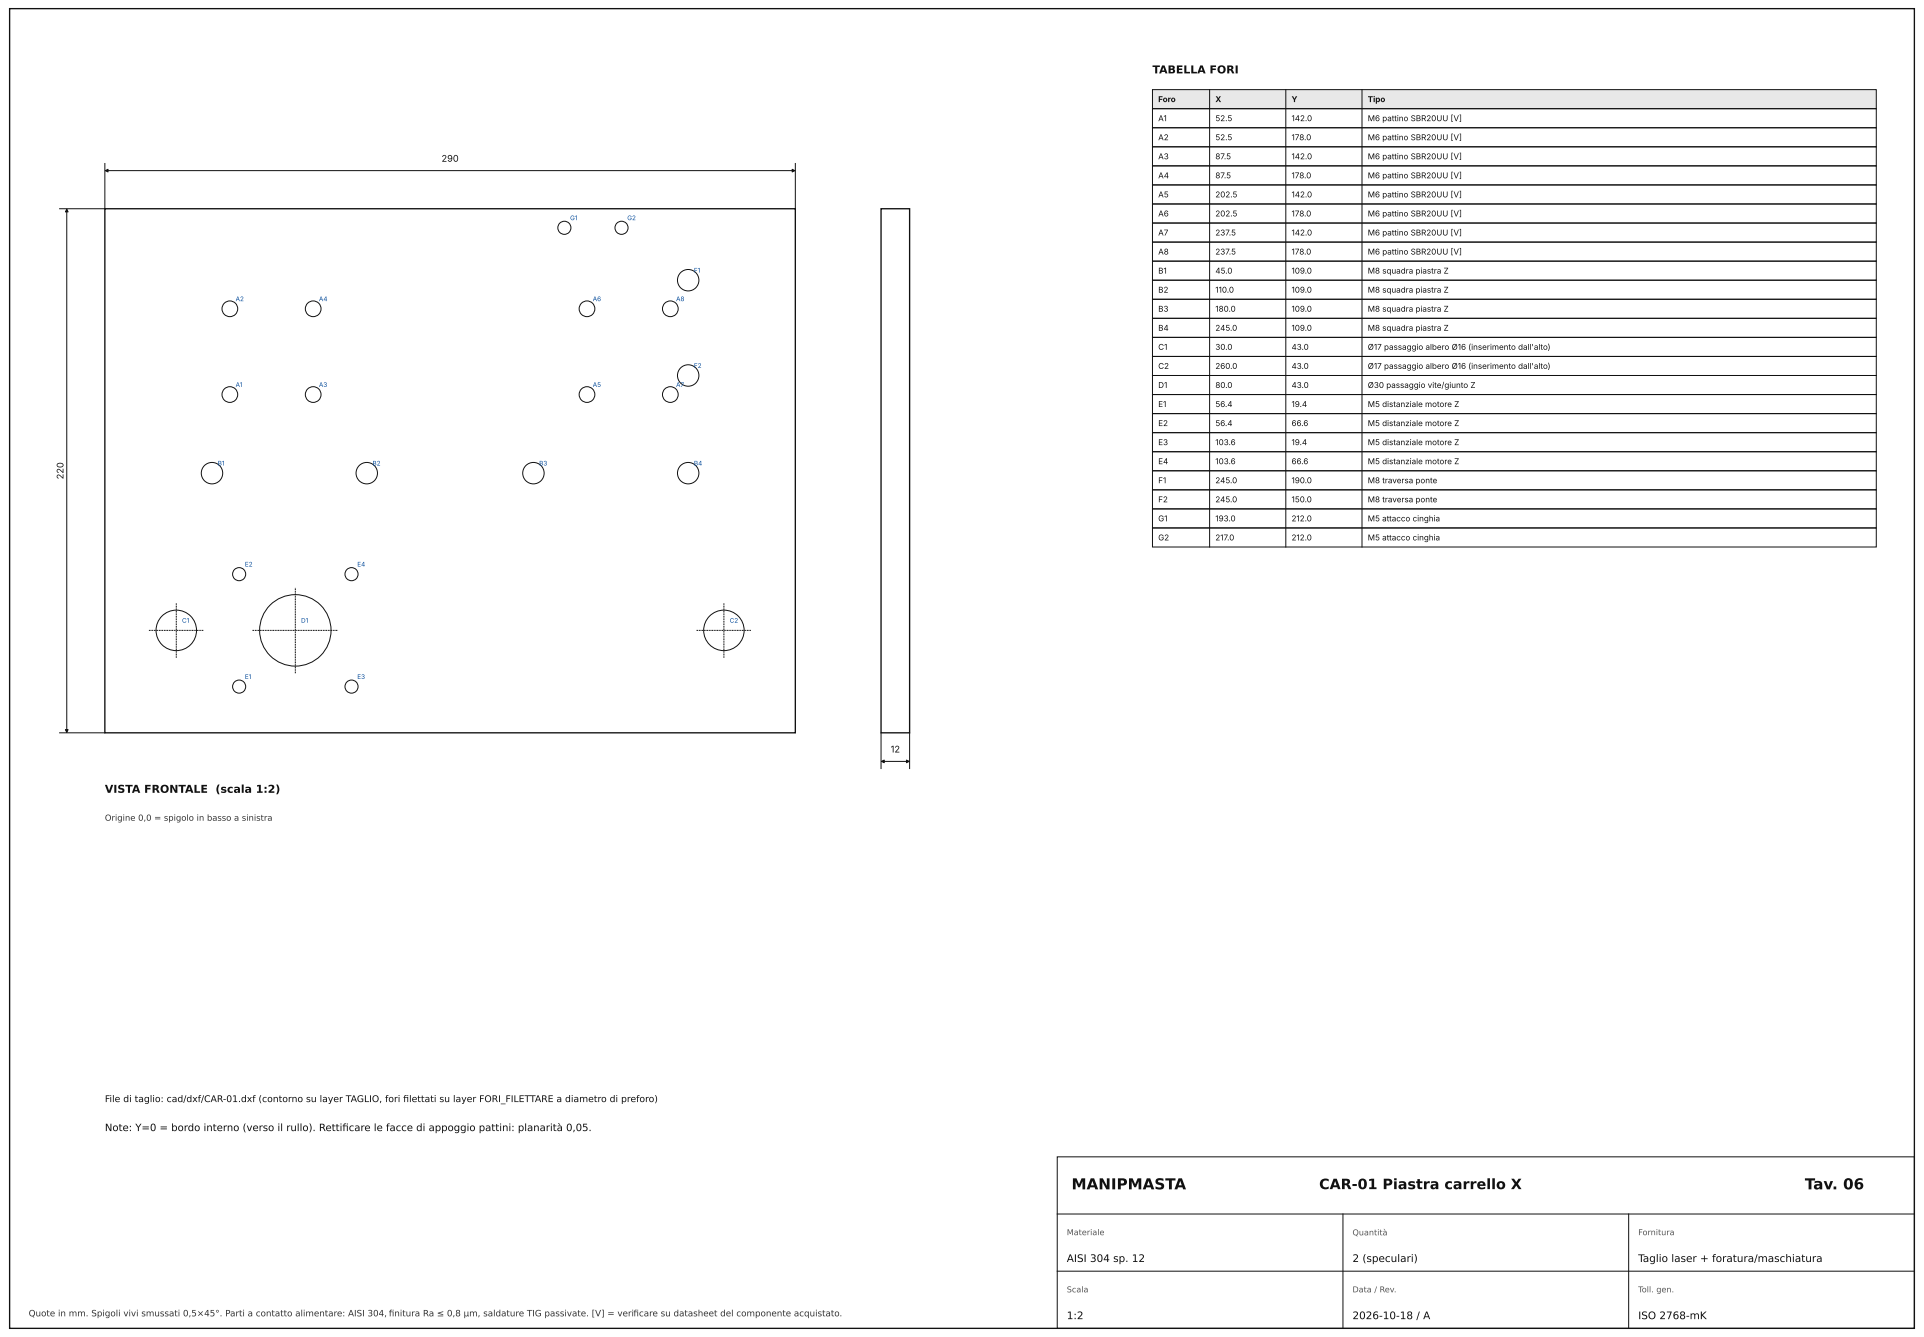
[picture p79: page 7]
MANIPMASTA; CAR-01 Piastra carrello X; Tav. 06; Materiale; AISI 304 sp. 12; Quantità; 2 (speculari); Fornitura; M6 pattino SBR20UU [V]; M8 squadra piastra Z; Ø17 passaggio albero Ø16 (inserimento dall'alto); Ø30 passaggio vite/giunto Z; M5 distanziale motore Z; M8 traversa ponte; M5 attacco cinghia

VISTA FRONTALE (scala 1:2)

Origine 0,0 = spigolo in basso a sinistra

File di taglio: cad/dxf/CAR-01.dxf (contorno su layer TAGLIO, fori filettati su layer FORI_FILETTARE a diametro di preforo)

Note: Y=0 = bordo interno (verso il rullo). Rettificare le facce di appoggio pattini: planarità 0,05.

Taglio laser + foratura/maschiatura

Foro | X | Y | Tipo

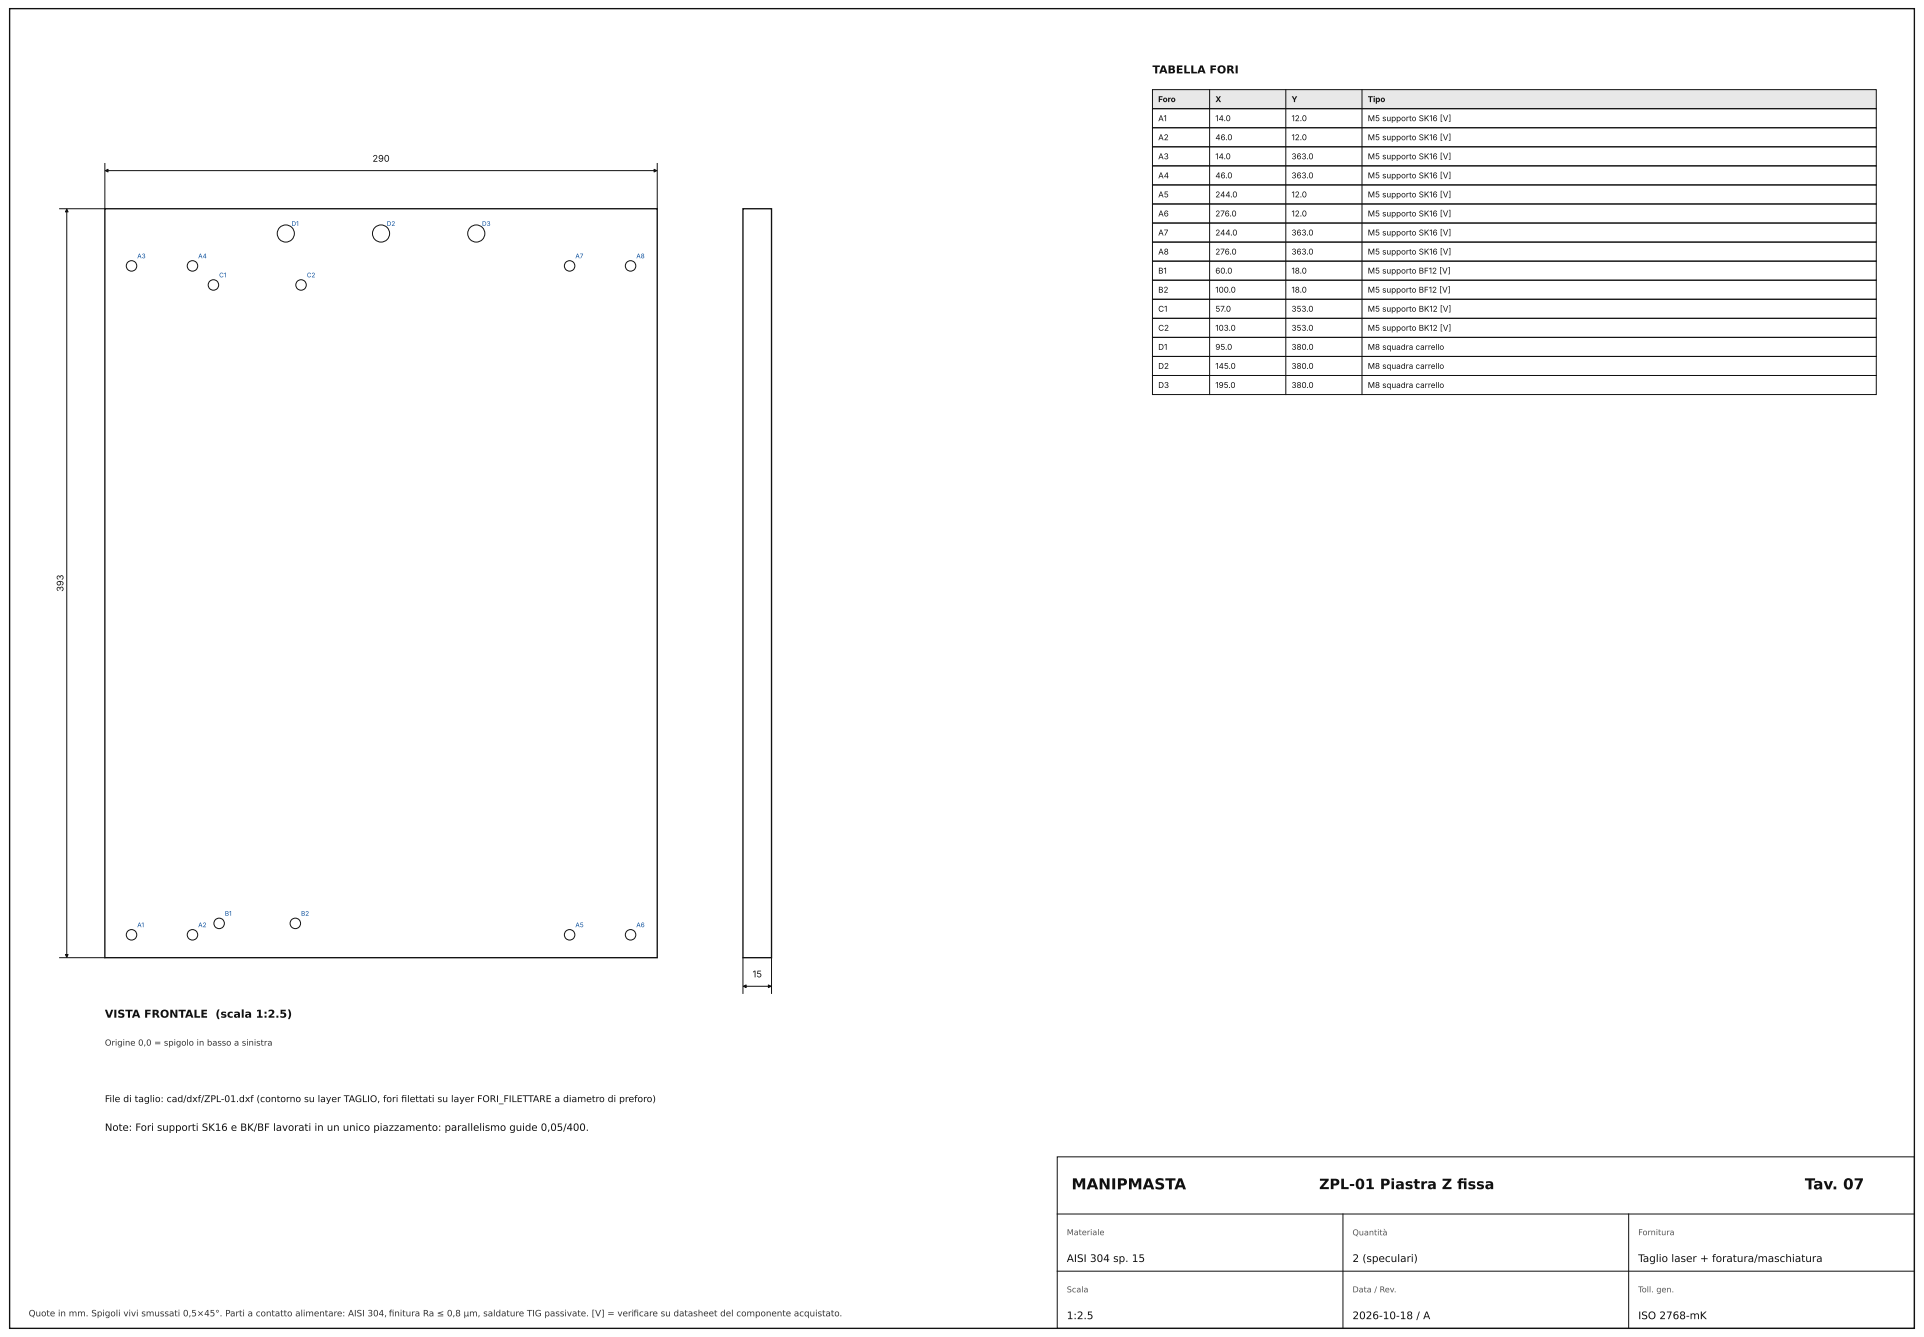
[picture p80: page 8]
MANIPMASTA; ZPL-01 Piastra Z fissa; Tav. 07; Materiale; Quantità; 2 (speculari); Fornitura; M5 supporto SK16 [V]; M5 supporto BF12 [V]; M5 supporto BK12 [V]; M8 squadra carrello

VISTA FRONTALE (scala 1:2.5)

Origine 0,0 = spigolo in basso a sinistra

File di taglio: cad/dxf/ZPL-01.dxf (contorno su layer TAGLIO, fori filettati su layer FORI_FILETTARE a diametro di preforo)

Note: Fori supporti SK16 e BK/BF lavorati in un unico piazzamento: parallelismo guide 0,05/400.

Foro | X | Y | Tipo

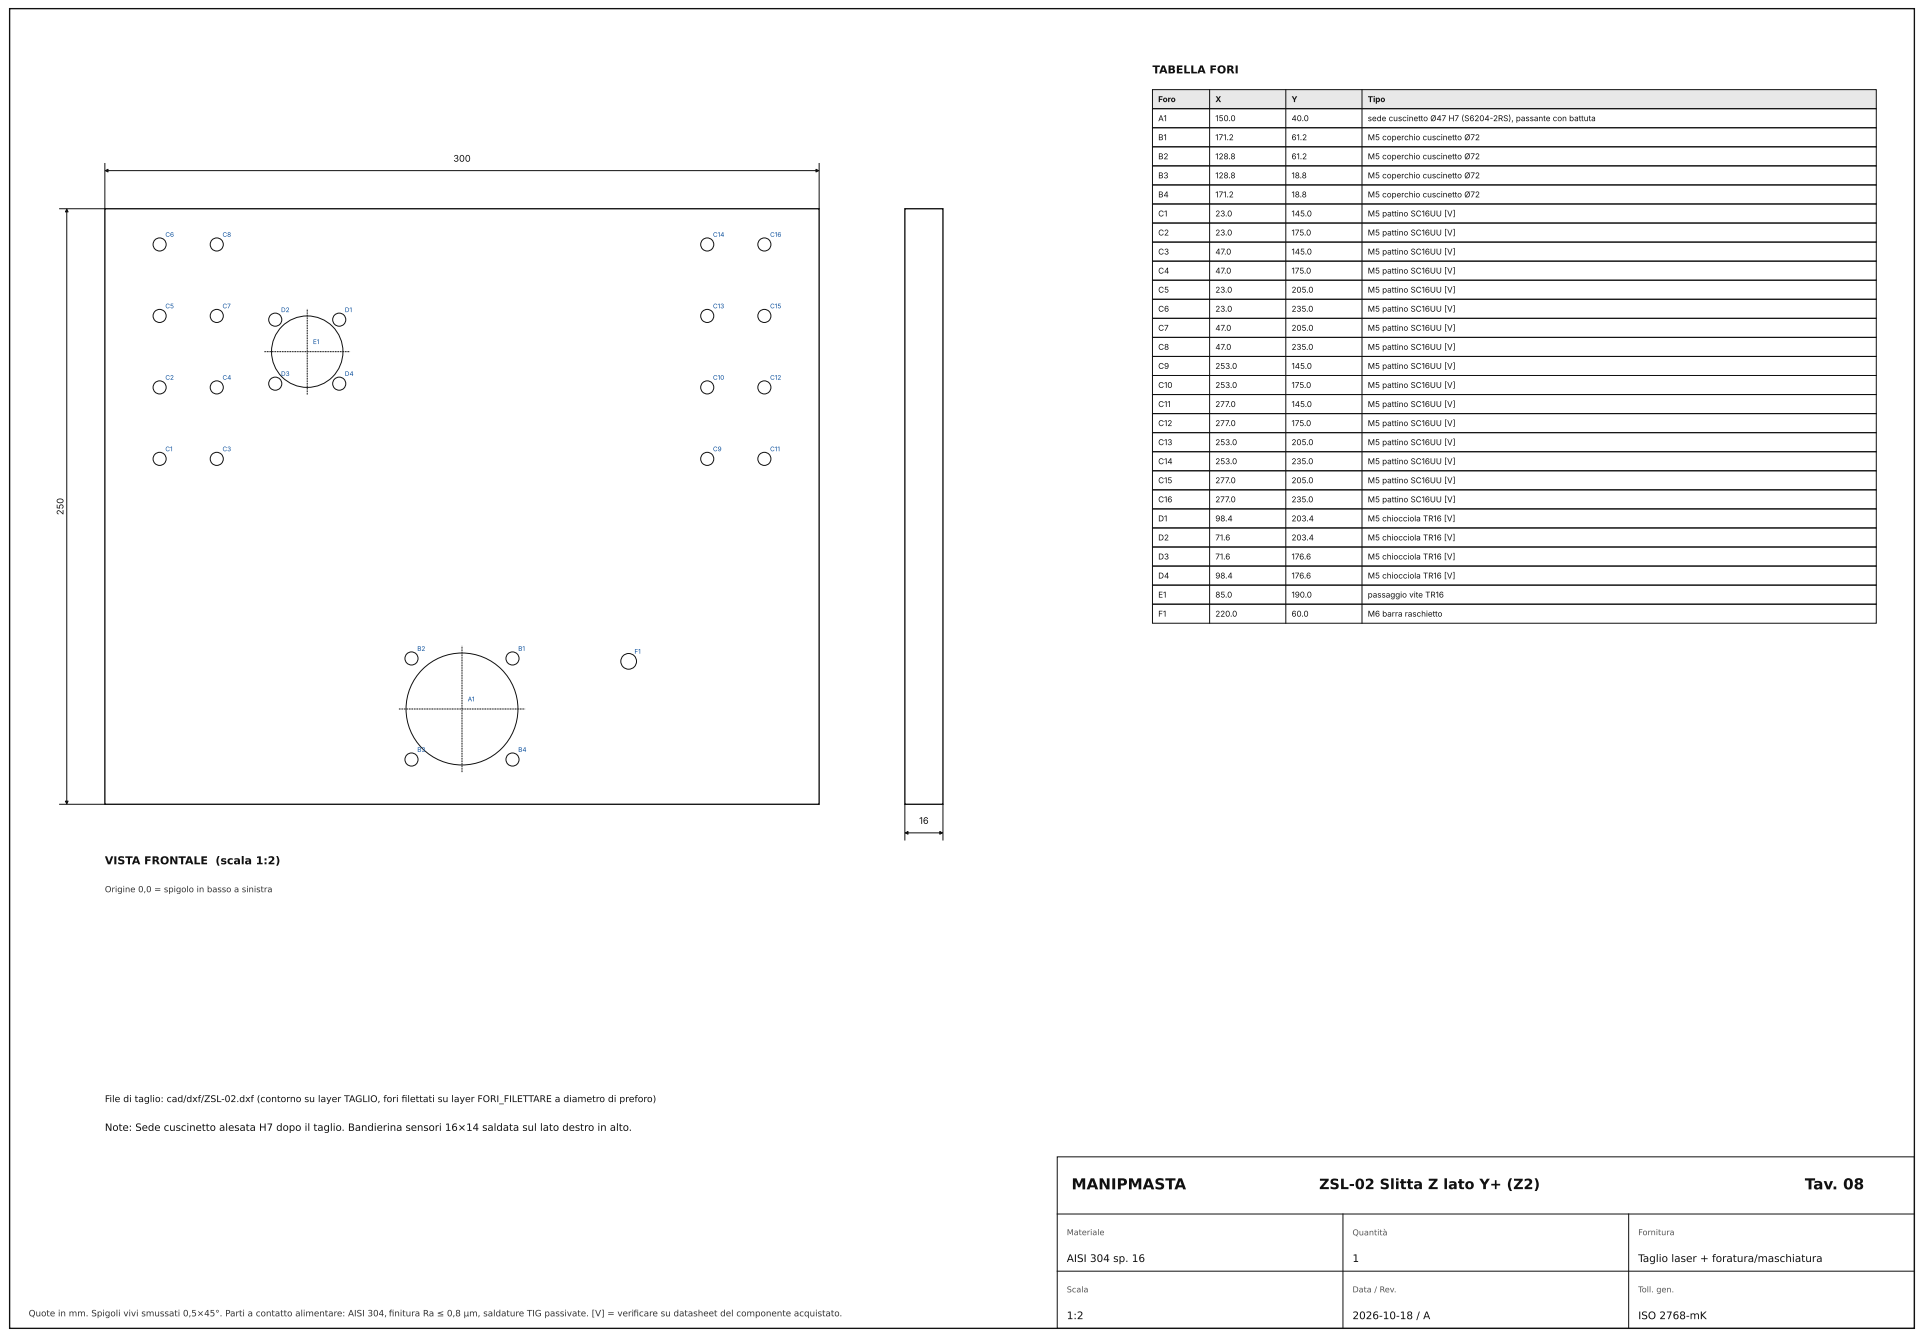
[picture p81: page 9]

Origine 0,0 = spigolo in basso a sinistra

File di taglio: cad/dxf/ZSL-02.dxf (contorno su layer TAGLIO, fori filettati su layer FORI_FILETTARE a diametro di preforo)

Note: Sede cuscinetto alesata H7 dopo il taglio. Bandierina sensori 16×14 saldata sul lato destro in alto.

Foro | X | Y | Tipo

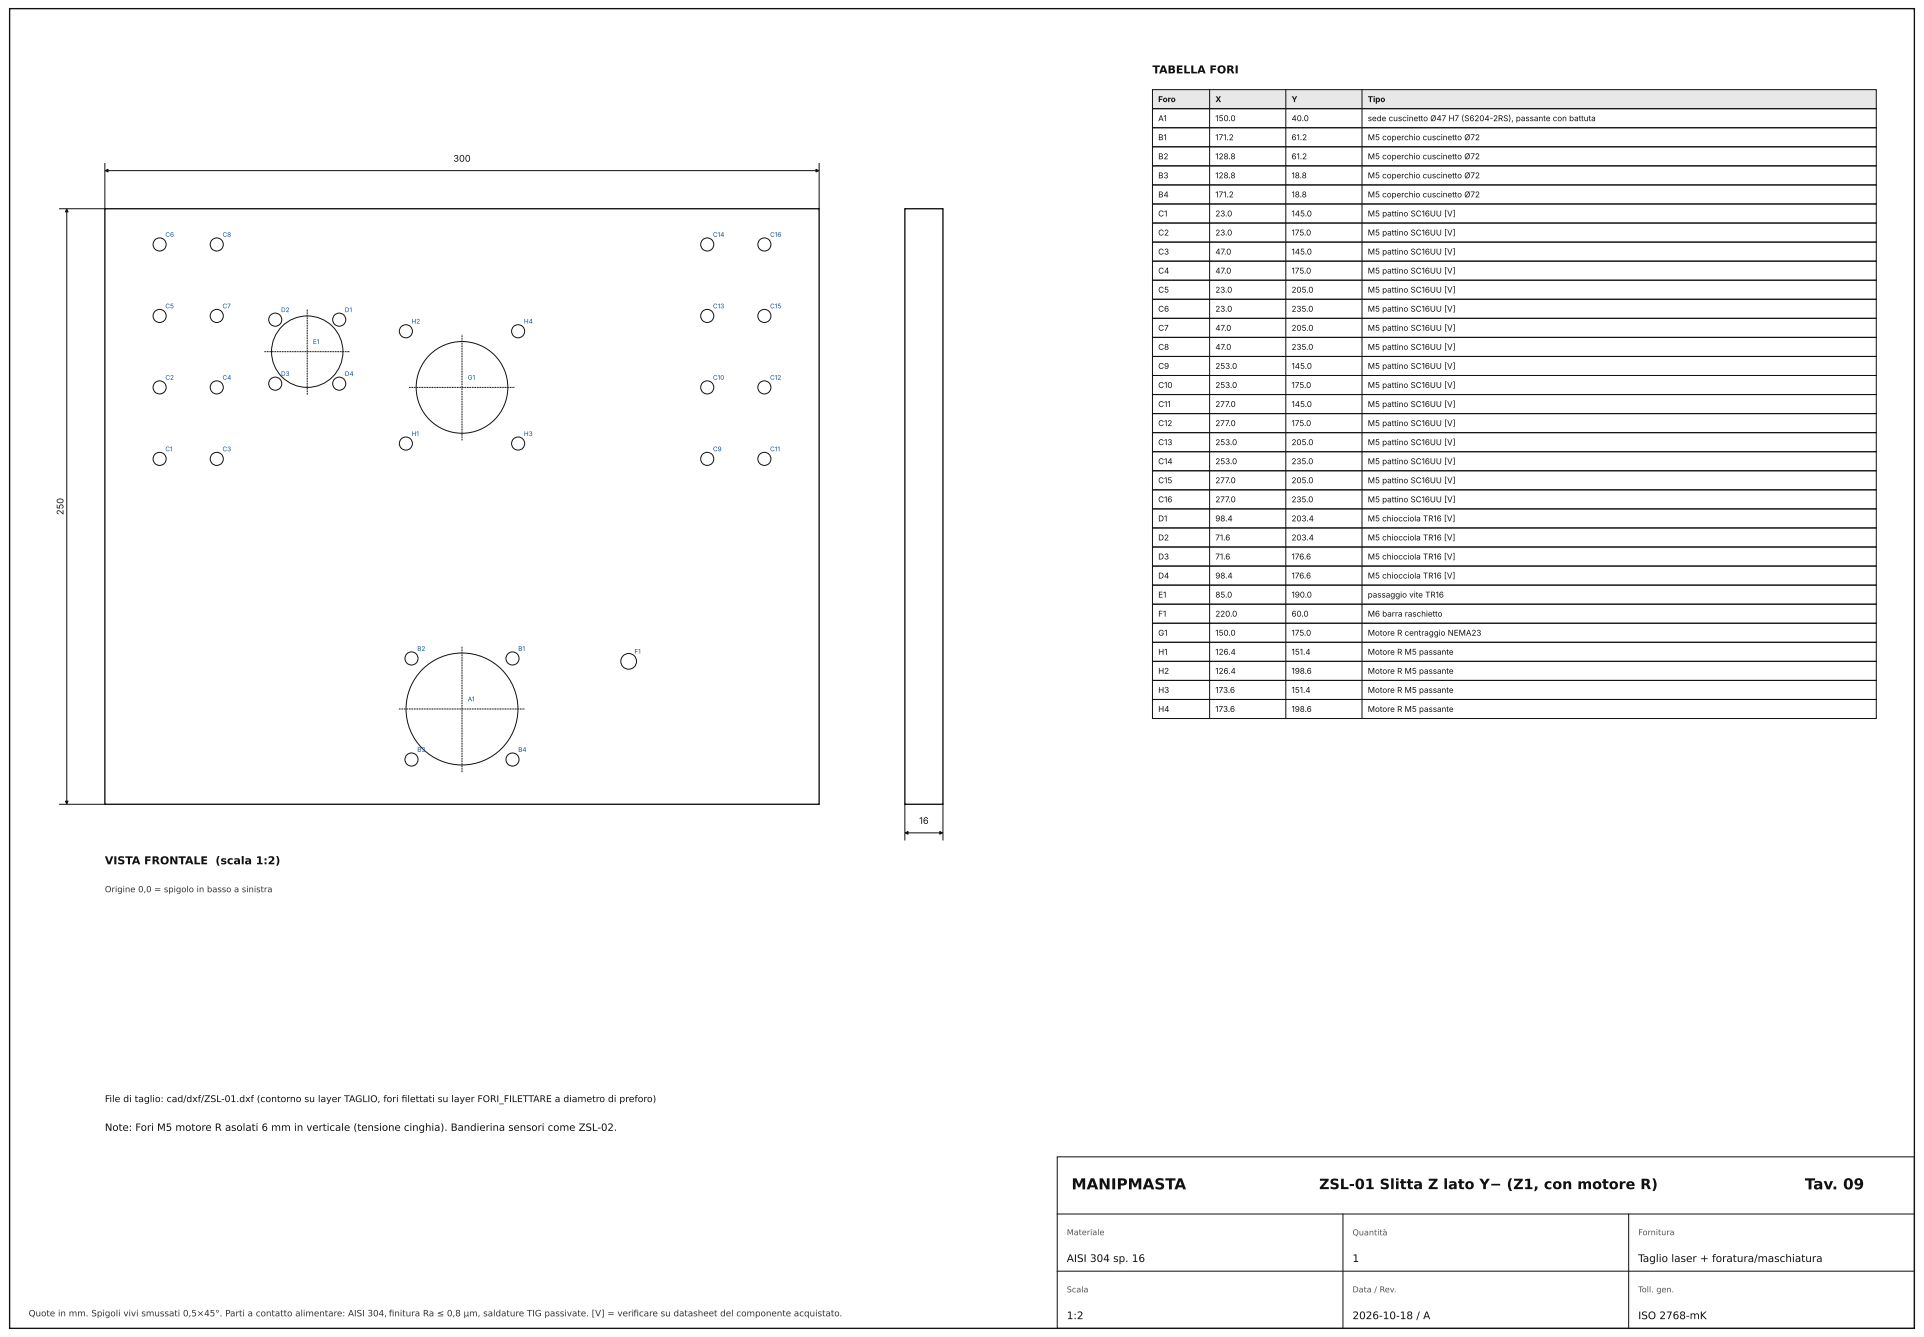
[picture p82: page 10]

Origine 0,0 = spigolo in basso a sinistra

File di taglio: cad/dxf/ZSL-01.dxf (contorno su layer TAGLIO, fori filettati su layer FORI_FILETTARE a diametro di preforo)

Note: Fori M5 motore R asolati 6 mm in verticale (tensione cinghia). Bandierina sensori come ZSL-02.

Foro | X | Y | Tipo

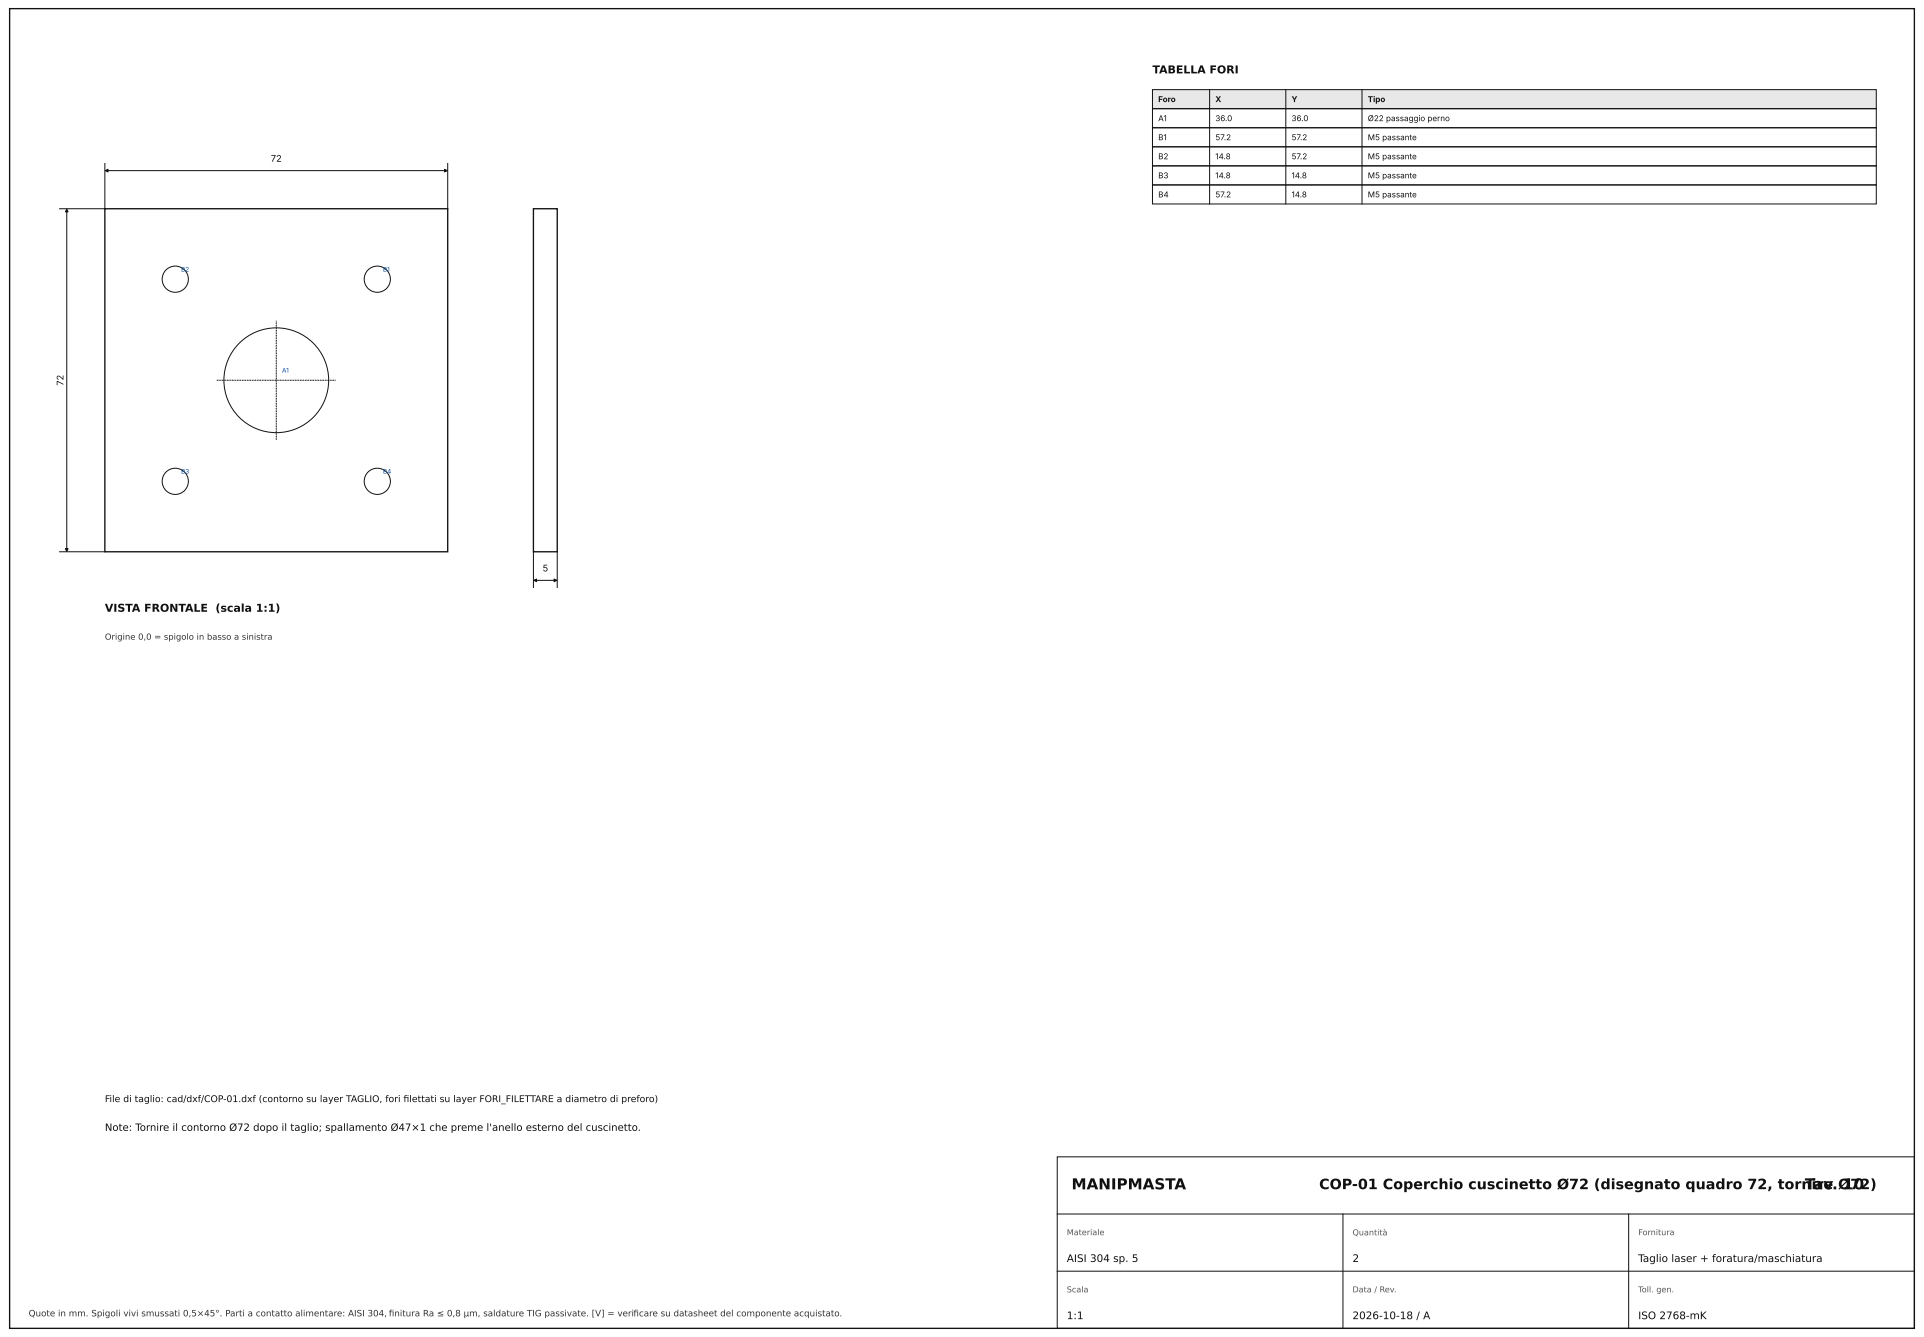
[picture p83: page 11]
MANIPMASTA; COP-01 Coperchio cuscinetto Ø72 (disegnato quadro 72, tornire Ø72) Tav. 10; Materiale; Quantità; Fornitura; Ø22 passaggio perno; M5 passante

VISTA FRONTALE (scala 1:1)

Origine 0,0 = spigolo in basso a sinistra

File di taglio: cad/dxf/COP-01.dxf (contorno su layer TAGLIO, fori filettati su layer FORI_FILETTARE a diametro di preforo)

Note: Tornire il contorno Ø72 dopo il taglio; spallamento Ø47×1 che preme l'anello esterno del cuscinetto.

Foro | X | Y | Tipo

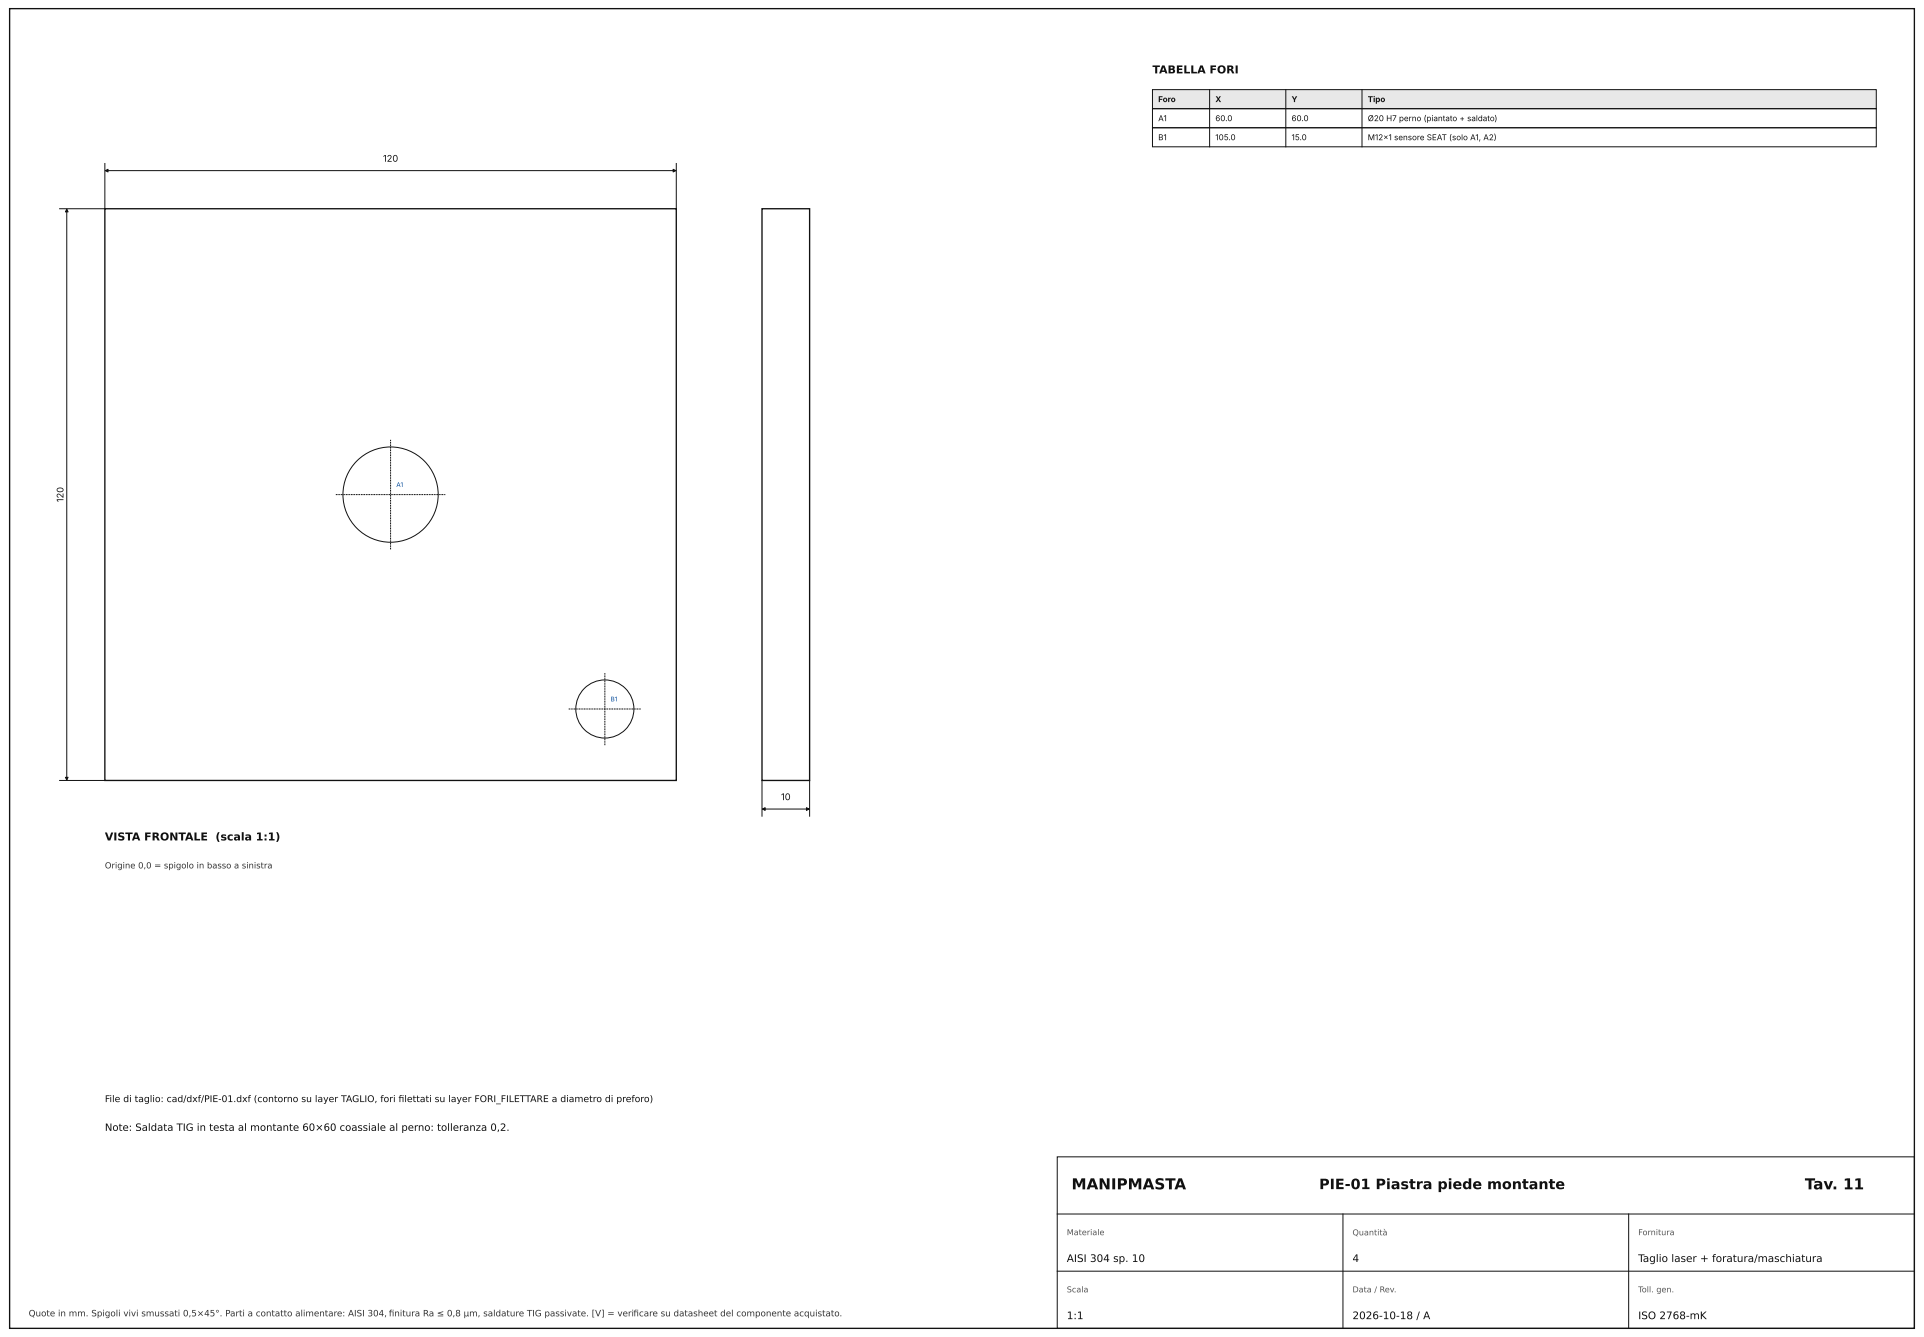
[picture p84: page 12]
MANIPMASTA; PIE-01 Piastra piede montante; Tav. 11; Materiale; Quantità; Fornitura; Ø20 H7 perno (piantato + saldato); M12×1 sensore SEAT (solo A1, A2)

VISTA FRONTALE (scala 1:1)

Origine 0,0 = spigolo in basso a sinistra

File di taglio: cad/dxf/PIE-01.dxf (contorno su layer TAGLIO, fori filettati su layer FORI_FILETTARE a diametro di preforo)

Note: Saldata TIG in testa al montante 60×60 coassiale al perno: tolleranza 0,2.

Foro | X | Y | Tipo

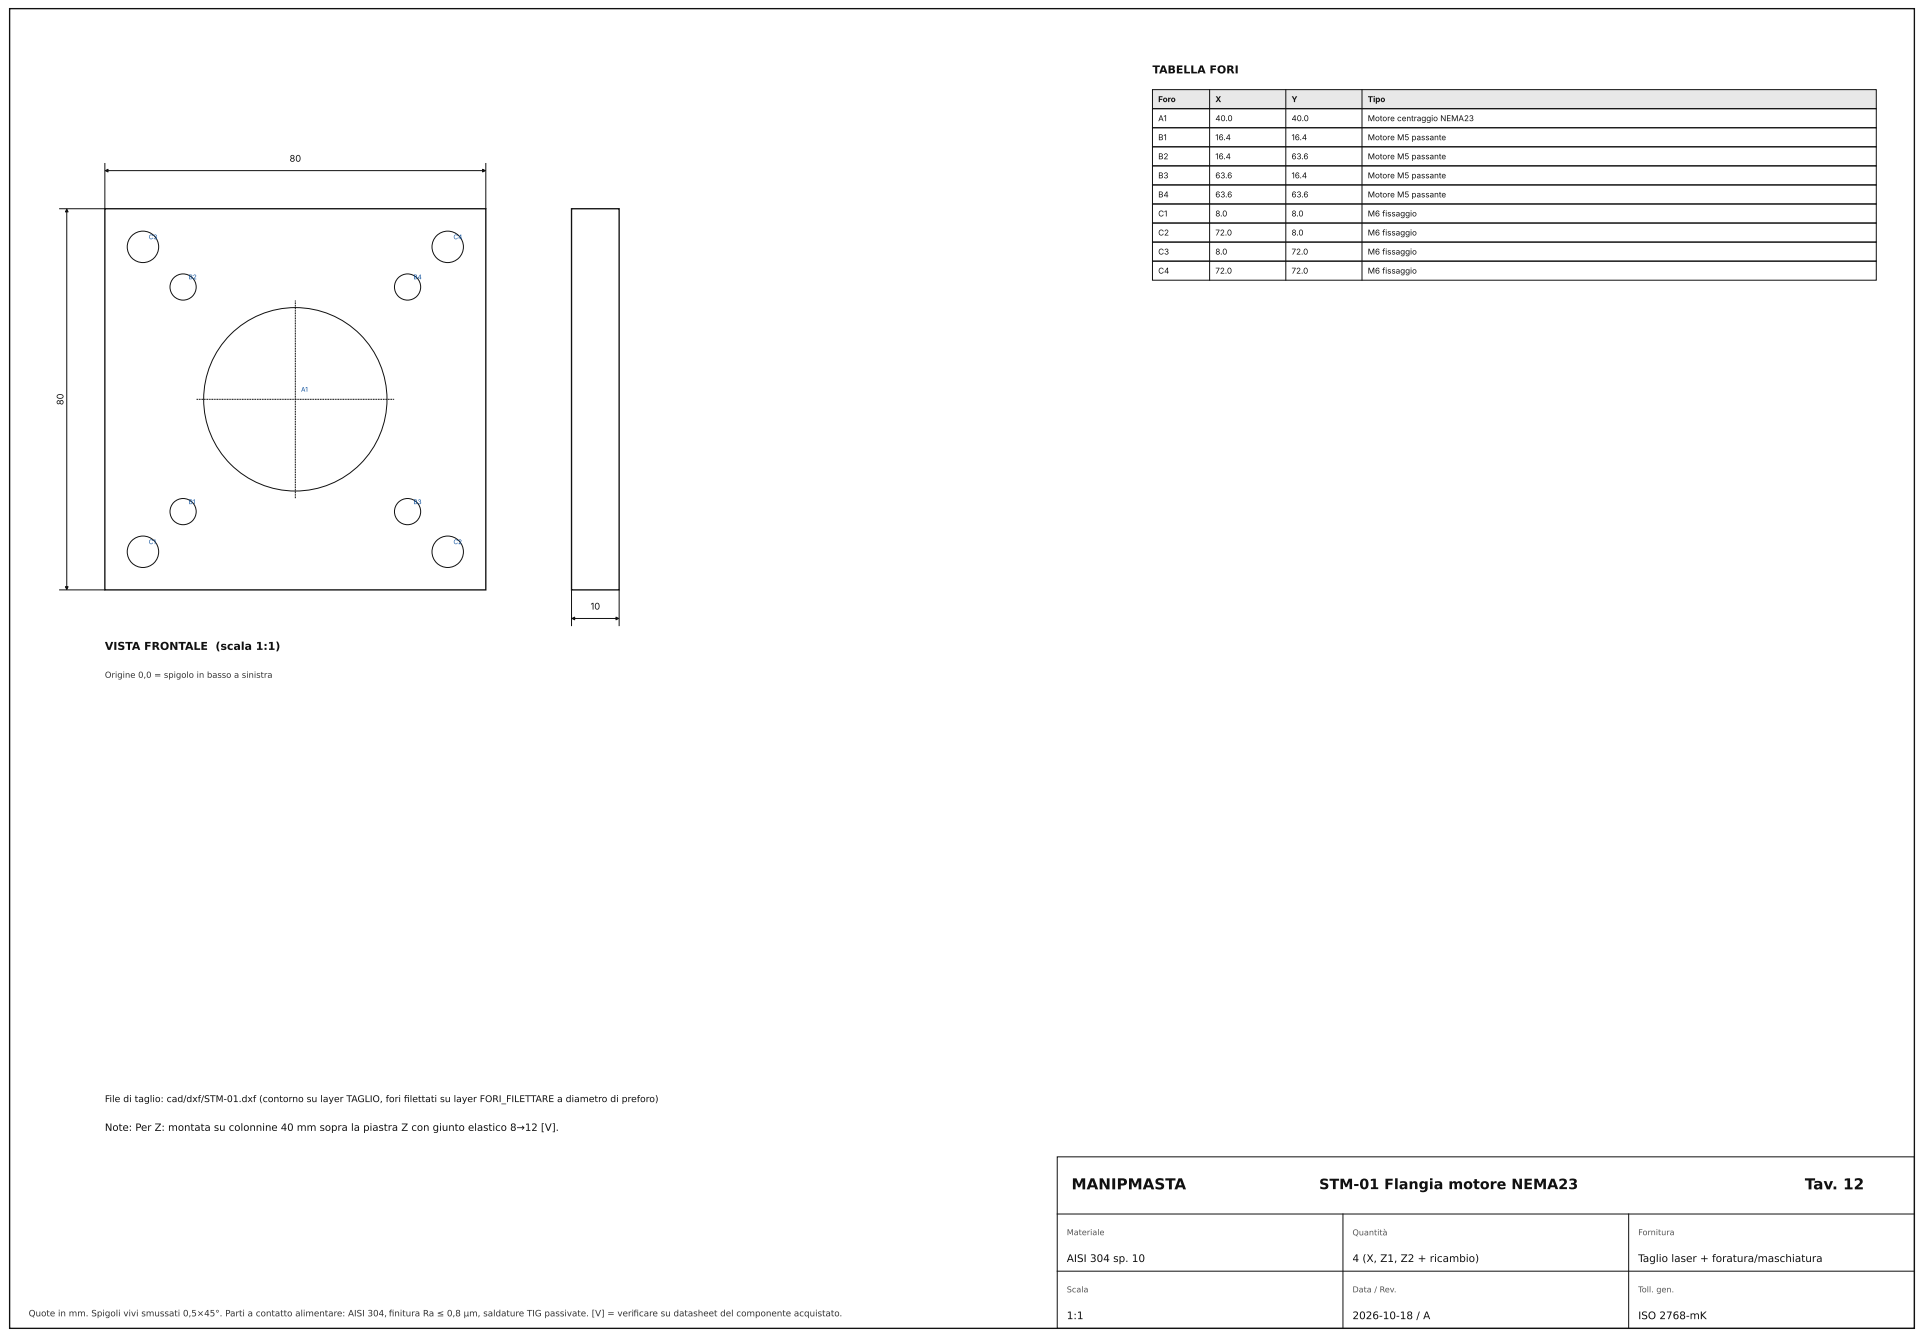
[picture p85: page 13]
MANIPMASTA; STM-01 Flangia motore NEMA23; Tav. 12; Materiale; Quantità; 4 (X, Z1, Z2 + ricambio); Fornitura; Motore centraggio NEMA23; Motore M5 passante; M6 fissaggio

VISTA FRONTALE (scala 1:1)

Origine 0,0 = spigolo in basso a sinistra

File di taglio: cad/dxf/STM-01.dxf (contorno su layer TAGLIO, fori filettati su layer FORI_FILETTARE a diametro di preforo)

Note: Per Z: montata su colonnine 40 mm sopra la piastra Z con giunto elastico 8→12 [V].

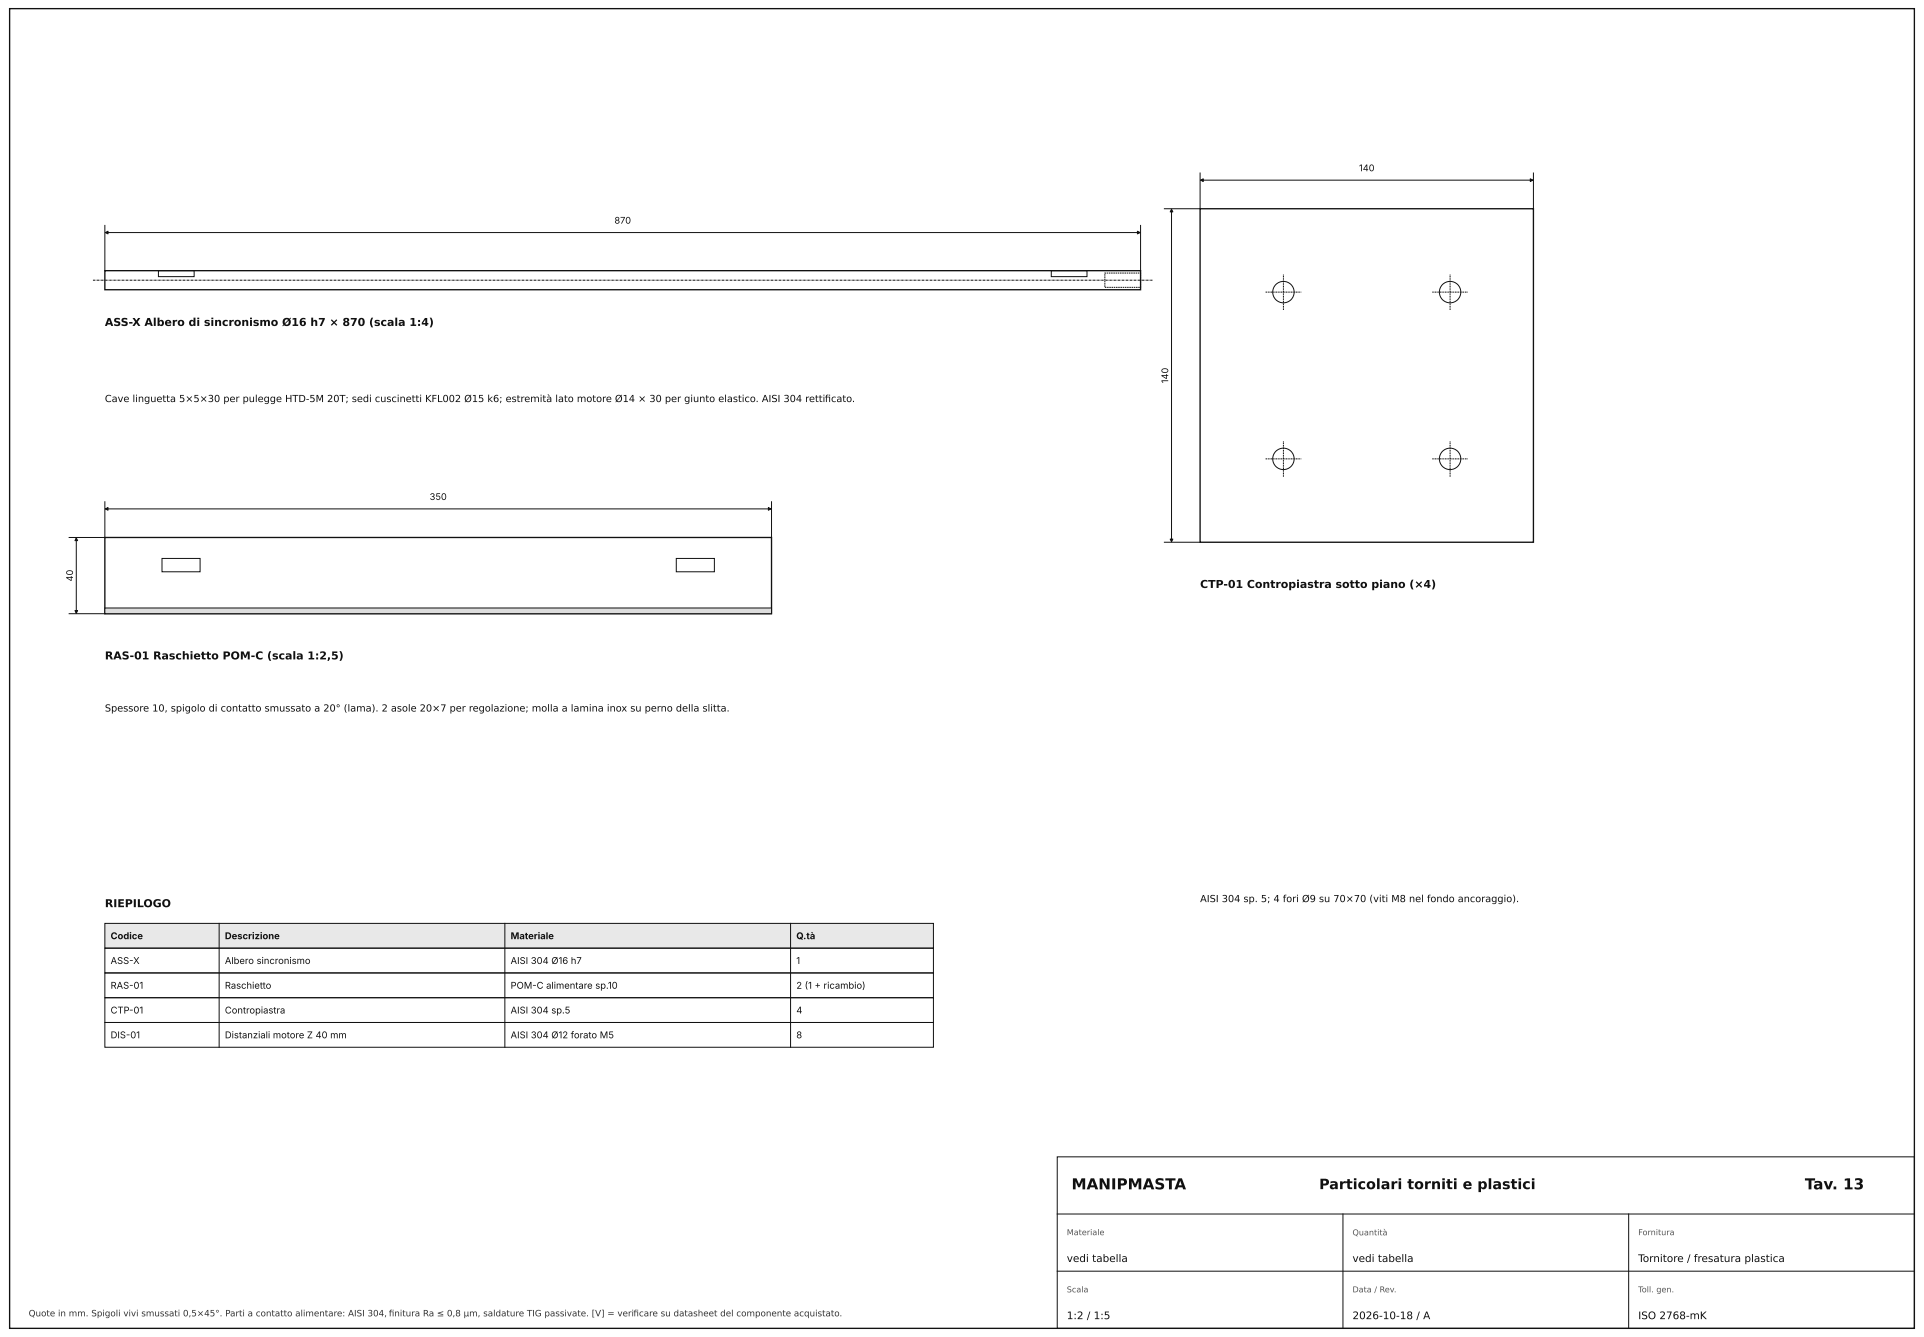
[picture p86: page 14]
MANIPMASTA; Particolari torniti e plastici; Tav. 13; Materiale; vedi tabella; Quantità; Fornitura; Codice; Descrizione; ASS-X; Albero sincronismo; AISI 304 Ø16 h7; RAS-01; Raschietto; POM-C alimentare sp.10; 2 (1 + ricambio); CTP-01; Contropiastra; AISI 304 sp.5; DIS-01; Distanziali motore Z 40 mm; AISI 304 Ø12 forato M5

ASS-X Albero di sincronismo Ø16 h7 × 870 (scala 1:4)

Cave linguetta 5×5×30 per pulegge HTD-5M 20T; sedi cuscinetti KFL002 Ø15 k6; estremità lato motore Ø14 × 30 per giunto elastico. AISI 304 rettificato.

CTP-01 Contropiastra sotto piano (×4)

RAS-01 Raschietto POM-C (scala 1:2,5)

Spessore 10, spigolo di contatto smussato a 20° (lama). 2 asole 20×7 per regolazione; molla a lamina inox su perno della slitta.

AISI 304 sp. 5; 4 fori Ø9 su 70×70 (viti M8 nel fondo ancoraggio). RIEPILOGO

Tornitore / fresatura plastica
