giacomobuzi/manipmasta/(commit log)

2026-10-18 ManipMasta: progetto completo sfogliatrice a portale
    Meccanica parametrica (modello 3D con esploso, tavole A3, DXF laser), distinta acquisti/artigiani,
    schemi elettrici E01-E05, firmware Arduino Mega + test host, server FastAPI/Mosquitto con UI web e
    simulatore, app Android con build GitHub Actions.
    Claude-Session: https://claude.ai/code/session_01H9adJsqzSggaSJo74G6Rtt
    [CAR-01.dxf, ManipMasta_distinta.xlsx, PIE-01.dxf, STM-01.dxf, ZPL-01.dxf, ZSL-01.dxf, ZSL-02.dxf, acquisti.csv]
2026-10-18 3D di dettaglio, visite guidate e istruzioni di montaggio
    - Modello 3D rifatto con parti fini: carrelli X, moduli Z (SK16, SC16UU, TR16, BK/BF12),
    motori NEMA23 con giunti, motore R su slitta, catena portacavi, quadro inox con interno
    - Viewer: schede Esplora / Come funziona (motori, closed-loop, assi X-Z-R, quadro con
    sportello) / Montaggio (15 fasi animate con frecce)
    - ManipMasta_montaggio.pdf con fasi, viteria, coppie e controlli
    - Tavole aggiornate: carrello 290x220, slitta 300x250x16 con cuscinetto 6204, coperchio COP-01
    - Schemi E01/E02/E03/E05: KM1+KM2 in serie, pull-up ENA 680 ohm, quadro 500x400x250
    Claude-Session: https: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
    [CAR-01.dxf, COP-01.dxf, ManipMasta_distinta.xlsx, PIE-01.dxf, STM-01.dxf, ZPL-01.dxf, ZSL-01.dxf, ZSL-02.dxf]
